fvyshkov/newton/truss/README.md

# Truss-вариант 8" f/5.9 Dobsonian

Альтернатива сонотубу: разборная ферменная конструкция на 4 алюминиевых трубках. Цель — лёгкая транспортировка, простая коллимация, материалы доступные в Израиле без AliExpress.

📘 **Сборка по шагам (без слов, картинками):** [`truss_assembly_comic.pdf`](truss_assembly_comic.pdf)

## Оптика (исходные данные)

| Параметр | Значение |
|---|---|
| Главное зеркало | 203мм (8") |
| Фокусное расстояние | 1200мм (f/5.91) |
| Вторичное зеркало | 50мм малая ось |
| Окуляры | 25мм и 10мм, 1.25" |
| Фокусер | геликоидный (как в основном проекте, можно перепечатать) |

## Архитектура

```
        ┌───────────────────┐    ← UTA (Upper Tube Assembly)
        │   ●─── focuser    │      ID 240мм, h ≈ 130мм
        │  ╱│╲              │      держит вторичку (паук) + фокусер
        │ paук              │
        └─┬─┬─┬─┬───────────┘
          │ │ │ │              ← 4 стойки, L ≈ 900мм
          │ │ │ │                Ø22-28мм (универсальный сокет
          │ │ │ │                с хомутным зажимом)
          │ │ │ │
        ┌─┴─┴─┴─┴───────────┐
        │                   │  ← Mirror box (открытая рамка)
        │   [ оправа ]      │     250×250мм, h ≈ 120мм
        │                   │     держит оправу зеркала + truss
        └───────────────────┘
                │
                ▼
            (rocker box — основание Добсона, отдельно)
```

## Расчёт оптической геометрии

### Расстояние secondary → focal point (D2)

| Элемент | мм |
|---|---|
| Полу-ID UTA (от оси трубы до стенки) | 120 |
| Толщина стенки UTA (печатная) | 10 |
| Седло фокусера (на стенке UTA) | 10 |
| Тело фокусера (внешний корпус) | 60 |
| Inner tube фокусера, среднее положение | 30 |
| От верха inner до полевой диафрагмы окуляра | 10 |
| **D2 итого** | **~240** |

### Расстояние primary → secondary (D1)

```
D1 = f − D2 = 1200 − 240 = 960 мм
```

### Длина truss-трубок

| Элемент | мм |
|---|---|
| От поверхности зеркала до верха mirror box (где сидят трубки) | 80 |
| От низа UTA (где сидят трубки) до центра вторички | 80 |
| Полезный пролёт между сокетами | 800 |
| Захват в сокете (×2 конца, по 50мм) | 100 |
| **Длина трубки** | **900** |

## Список деталей

### Покупное (Израиль, локально)

**Стойки — выбрать одно из:**

| Вариант | Диаметр | Где | Цена за 4шт |
|---|---|---|---|
| Алюм. ручка от швабры (приоритет) | Ø22-24мм | Ace, חזק, супермаркет | ₪40-80 |
| Алюм. карниз для душа (НЕ телескопический) | Ø25мм | Home Center, хозмаг | ₪60-100 |
| Деревянная ручка швабры (бук/берёза) | Ø25-28мм | везде | ₪40-60 |

Длина каждой стойки = 1000мм (с запасом для отпила в размер 900мм).

**Остальное:**

| Деталь | Кол-во | Где взять |
|---|---|---|
| Болты M5×30 (зажим стоек в сокетах) | 4 | хозмаг |
| Барашковые гайки M5 | 4 | хозмаг |
| Фанера 12-15мм для rocker box | 1 лист | Home Center, столярка |
| Войлок/тефлон для подшипников Добсона | — | хозмаг |

### Печать (3D)

| Деталь | Кол-во | Назначение |
|---|---|---|
| `Mirror_box.stl` | 1 | нижняя клетка-короб 290×290мм с 3 отверстиями под вертикальные болты M5 крепления оправы |
| `Truss_socket.stl` | 8 | клипса-зажим под стойку (4 на mirror box + 4 на UTA, деталь одинаковая) |
| `Mirror_cell_back_truss.stl` | 1 | задняя плита оправы заодно с 3 ножками: ставится в коробку, садится углублениями на бобышки дна, притягивается 3 болтами M5 снизу. Заменяет старую `Mirror_cell_back` + отдельные кронштейны. Регулировка — штатным push-pull |
| `UTA_ring.stl` | 1 | верхнее кольцо с сокетами под стойки, посадка фокусера |
| `Spider_4vane.stl` | 1 | 4-лопастной паук под ID 240мм |
| `Secondary_holder.stl` | 1 | держатель вторички с коллимацией |
| **Итого** | **13** | — |

> `Cell_leg_bracket.stl` (отдельный кронштейн ×3) — устарел, объединён в `Mirror_cell_back_truss.stl`.

### Переиспользуется из старого проекта без изменений

| Деталь | Откуда |
|---|---|
| `Mirror_cell_front.stl` | `/Users/mac/newton/stl/mirror_cell/` |
| Фокусер (комплект из 7 деталей) | `/Users/mac/newton/stl/` |
| Push-pull коллимация (M5×20, M5×50, гайки, барашки) | уже куплено |

### Принципы крепления трубок

Каждая трубка вставляется в печатный сокет на ~50мм глубину, фиксируется одним сквозным болтом M5 с барашковой гайкой. Снять/поставить = открутить 8 барашков. Коллимация сохраняется, потому что геометрия задаётся жёсткими углами mirror box и UTA, а не положением трубок.

## Что дальше

1. Сгенерировать чертежи каждой печатной детали (Python → STL)
2. Mirror cell под открытую раму (без трубы) — переделать крепление
3. UTA кольцо — рассчитать положение фокусера на стенке
4. Паук — 4 лопасти вместо 4-в-крест (одна и та же геометрия)
5. Rocker box — фанера, отдельные чертежи под пилу
