fvyshkov/newton/stl/README.md

# Что печатаем

12 деталей, сгруппированы по требованиям к печати.

## 🔬 Группа A — резьба и точные посадки

**Профиль:** 0.4мм сопло · 0.2мм слой (для резьбы можно 0.1мм) · **6-8 периметров** · 25-30% заполнение · ориентация важна

Главное — стенки и качество слоя, чтобы резьба не закусывала. Часть деталей образует резьбовую пару — их **печатать вместе, той же катушкой и теми же параметрами**, иначе посадка может не сойтись из-за разной усадки.

| Файл | Размер (мм) | Кол-во | Время | Заметки |
|---|---|---|---|---|
| `Focuser inner.stl` | 90×71×71 | 1 | ~5 ч | Внутренняя труба с **внешней резьбой**. Ось Z = ось резьбы |
| `Focuser outer top.stl` | 102×90×23 | 1 | ~3 ч | Верхняя половина корпуса с внутренней резьбой |
| `Focuser outer bottom.stl` | 101×90×37 | 1 | ~4 ч | Нижняя половина корпуса |
| `Focuser ring.stl` | 81×81×15 | 1 | ~2 ч | Кольцо резьбового сопряжения |
| `Collet.stl` | 59×59×28 | 1 | ~1.5 ч | Цанга, прорези должны быть чёткими |
| `Collet nut.stl` | 88×88×13 | 1 | ~2 ч | Гайка цанги, внутренняя резьба |
| `1.25 eyepiece adapter.stl` | 55×55×47 | 1 | ~2 ч | Скользящая посадка в цангу |

**Итого группа A:** 7 деталей, ~20 ч.

## 🔧 Группа B — стандартная механика

**Профиль:** 0.4мм сопло · 0.2-0.3мм слой · **4-5 периметров** · 20-25% заполнение · поддержки НЕ нужны

Никакой резьбы, обычные крепёжные/функциональные детали.

| Файл | Размер (мм) | Кол-во | Время | Заметки |
|---|---|---|---|---|
| `Secondary holder.stl` | 57×57×69 | 1 | ~5 ч | Держатель вторички, печатать на боку (большая площадь к столу) |
| `Focuser grub.stl` | 37×20×52 | 1 | ~1 ч | Фиксатор окуляра |
| `Focuser grub screw panel.stl` | 82×9×42 | 1 | ~1 ч | Тонкая, можно увеличить заполнение до 40% |
| `Focuser saddle.stl` | 101×90×11 | 1 | ~2 ч | Седло между фокусёром и трубой (компенсирует кривизну OD 258мм). Печатать **плоской стороной вверх** (вогнутое дно — на стол с поддержками), 4 периметра, 25% заполнение. Сгенерирован `gen_focuser_saddle.py` |

**Итого группа B:** 4 детали, ~9 ч.

## 🕸️ Группа C — крупное, тонкие лопасти

**Профиль:** 0.6мм сопло · 0.2-0.3мм слой · **5-6 периметров** · 20% заполнение · печать плашмя (лопасти параллельно столу)

| Файл | Размер (мм) | Кол-во | Время | Заметки |
|---|---|---|---|---|
| `Spider.stl` | 250×250×25 | 1 | ~8 ч | Лопасти 3мм — стенки критичны, иначе будут вибрировать. **Brim 5мм** для адгезии — деталь длинная, склонна отрываться |

**Итого группа C:** 1 деталь, ~8 ч.

## 🪞 Группа D — оправа главного зеркала (опционально, вместо фанеры)

**Профиль:** 0.4мм сопло · 0.2мм слой · **8+ периметров** · 30-40% gyroid · поддержки НЕ нужны · PETG-HF или ASA (НЕ PLA — ползёт под нагрузкой)

Заменяет фанерные пластины из Фазы 3 (Stellafane). Сгенерированы из `mirror_cell/generate_mirror_cell.py`. Все 6 коллимационных отверстий — клиренс под M5 (Ø6мм), резьбы нет, собирается болтами с гайками как фанерный вариант. Раскладка: 6 болтов равномерно через **60°** по кругу, чередуются push и pull. Push (внутреннее кольцо) r=70мм на углах 0°/120°/240°, pull (внешнее кольцо) r=89мм на углах 60°/180°/300° — радиусы по Stellafane-пропорциям, позиции идентичны на обеих деталях, болты идут насквозь.

| Файл | Размер (мм) | Кол-во | Время | Заметки |
|---|---|---|---|---|
| `mirror_cell/Mirror_cell_front.stl` | 215×215×16 | 1 | ~9 ч | Круглая пластина под зеркало. На верхней стороне 3 встроенных mirror-retention уголка (стеночки 3×20×8мм на радиусе 104.5мм, страховка зеркала от съезжания). Печать плашмя плитой вниз, уголки кверху — поддержек не нужно |
| `mirror_cell/Mirror_cell_back.stl` | 241×241×8 | 1 | ~10 ч | Y-плита, 3 уша до Ø250 = ID трубы. 3 сквозных радиальных Ø5.5мм отверстия в торцах ушей (по центру толщины) — под M5×12 насквозь через стенку трубы. Печать плашмя |

**Итого группа D:** 2 детали, ~20 ч.

---

## Сводка

| Группа | Деталей | Время | Что важно |
|---|---|---|---|
| A (резьба) | 7 | ~20 ч | Точность слоя, стены 6-8, печатать одной катушкой |
| B (механика) | 4 | ~9 ч | Стандартные настройки |
| C (паук) | 1 | ~8 ч | Brim, ориентация плашмя, стены 5-6 |
| D (оправа, опционально) | 2 | ~20 ч | PETG/ASA, стены 8+, gyroid 30-40% |
| **Итого без D** | **12** | **~37 ч** | базовый комплект (с фанерной оправой) |
| **Итого с D** | **14** | **~57 ч** | полностью печатный (без фанеры) |

## Материал

PLA или PETG. PETG прочнее и термостабильнее (внутри трубы летом может быть жарко), но капризнее по адгезии и стрингу. PLA проще и сходится с первого раза — для нашей задачи нормально.

**Цвет:** не важен. Внутренние поверхности (что видят свет) красятся матовой чёрной аэрозолью после печати — это эффективнее, чем чёрный пластик.

## Ручки коллимации

Knob.stl **удалён** — заменён барашковыми гайками M5 (5 шт уже куплены на Galboreg). Барашки удобнее: металл, не ломаются, доступны на ощупь в темноте.

## Паук — кастомный

`Spider.stl` сгенерирован под сонотуб ID 250мм (оригинал Leavitt — 226мм, не дотягивается). Если понадобится другой диаметр — скажи, перегенерирую.
