fvyshkov/newton/NEW_AZIMUTH_BRIEF.md

# Памятка: новая (альтернативная) конструкция азимута

Передать в сессию, открытую в проекте `/Users/mac/newton`. Ниже — всё, что нужно,
чтобы начать с нуля. Задача обсуждалась отдельно; здесь полный контекст.

## Задача

Разработать **другую (альтернативную) конструкцию узла азимута** (поворот по горизонтали, yaw)
для этого же Добсона/телескопа. **Всё делать в НОВОЙ отдельной папке** внутри проекта
(например `truss/azimuth2/` или `azimuth_v2/` — имя согласовать). Существующий азимут не трогать.

Проект — Python-CAD (STL генерируются из `generate_*.py`, venv `/Users/mac/newton/.venv-cad`).
Новую конструкцию делать в **той же идиоме и том же CAD-фреймворке**, что существующий азимут.

## Опорные размеры — взять из уже напечатанного азимута

Диаметр венцов новой конструкции должен быть **примерно как у уже напечатанного** азимута.
**Первым делом прочитать существующий азимут и вытащить точные числа**, файлы:
- `truss/generate_rocker_azdrive.py` — привод/венец азимута (главный источник: диаметр венца, модуль зубьев)
- `truss/generate_rocker_azbench.py`
- `truss/generate_rocker_motor_bracket.py`, STL `Rocker_pinion_16T*`, `Rocker_az_motor_plate` — мотор + шестерёнка (pinion 16T)
- `truss/rocker_plan.md`, `truss/README.md` — план и параметры
- Энкодер: `gen_encoder_holders.py`, `gen_encoder_mounts_pdf.py`, `stl/encoder/magnet_cap_azimuth.stl`, `board_holder.stl` — чип энкодера, размер магнита, зазор
- Верх/седло: `gen_focuser_saddle.py`, `truss/gen_stud_mount_diagram.py`, `truss/stl/Rocker_ring_saddle*`, `Rocker_cradle*`, `Rocker_alt_roller`

Нужно из них извлечь: диаметр венца (внутр/наруж/делительный), высоту/толщину колец, модуль и число
зубьев, тип/модель мотора, передаточное, размер магнита энкодера (обычно ⌀6×2.5 диаметральный) и
зазор до чипа, зазоры/допуски печати, материал.

## Механика новой конструкции (согласованное понимание)

Это **осевой (торцевой) поворотный подшипник типа «ленивая Сюзанна»** — два кольца-венца
**лежат друг на друге** (контакт по плоским торцам), НЕ вложены сбоку.

- **Внешний венец = неподвижная обойма**, прикручен к фанере. (Что считать «внешним/внутренним»
  условно — они одного порядка по диаметру и лежат друг на друге.)
- **Второй венец вращается** и несёт нагрузку.
- **Ограничитель (центрирующий буртик):** у НЕПОДВИЖНОГО кольца буртик на **ВНУТРЕННЕЙ** окружности —
  он центрирует вращающееся кольцо (не даёт уехать в сторону). На **ВНЕШНЕЙ** окружности
  ограничителя быть НЕ должно.
- **Зубья** — на **ВНЕШНЕЙ** окружности, торчат **наружу** (открыты). Их крутит **шестерёнка (pinion)**.
  Открытый наружу венец = шестерёнке легко зайти.
- **Мотор — на фанере (неподвижно).** Шестерёнку можно посадить **не прямо на вал мотора, а через
  штифт/отдельный вал** (на усмотрение — вероятно так лучше: опора шестерёнки жёстче, меньше биения).
- **Скольжение — тефлон.** По всему периметру между торцами колец — **пятачки** (сколько нужно,
  НЕ три, а много, равномерно по кругу) + тефлоновая подложка → гладко, без люфта.
- **Вращающаяся часть — очень лёгкая:** на ней держится только **магнит** энкодера.
  Всё тяжёлое (мотор, плата/микросхемы, энкодер) стоит на фанере, неподвижно.
- **Магнит энкодера — на оси (по центру)** вращающегося кольца; чип энкодера снизу на фанере читает
  абсолютный угол.
- На вращающемся кольце — **гнёзда под стойки-палки (3 или 4)**, уходят вверх, держат **седло**.

Разрез:

```
        седло  ▲ ▲ ▲     ← 3–4 стойки вверх
     ┌──┴─┴─┴──┐
     │ ВРАЩАЕТСЯ │        ← лёгкое, несёт магнит по центру; зубья снаружи ►
  ═══╡  венец    ╞═══◄ шестерёнка (мотор на фанере, через штифт)
  ║  └[тефлон-пятачки по кругу]┘  ║
  ║  НЕПОДВИЖНЫЙ венец, буртик по ВНУТР. окружности, на фанере ║
  ═══════════════════════════════════════
  ── фанера ──   энкодер+магнит(центр)
```

## Верх (как обычно)

Сверху всё стандартно для этого мода: на седле — **колёса/ролики**, на них лежит **телескоп** (труба),
и т.д. Взять интерфейс седла/колёс из существующих `Rocker_ring_saddle*` / `Rocker_alt_roller` /
`Rocker_cradle*`.

## Что уточнить перед моделированием

- Имя новой папки.
- 3 или 4 стойки; диаметр палок и окружность посадки (PCD).
- Модуль зубьев / число зубьев pinion (взять как в существующем, если не менять).
- Мотор: тот же, что в существующем азимуте, или другой.
- Штифт под шестерёнку: диаметр, подшипник/опора.
- Материал печати и допуски (взять проектные).

## Порядок действий для новой сессии

1. Прочитать перечисленные файлы существующего азимута, выписать реальные числа.
2. Показать пользователю извлечённый спец (особенно **диаметр венца**) и уточнить открытые пункты.
3. Создать новую папку, написать генератор в стиле проекта, собрать STL, показать превью.
