fvyshkov/newton/plywood_cuts_a4.pdf

# ВЫПИЛЫ ИЗ ФАНЕРЫ 18 мм

## Ньютон 200/1200 Dobson · Stellafane-стиль · масштаб видов 1:10 · размеры в мм

## 1. ОПРАВА ЗЕРКАЛА (Seronik-style) · 2 детали

## Передняя пластина

### 1 шт

### круг Ø 215 · вент. отв. Ø 60

3 нажимных Ø 6 на R=71 (по ушам Y) 3 прижимных Ø 6 на R=56 (между ними)

## Задняя Y-пластина

### 1 шт

### 3 уха вписаны в Ø 250 (= ID трубы)

6 сквозных Ø 6 (совпадают с передней) 3 отв. Ø 5 в ушах (R=115) под шурупы

## 2. ЛЮЛЬКА (кольца+бруски) + ВЫСОТНЫЕ ПОДШИПНИКИ · 3 детали

## Кольцо люльки

### 2 шт (одинаковые)

### OD 320 · ID 262 (= труба + 4мм)

4 отв. Ø 4 на R=146 (под брус 30×30)

### 2 кольца соединить брусками 30×30×400мм

## Диск подшипников

### 1 диск → 2 полукруга

### круг Ø 440 (= 1.7×OD трубы)

распилить пополам → 2 полукруглых подшипника 3 отв. Ø 4 в каждой половине к боку люльки обклеить торец PTFE-полосой 25 мм

## 3. РОКЕР-БОКС · 4 детали

## Боковая стенка

### 2 шт

310 × 600
вырез R=222, глубина ≈ 63мм 2 PTFE через 80° на дуге

## Передняя стенка

### 1 шт

350 × 500
саморезы в торец боковин (4×60)

## Дно рокера (круг)

### 1 шт

### круг Ø 470

центр Ø 10 под M10
сверлить вместе с ground board

## 4. GROUND BOARD (опорная плита) · 1 деталь

## Ground board · 1 шт

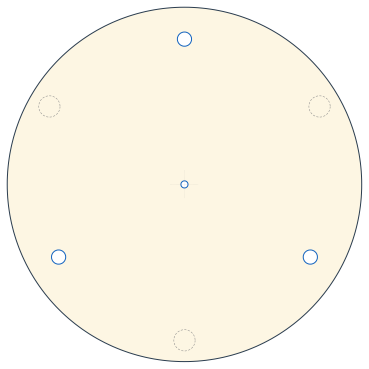
[picture p1: figure]

### круг Ø 500

центр Ø 10 под ось M10
3 PTFE на R=205 через 120° пунктир — 3 рез. ножки на R=220

## РАЗМЕРЫ ПО STELLAFANE (полные, без компромиссов):

- Подшипники: 1 диск Ø 440 (= 1.7×OD трубы)
распилить пополам → 2 полукруглых
- Рокер высокий 600мм (балансная точка + 70мм)
- Передняя стенка 350×500
- Дно рокера круг Ø 470
- Ground board круг Ø 500
Сумма площади всех деталей ≈ 1.5 м². Помещается на одном листе 1500×1500 или 1220×2440 (стандартный 4'×8').

Формулы: stellafane.org/tm/dob/mount/cut.html
Цели: mirror 8" / труба ID250 OD258 / 18мм ply

Замечания:
- Дно рокера и ground board сверлить Ø10 совместно (=одной операцией) — иначе ось не сойдётся.
- Кромки P120 → P400. На торец подшипников и рокер-выреза наклеить PTFE (или Ebony Star) — это азимут. подшипник.
