fvyshkov/newton/truss/tubes_spec.md

# Спецификация стоек (4 шт)

Что искать в хозяйственном — критерии и проверки прямо в магазине.

## Обязательные параметры

| Параметр | Значение | Почему |
|---|---|---|
| **Количество** | 4 (плюс 1 запасная, если ценник позволяет) | по углам mirror box и UTA |
| **Длина каждой** | **≥1000мм** (отпилим до 900мм) | расчётная длина 900мм + запас |
| **Диаметр** | **Ø22-28мм** (любой в этом диапазоне) | сокеты сделаю универсальными с зажимом |
| **Все 4 — одинаковые** | один диаметр ±0.5мм, один материал | иначе UTA перекосит, фокусер съедет |
| **Прямые** | без кривизны на просвет | искажение оптической оси |
| **Цельные** | НЕ телескопические, НЕ составные | стык = слабое место и люфт |

## Приоритеты материалов

### 1. Алюминиевая ручка от швабры (приоритет)

- Тип: `מקל אלומיניום למגב` (mahkel aluminum lemagav)
- Обычно Ø22-24мм, длина 1.2-1.5м, цельная труба
- Стенка 1-1.5мм, лёгкая, ровная
- Где: **Ace, חזק, חצרון, супермаркет (хозотдел)**
- Цена: ₪10-20 за штуку
- ✅ Лёгкая (~150г/стойка), ✅ не ведёт от влаги, ✅ ровный диаметр

### 2. Алюминиевый карниз для душевой шторы (нераздвижной)

- Тип: `מוט וילון אמבטיה` (mot vilon ambatia) — **не** `מוט נמתח` (выдвижной)
- Обычно Ø22-25мм, длина 1.5-2м
- Стенка может быть тонкая (0.5-0.8мм) — проверить, мнётся ли пальцами
- Где: **Home Center, Ace, хозмаг**
- Цена: ₪15-25 за штуку
- ⚠️ Часто хромированный — придётся пилить (но это разово)
- ⚠️ Длинный — лишнее надо отпилить

### 3. Деревянная ручка от швабры

- Тип: `מקל עץ למגב` (mahkel etz lemagav)
- **Брать бук/берёзу/дуб**, НЕ сосну (на ярлыке должно быть `אשור`/`ליבנה`/`אלון`; если просто `עץ` — скорее всего сосна)
- Ø25-28мм, длина 1.2-1.5м
- Где: **везде** — Ace, супермаркет, хозмаг
- Цена: ₪10-15 за штуку
- ⚠️ От влажности может слегка вести → покрасить лаком/маслом
- ⚠️ Диаметр гуляет ±0.5мм между палками

## Проверка в магазине

Перед оплатой:

1. **Прямизна**: положить на пол, посмотреть вдоль — не должно быть видимой дуги. Покатить — катится ровно.
2. **Диаметр**: штангенциркулем (если нет — приложить две одну к другой, не должны "качаться"). Все 4 — ±0.5мм одной толщины.
3. **Стенка (для алюминия)**: сжать пальцами в середине — не должна сминаться. Тонкостенная сомнётся в зажиме хомута.
4. **Длина**: одинаковая у всех 4 (продавцу: "כולן באותו אורך").
5. **Целостность**: без вмятин, царапин, ржавчины в стыках.

## Если в магазине нашёл нестандартный диаметр

Сокеты делаю универсальные на Ø22-28мм. Если найдёшь Ø20мм или Ø30мм — пришли фото/спецификацию, я переделаю сокеты под этот размер. Лучше один раз перегенерить детали, чем покупать неподходящие палки.

## Чего НЕ брать

- ❌ ПВХ трубы — мягкие, играют, ведут
- ❌ Стальные трубы — тяжёлые (вся конструкция должна быть лёгкой)
- ❌ Телескопические штанги (любого типа) — стыки люфтят
- ❌ Карнизы с резьбовым/конусным наконечником, который не отвинчивается — мешает зажиму
- ❌ Бамбук — гуляет диаметр, ведёт от влаги сильнее дерева
