fvyshkov/newton/truss/tube_cut_list.md

# Карта распила труб — Ø22 алюминий (штанги-«швабры»), топология v3

Рама v3: углы = 2 хорды (60°), центр → середины хорд. Хорды режутся пополам
(полухорды), к серединам идут радиали от центра. Все узлы — разрезной хомут
с ушками, болт затяжки у входного торца трубы.

## Вращающаяся рама + башни

| ID | откуда → куда | рез, мм  | кол-во |
| --- | --- | --- | --- |
| полухорда | угол → середина хорды | **182** | 6 |
| радиаль | центр → середина хорды | **105** | 3 |
| нога башни передняя | 30→апексR, 150→апексL | **467** | 2 |
| нога башни задняя | 270→апексR, 270→апексL | **529** | 2 |
| поперечина | апекс ↔ апекс | **340** | 1 |

## Неподвижная земля (звезда)

| ID | откуда → куда | рез, мм  | кол-во |
| --- | --- | --- | --- |
| луч земли | ступица → нога | **250** | 3 |

**Итого: 17 отрезков Ø22, ≈4.49 м.**

## Сколько штанг покупать

Раскладка на палки 1000 мм (самый длинный отрезок 529 мм влезает):

- 529 + 467 = 996
- 529 + 467 = 996
- 340 + 250 + 250 + 105 = 945
- 250 + 182 + 182 + 182 + 105 = 901
- 182 + 182 + 182 + 105 = 651

**5 палок × 1000 мм**; купить 6 (на пропилы и ошибки).

## Проверка перед распилом

Труба должна свободно, но без болтанки входить в напечатанный узел (гнездо
Ø22.4). Сначала напечатать один узел, примерить реальную трубу, затянуть винт —
и только потом пилить всю партию. Заход трубы в каждый хомут ~40 мм.
