fvyshkov/newton/images/goto_drive_examples/1_almuz_alt_remen_az_friktsion.jpg

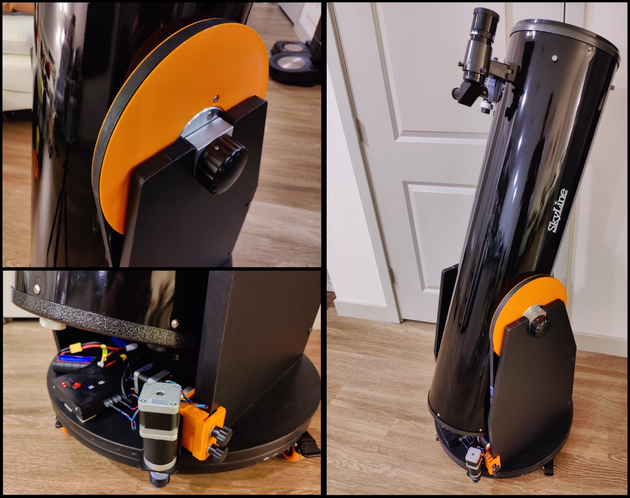
images/goto_drive_examples/1_almuz_alt_remen_az_friktsion.jpg
