fvyshkov/newton/images/goto_drive_examples/2_obe_osi_shesterni_malyi_dob.jpg

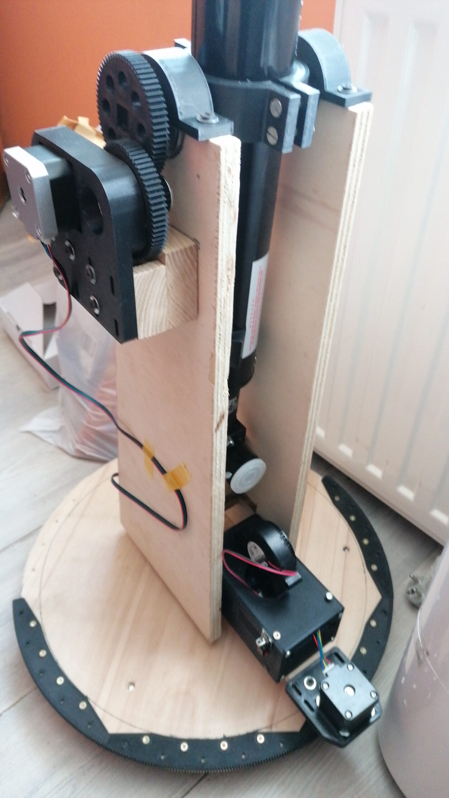
images/goto_drive_examples/2_obe_osi_shesterni_malyi_dob.jpg
