fvyshkov/newton/images/goto_drive_examples/4_motor_remen_kronshtein_sboku.jpg

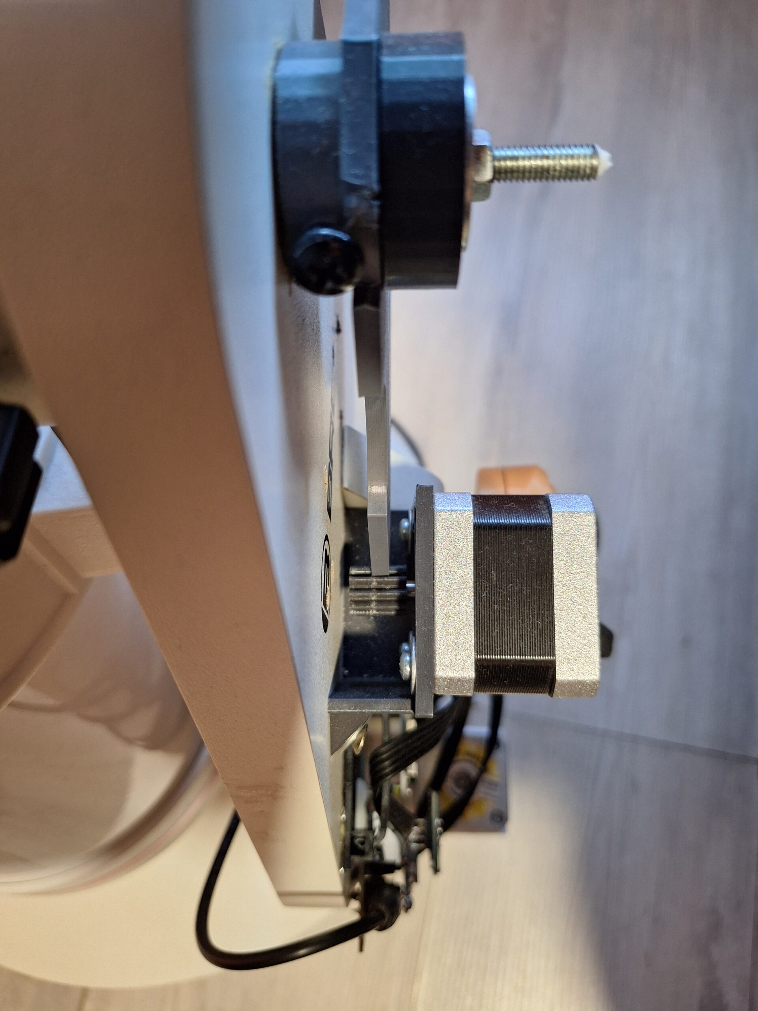
images/goto_drive_examples/4_motor_remen_kronshtein_sboku.jpg
