fvyshkov/newton/images/goto_drive_examples/5_az_venets_po_krugu_osnovaniya.jpg

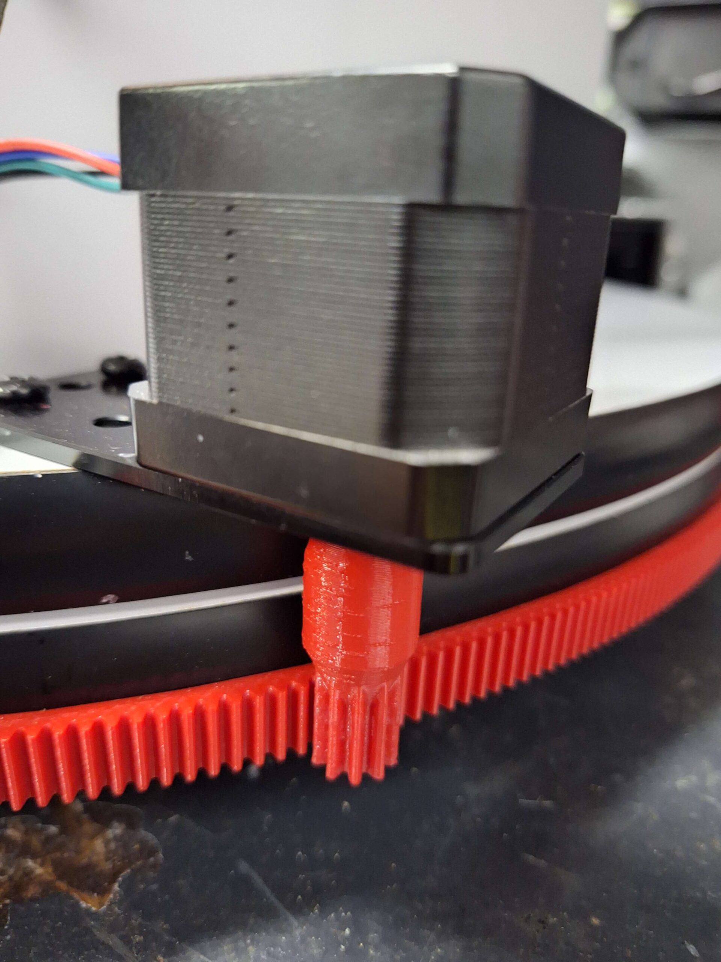
images/goto_drive_examples/5_az_venets_po_krugu_osnovaniya.jpg
