fvyshkov/newton/images/goto_drive_examples/6_az_remen_vnutri_korobki.jpg

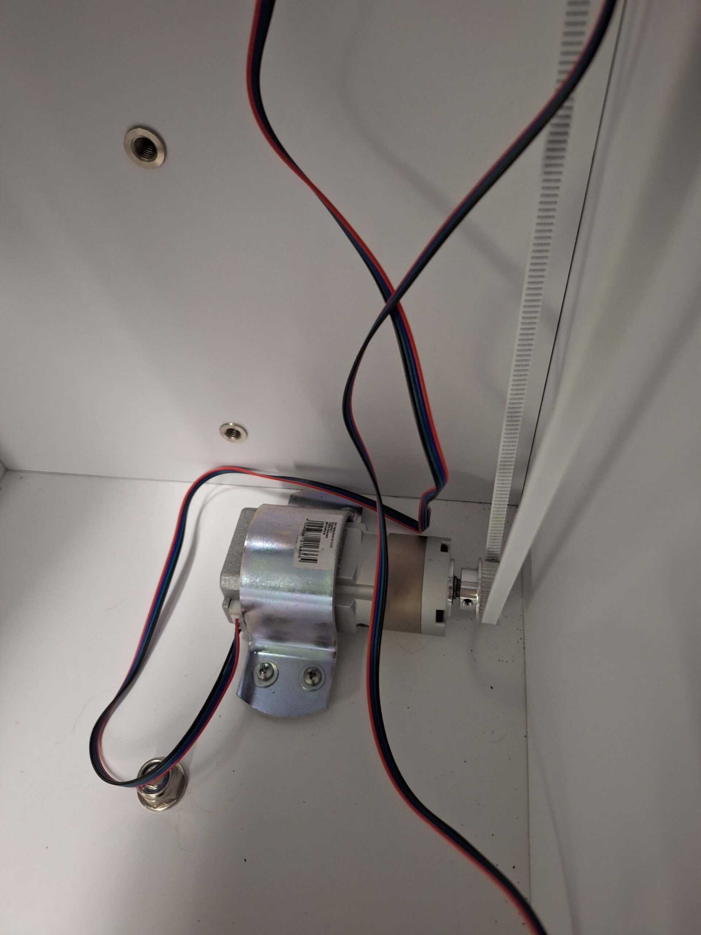
images/goto_drive_examples/6_az_remen_vnutri_korobki.jpg
