fvyshkov/newton/images/goto_drive_examples/7_jessebear_alt_duga_remen.jpg

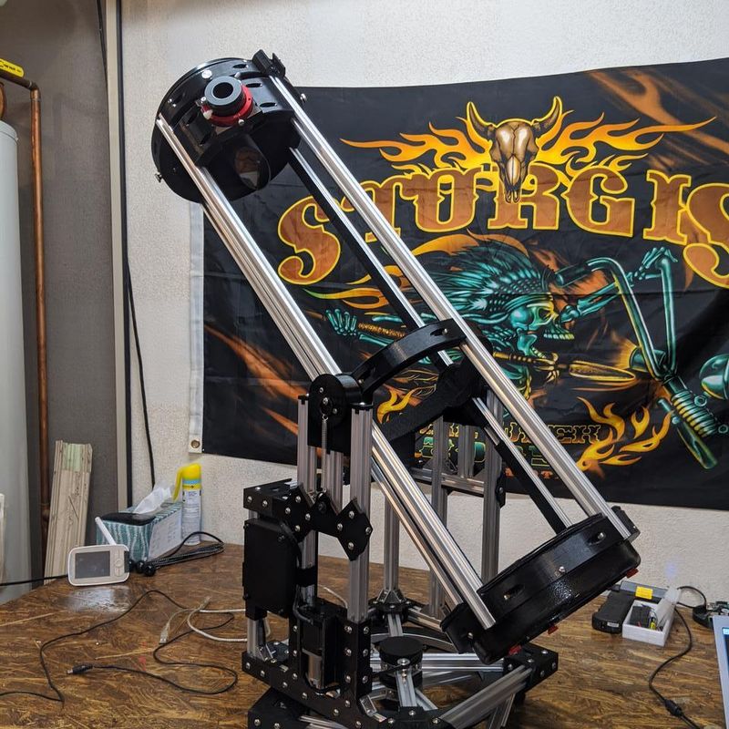
images/goto_drive_examples/7_jessebear_alt_duga_remen.jpg
