fvyshkov/newton/images/minprint_examples/cosmopilot_alt.jpg

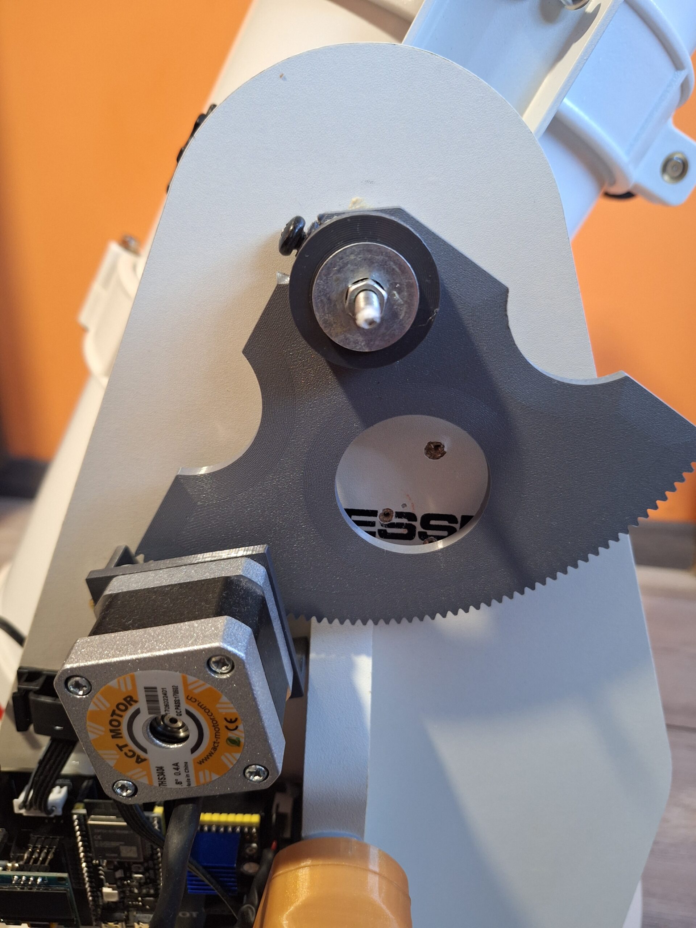
images/minprint_examples/cosmopilot_alt.jpg
