fvyshkov/newton/images/minprint_examples/cosmopilot_skywatcher.png

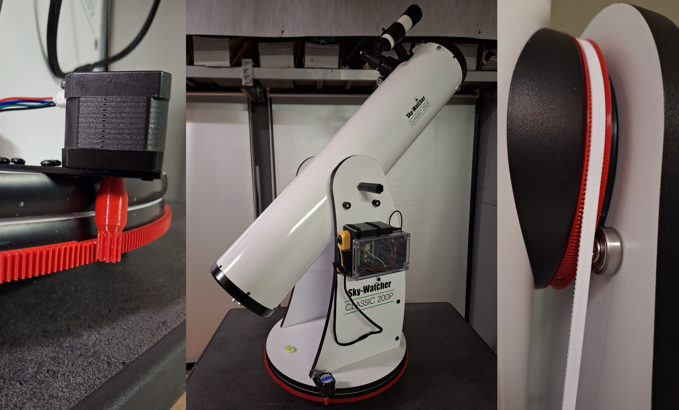
images/minprint_examples/cosmopilot_skywatcher.png
