fvyshkov/newton/images/mirror_cell_back_render_iso.png

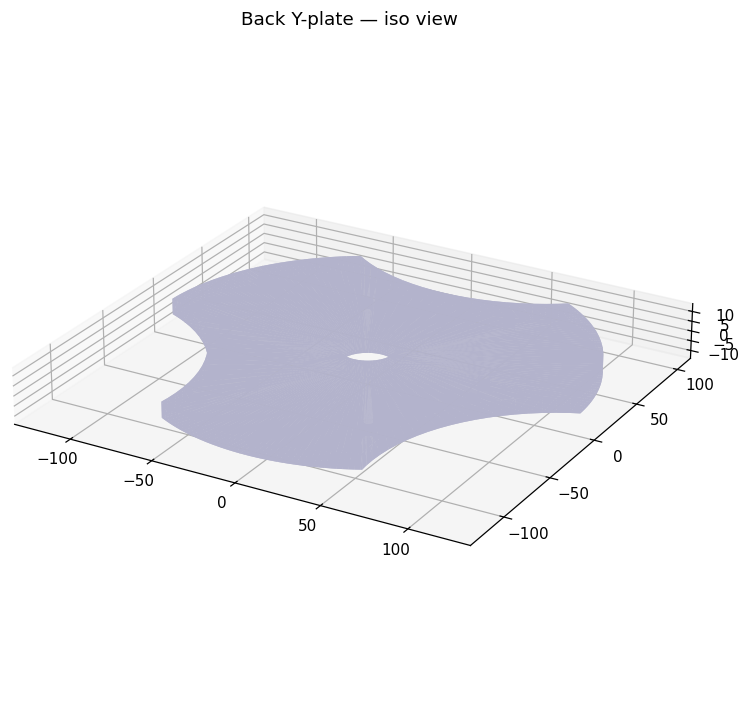
images/mirror_cell_back_render_iso.png
