fvyshkov/newton/images/mirror_cell_back_render_top.png

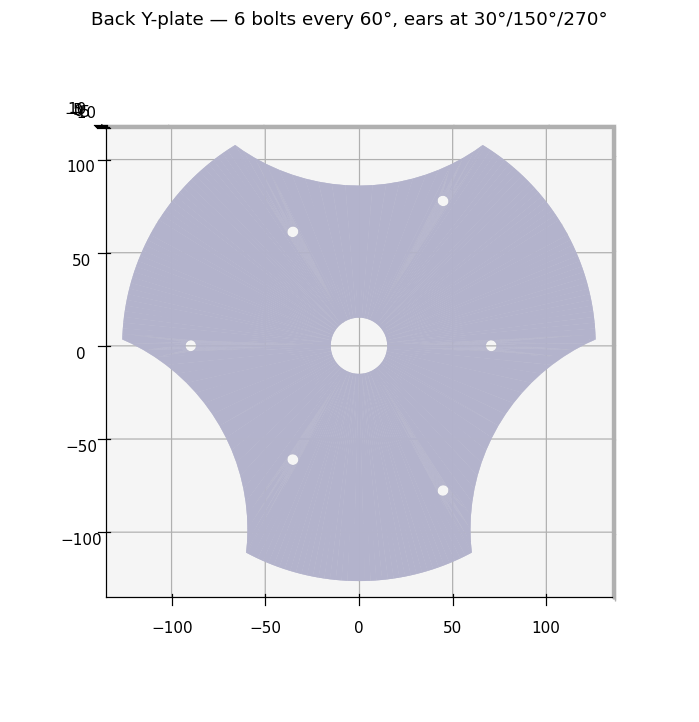
images/mirror_cell_back_render_top.png
