fvyshkov/newton/images/mirror_cell_front_render.png

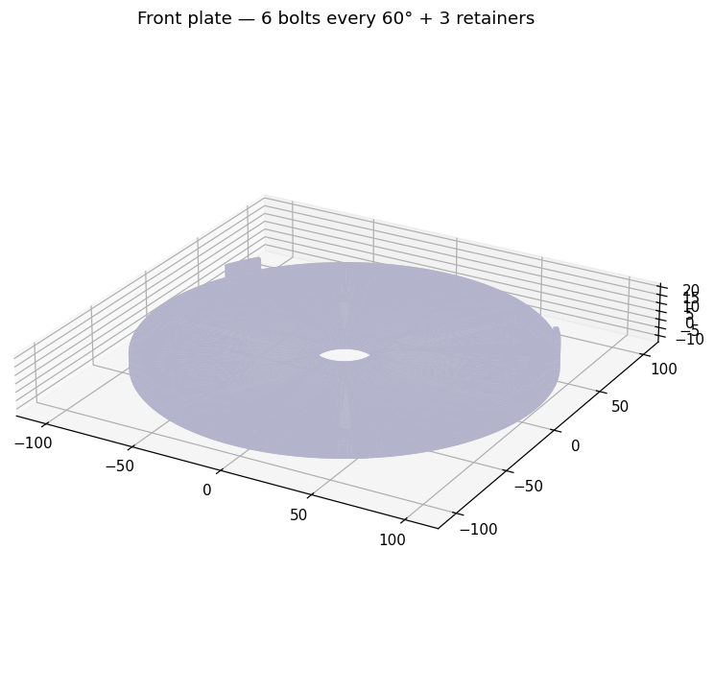
images/mirror_cell_front_render.png
