fvyshkov/newton/images/rocker_examples/dbd_full_dob.jpg

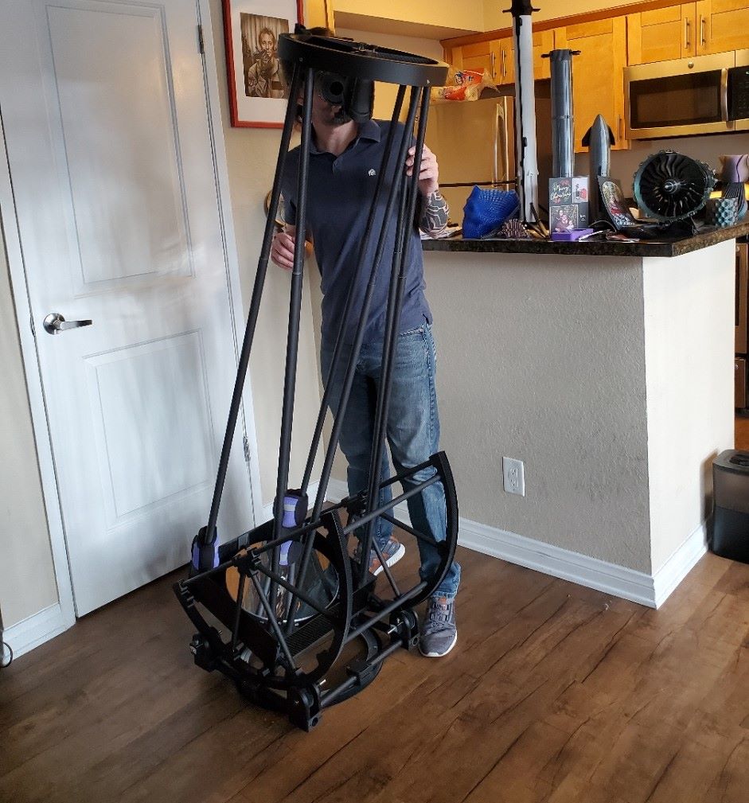
images/rocker_examples/dbd_full_dob.jpg
