fvyshkov/newton/images/rocker_examples/dbd_motor_gear.jpg

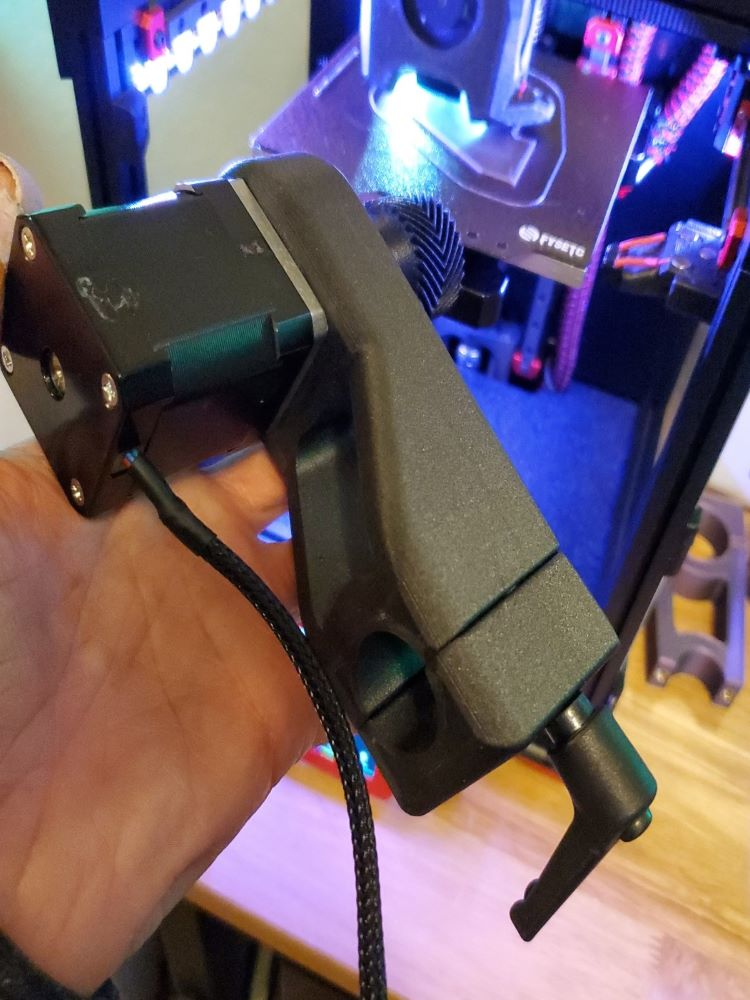
images/rocker_examples/dbd_motor_gear.jpg
