fvyshkov/newton/images/rocker_examples/dbd_spoke_wheel.jpg

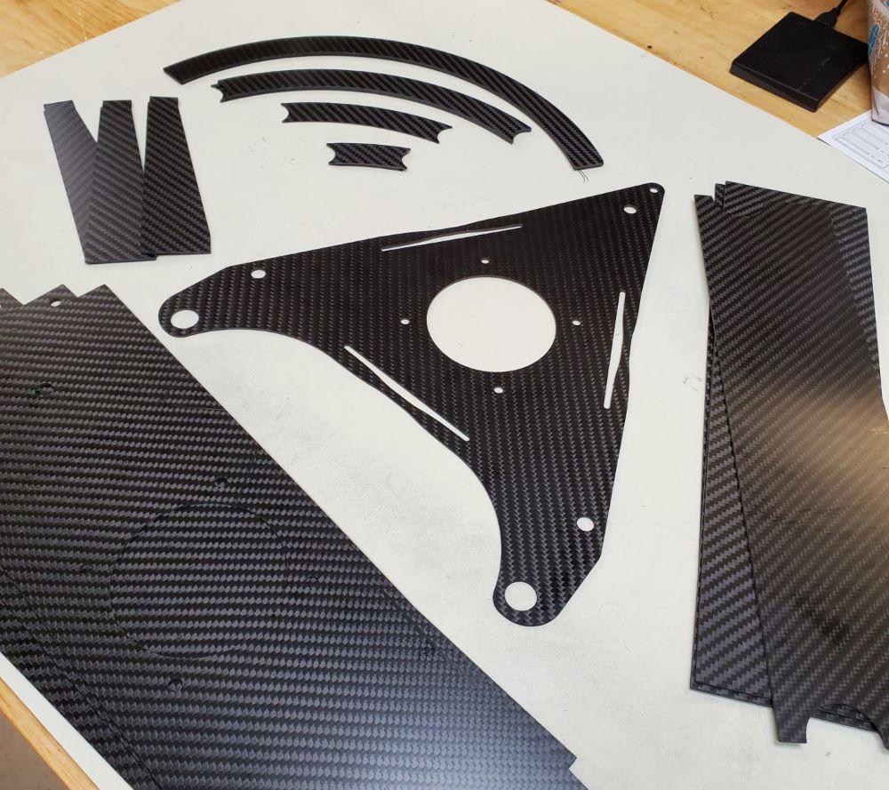
images/rocker_examples/dbd_spoke_wheel.jpg
