fvyshkov/newton/images/rocker_examples/hadley_motorized_base.jpg

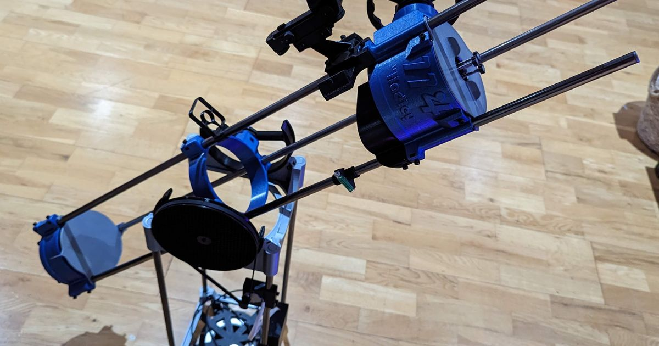
images/rocker_examples/hadley_motorized_base.jpg
