fvyshkov/newton/images/rocker_examples/r2d2_ring_gear_450mm.jpg

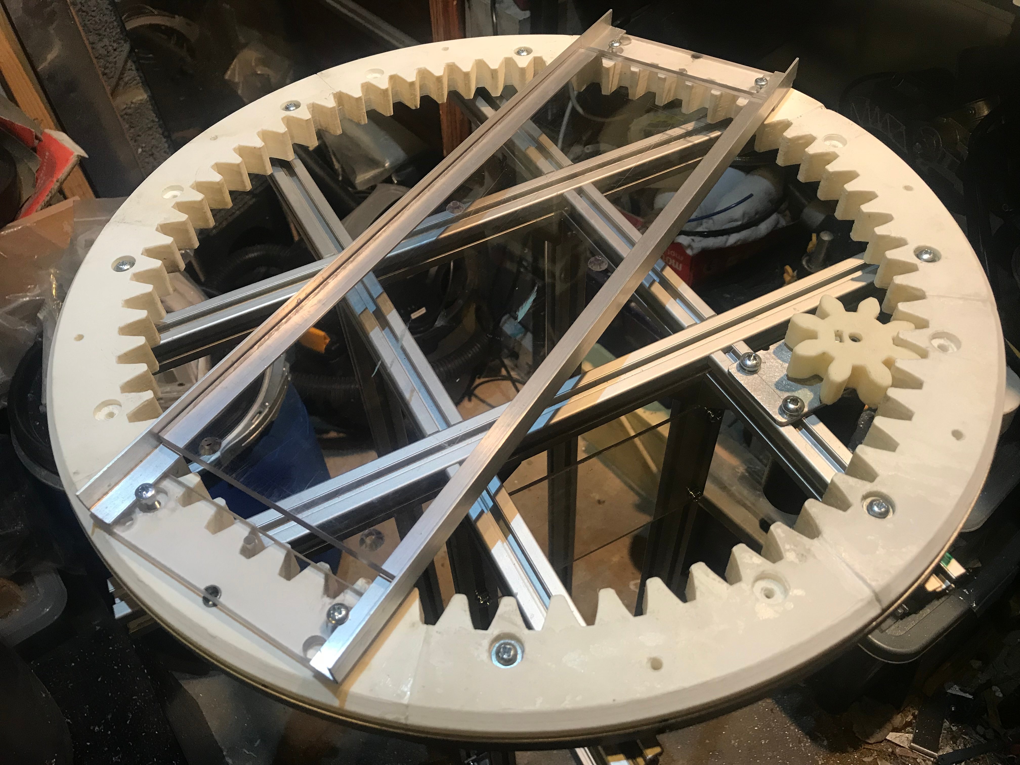
images/rocker_examples/r2d2_ring_gear_450mm.jpg
