fvyshkov/newton/images/seronik_cell_complete.jpg

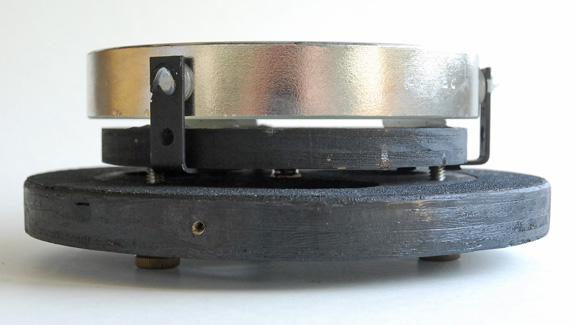
images/seronik_cell_complete.jpg
