fvyshkov/newton/images/seronik_cell_ventilation.jpg

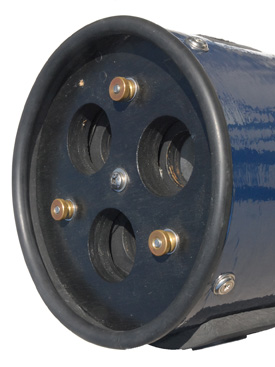
images/seronik_cell_ventilation.jpg
