fvyshkov/newton/images/stellafane_commercial_cells.jpg

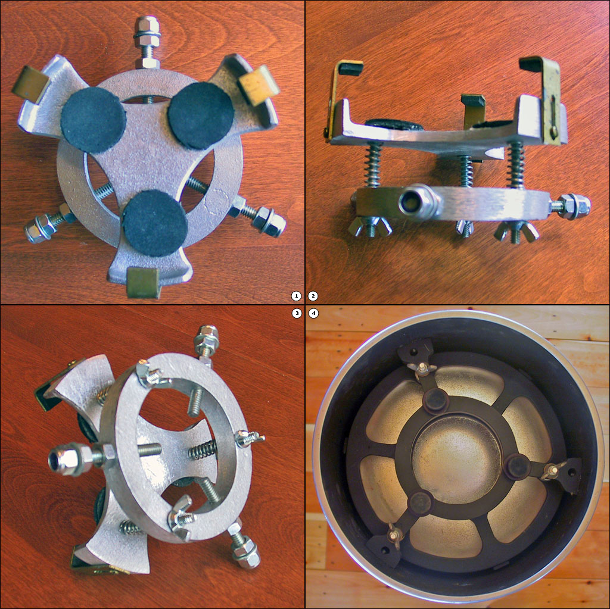
images/stellafane_commercial_cells.jpg
