fvyshkov/newton/images/stellafane_spider_3vane.jpg

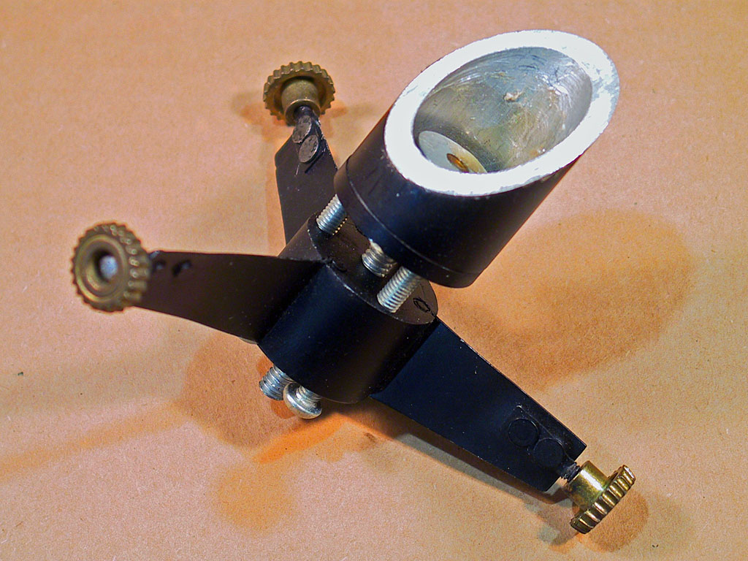
images/stellafane_spider_3vane.jpg
