fvyshkov/newton/truss/_SCHEME_v3.png

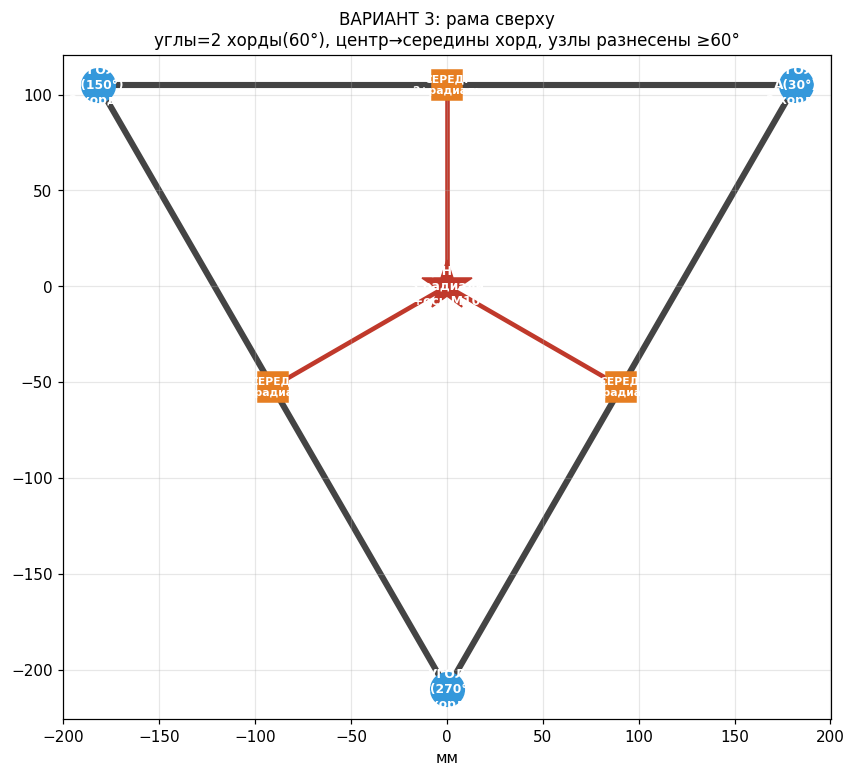
truss/_SCHEME_v3.png
