fvyshkov/newton/truss/alt_encoder_check.png

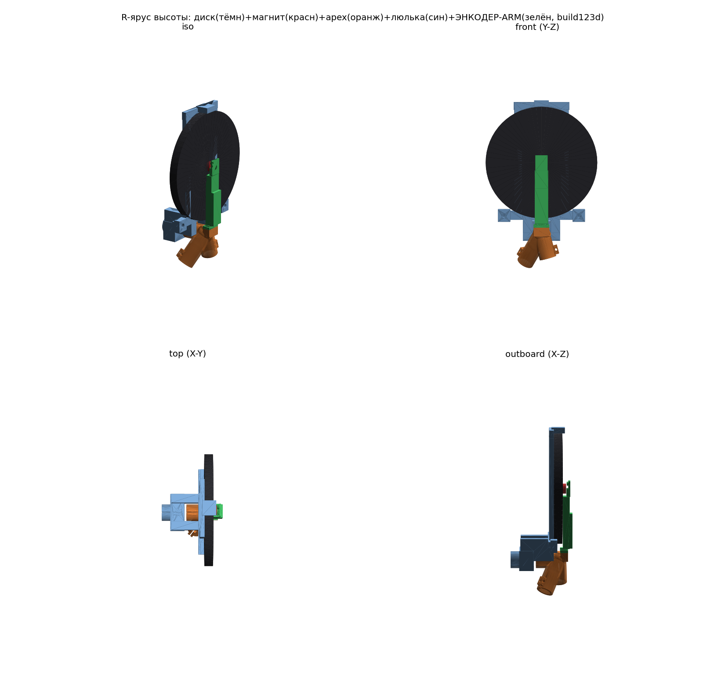
truss/alt_encoder_check.png
