fvyshkov/newton/truss/azimuth2/az2_howworks.png

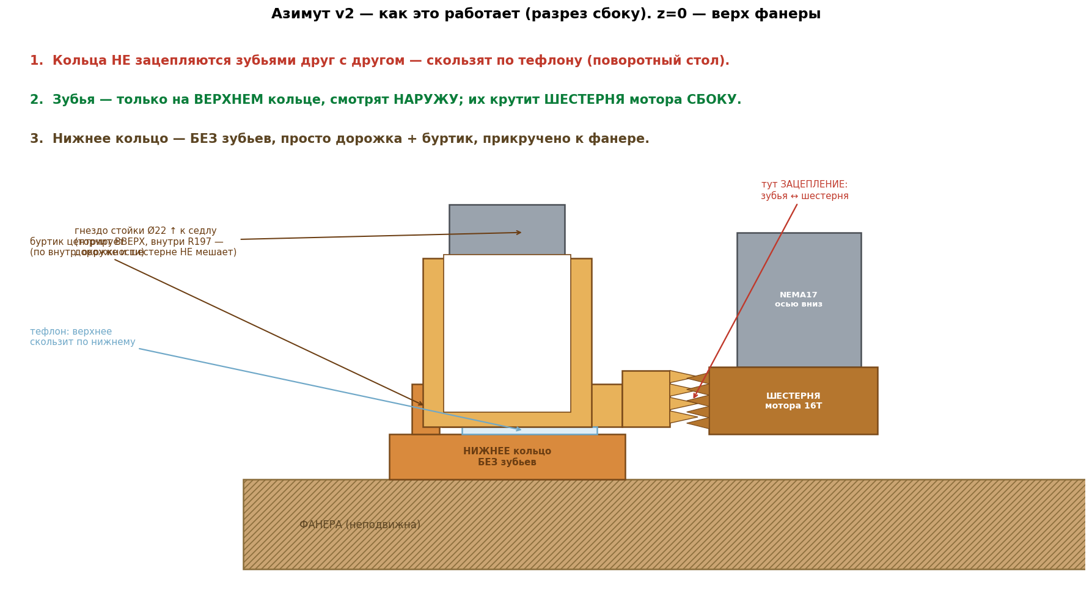
truss/azimuth2/az2_howworks.png
