fvyshkov/newton/truss/azimuth2/az2_legs.png

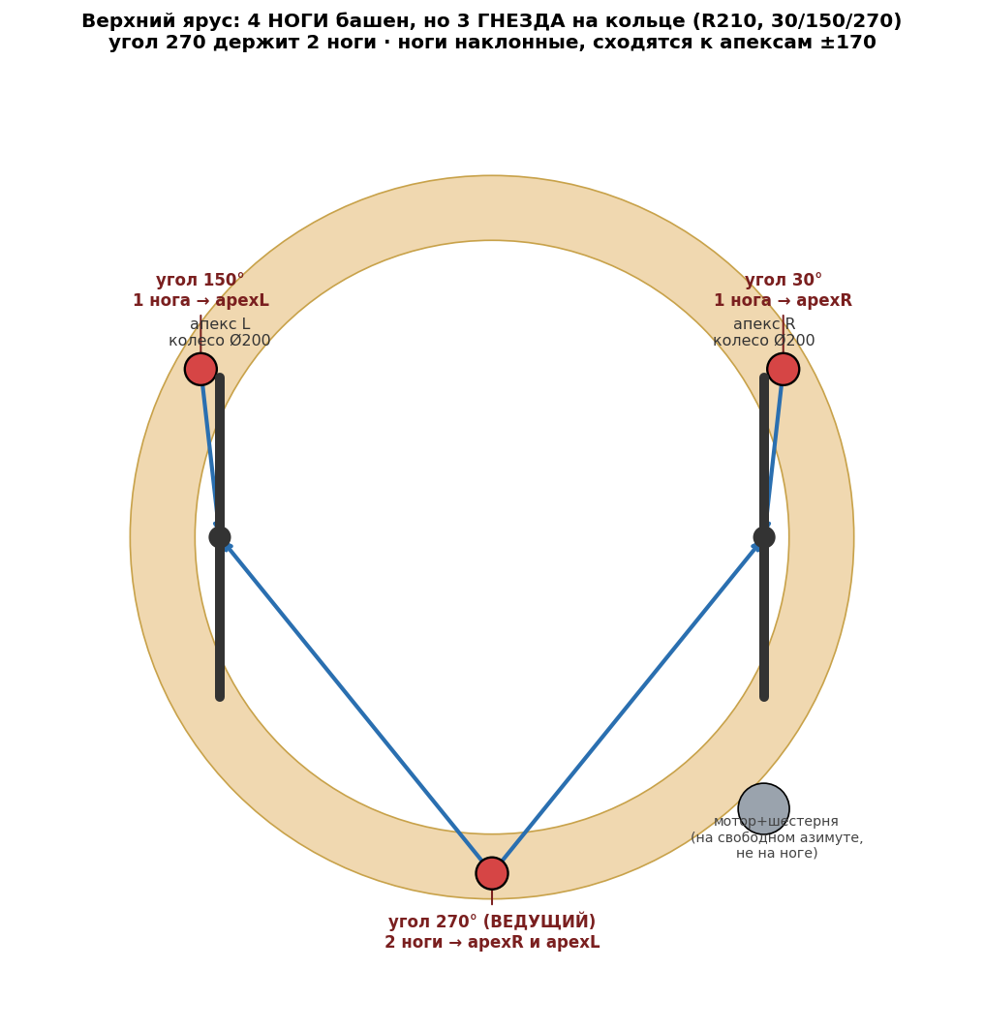
truss/azimuth2/az2_legs.png
