fvyshkov/newton/truss/azimuth2/az2_seg_top.png

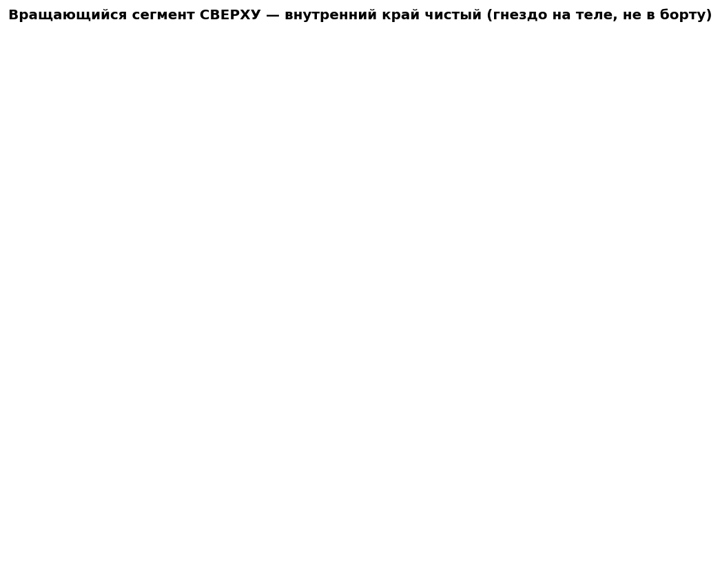
truss/azimuth2/az2_seg_top.png
