fvyshkov/newton/truss/azimuth2/az2_venec_legs_3d.png

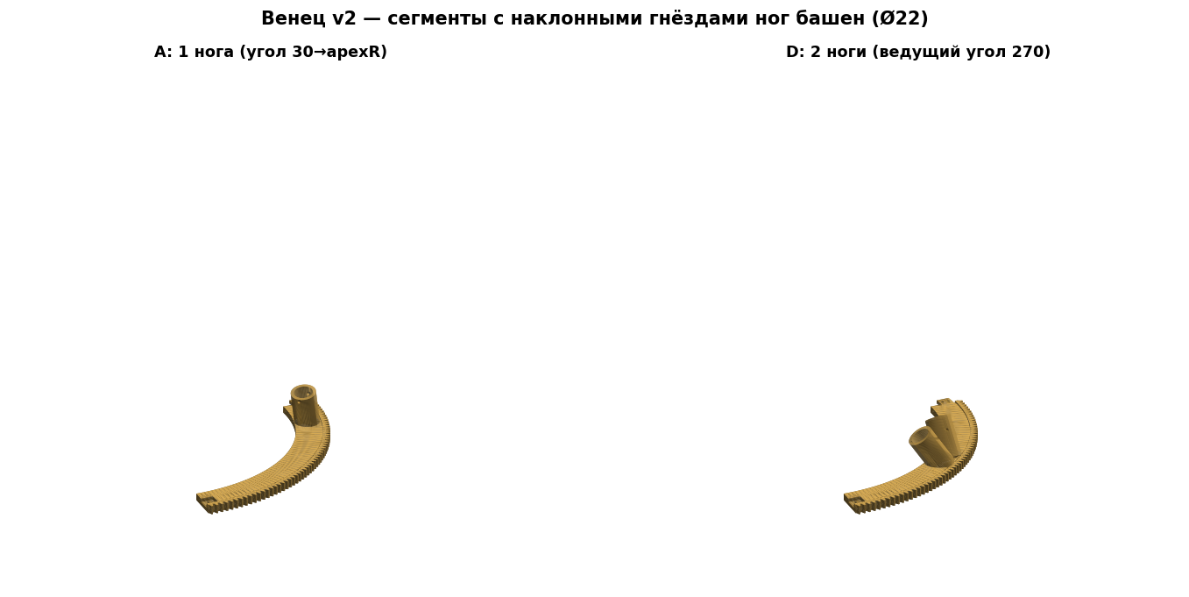
truss/azimuth2/az2_venec_legs_3d.png
