fvyshkov/newton/truss/azimuth_explain.png

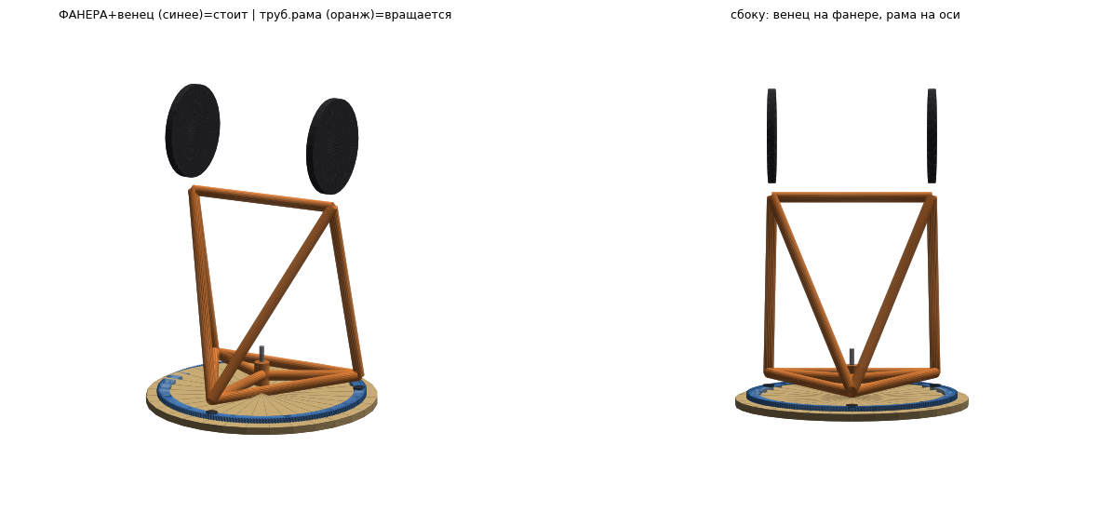
truss/azimuth_explain.png
