fvyshkov/newton/truss/bench_vs_combat.png

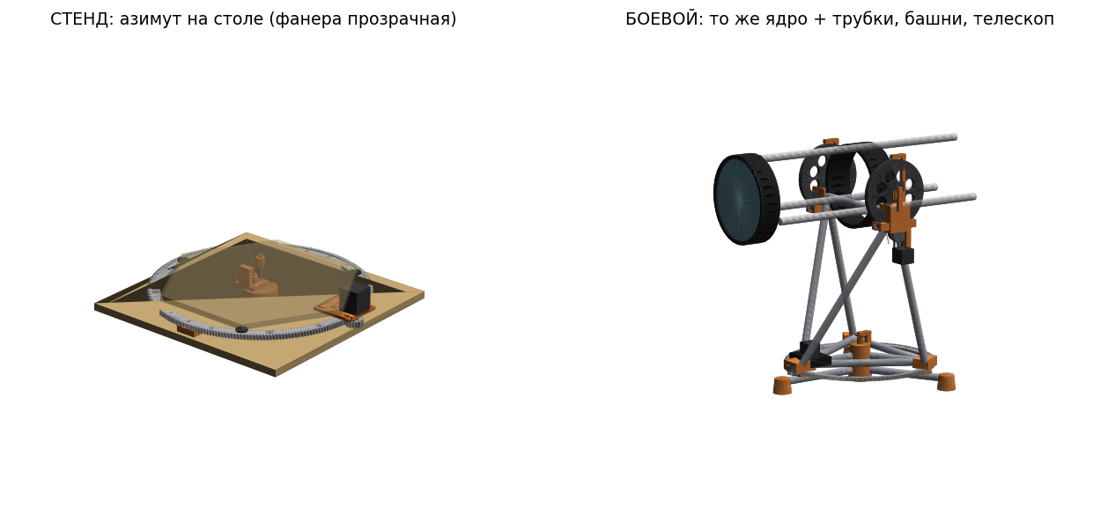
truss/bench_vs_combat.png
