fvyshkov/newton/truss/central_hub_3d.png

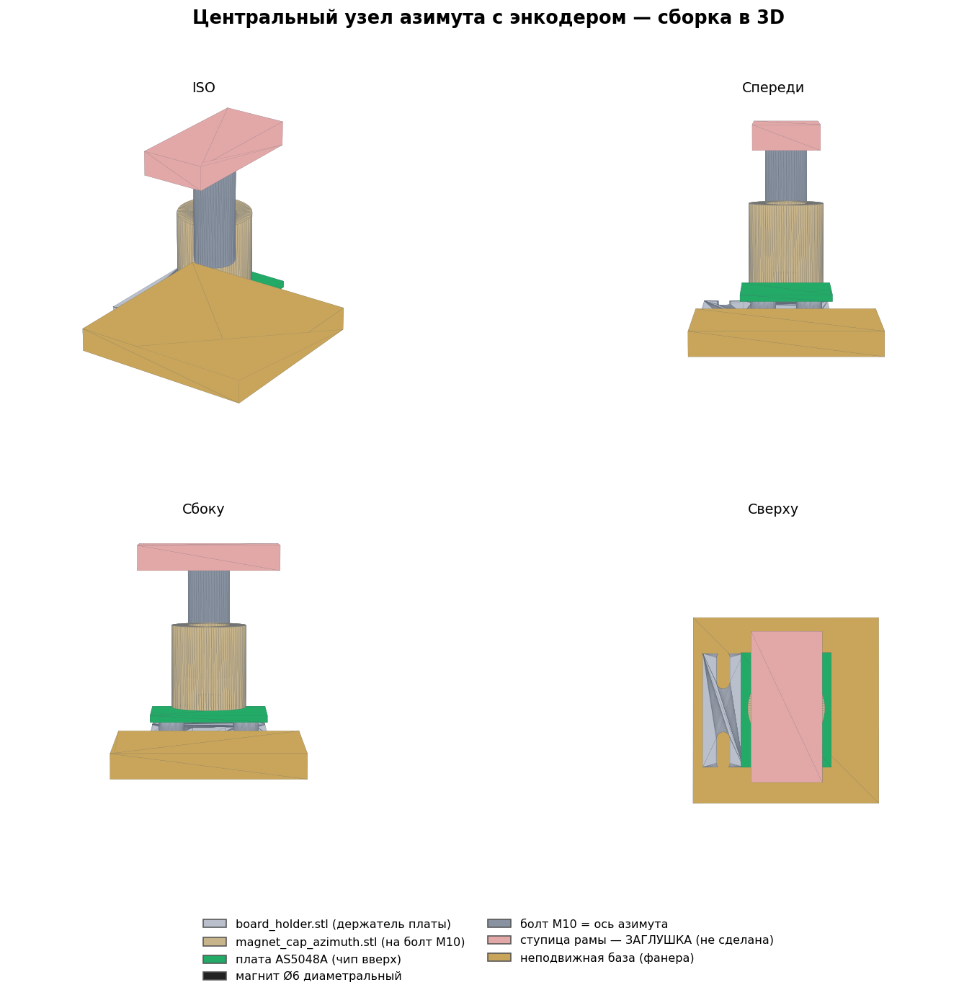
truss/central_hub_3d.png
