fvyshkov/newton/truss/central_hub_encoder.png

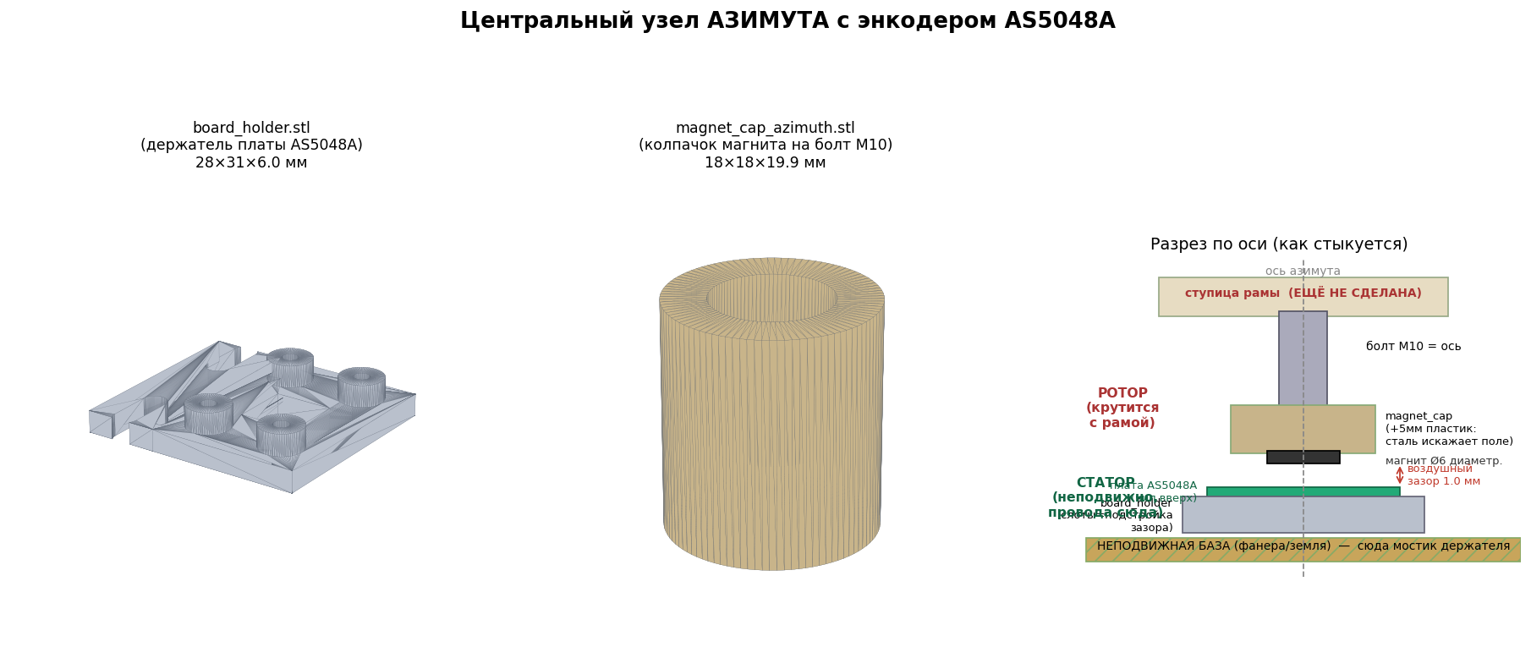
truss/central_hub_encoder.png
