fvyshkov/newton/truss/collar_headrecess_preview.png

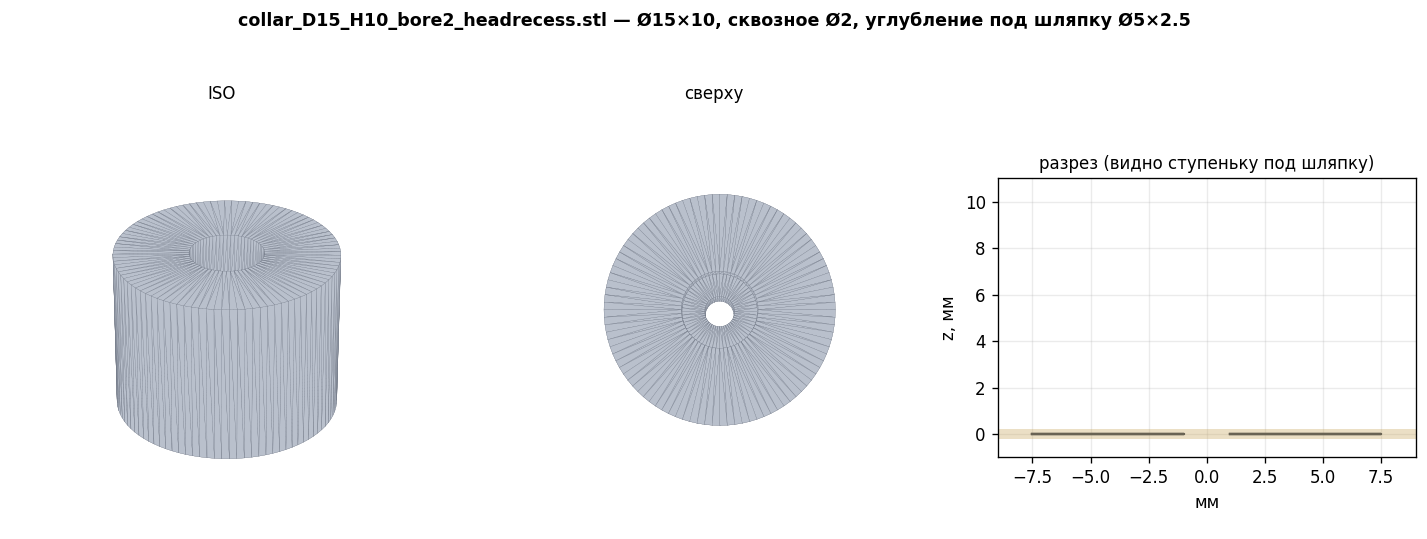
truss/collar_headrecess_preview.png
