fvyshkov/newton/truss/collar_preview.png

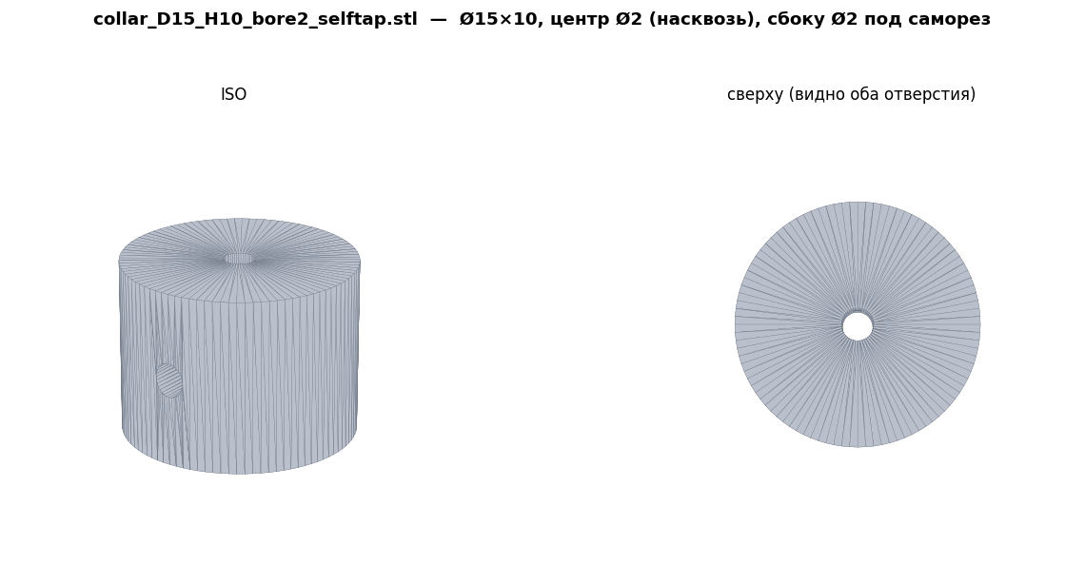
truss/collar_preview.png
