fvyshkov/newton/truss/cradle_closeup.png

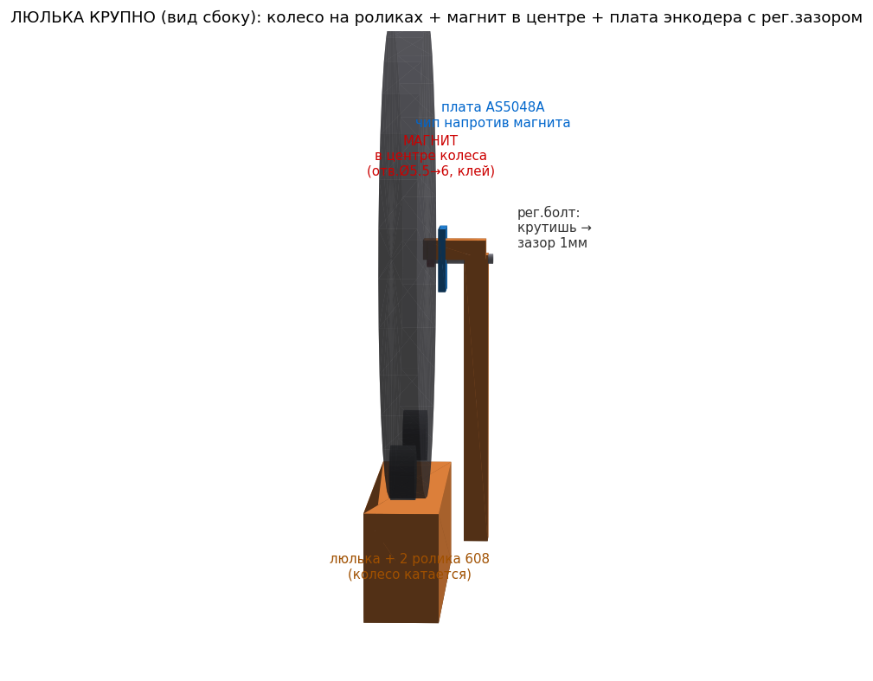
truss/cradle_closeup.png
