fvyshkov/newton/truss/ground_truss_min.png

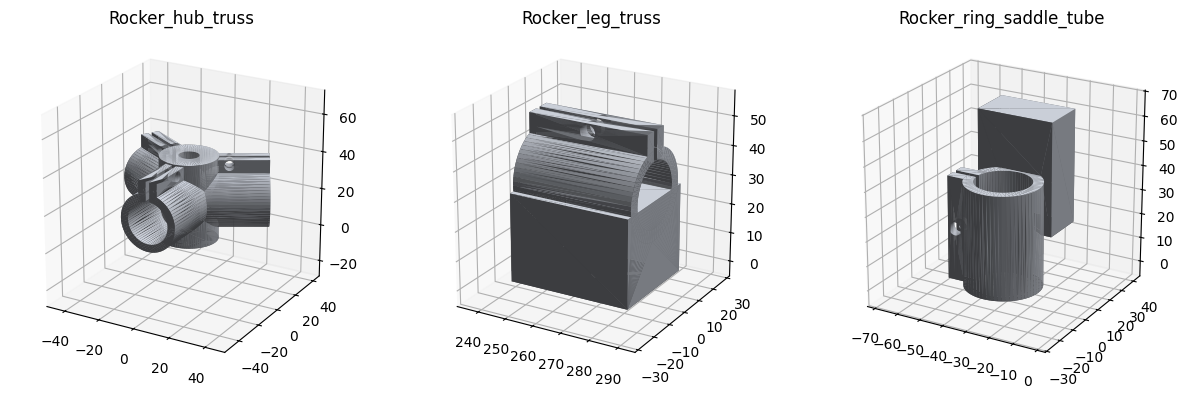
truss/ground_truss_min.png
