fvyshkov/newton/truss/images/back_truss_view.png

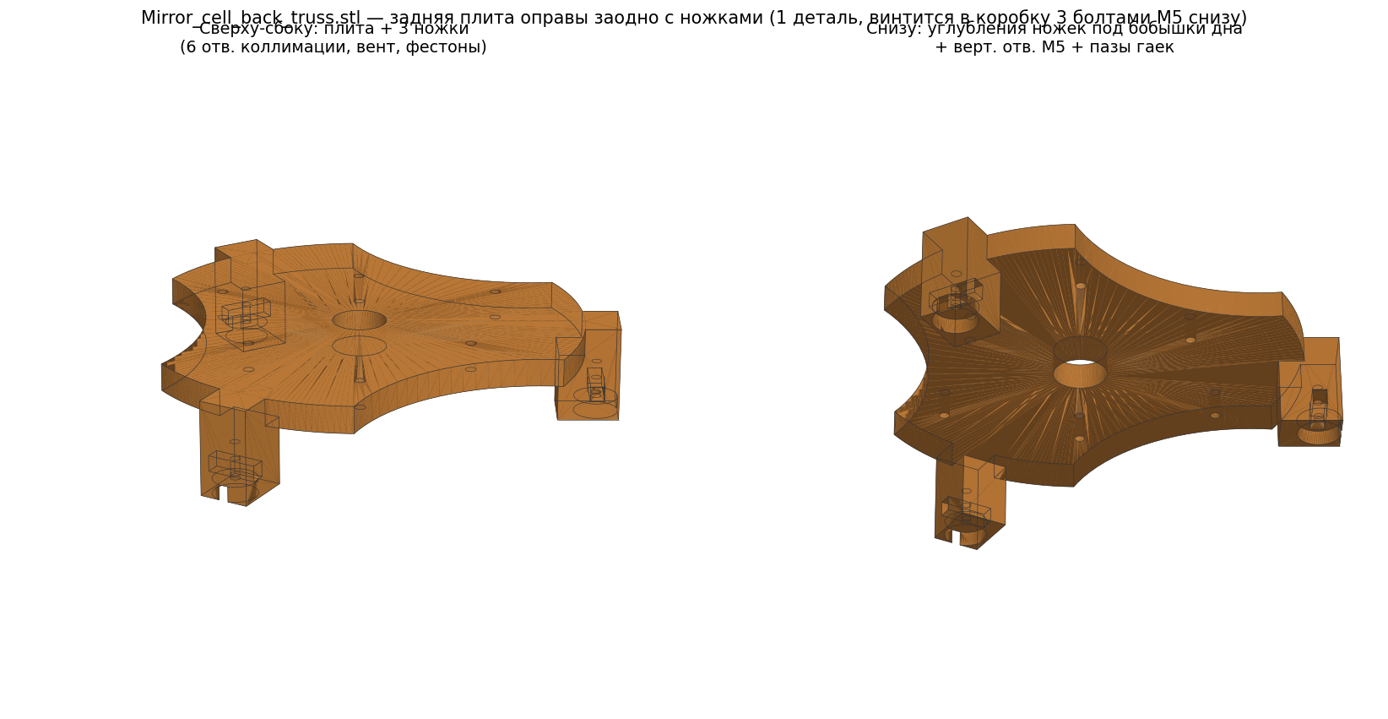
truss/images/back_truss_view.png
