fvyshkov/newton/truss/images/bracket_annotated.png

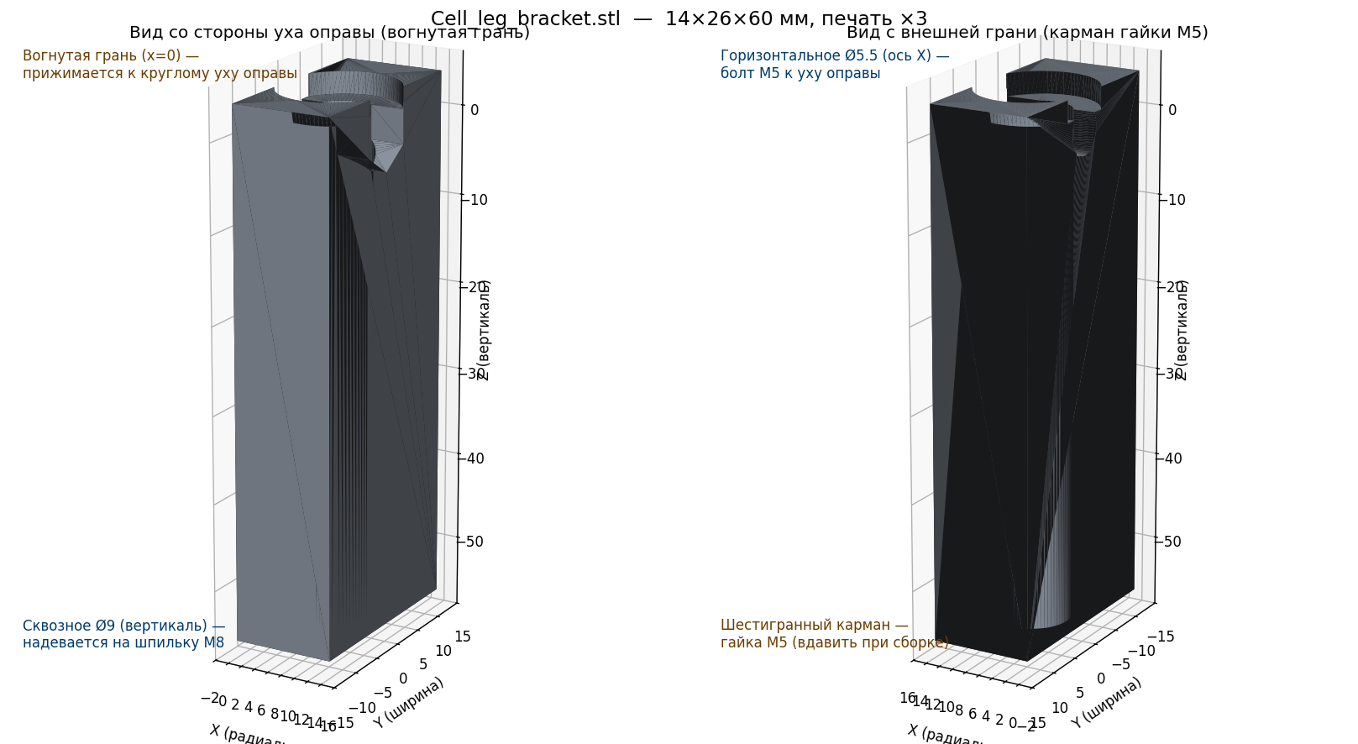
truss/images/bracket_annotated.png
