fvyshkov/newton/truss/images/bracket_exploded.png

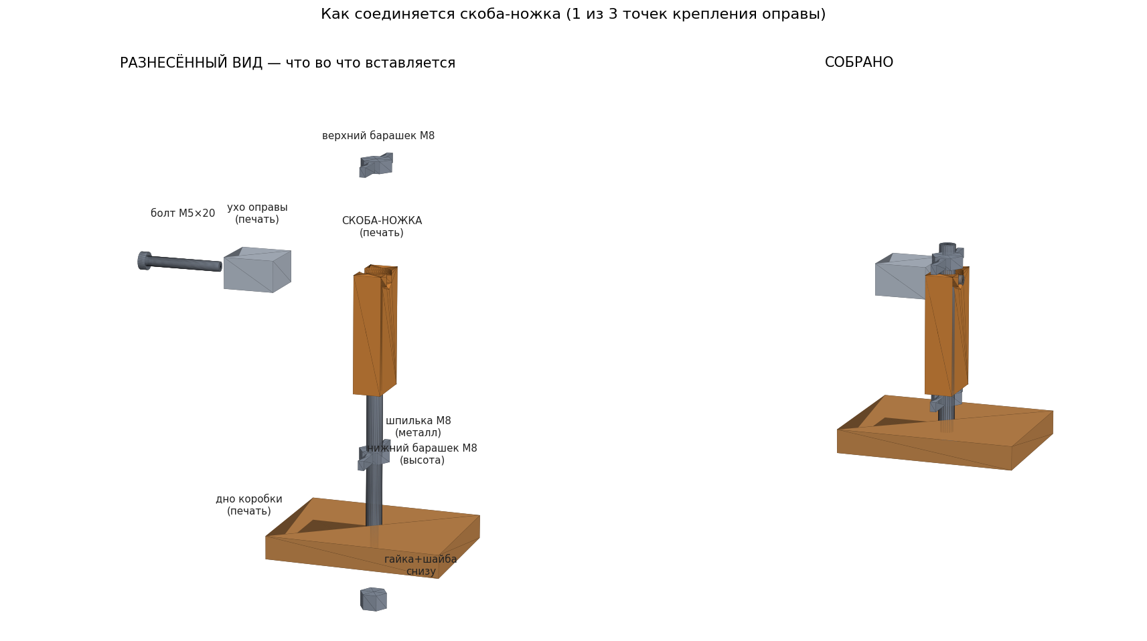
truss/images/bracket_exploded.png
