fvyshkov/newton/truss/images/bracket_nutpocket.png

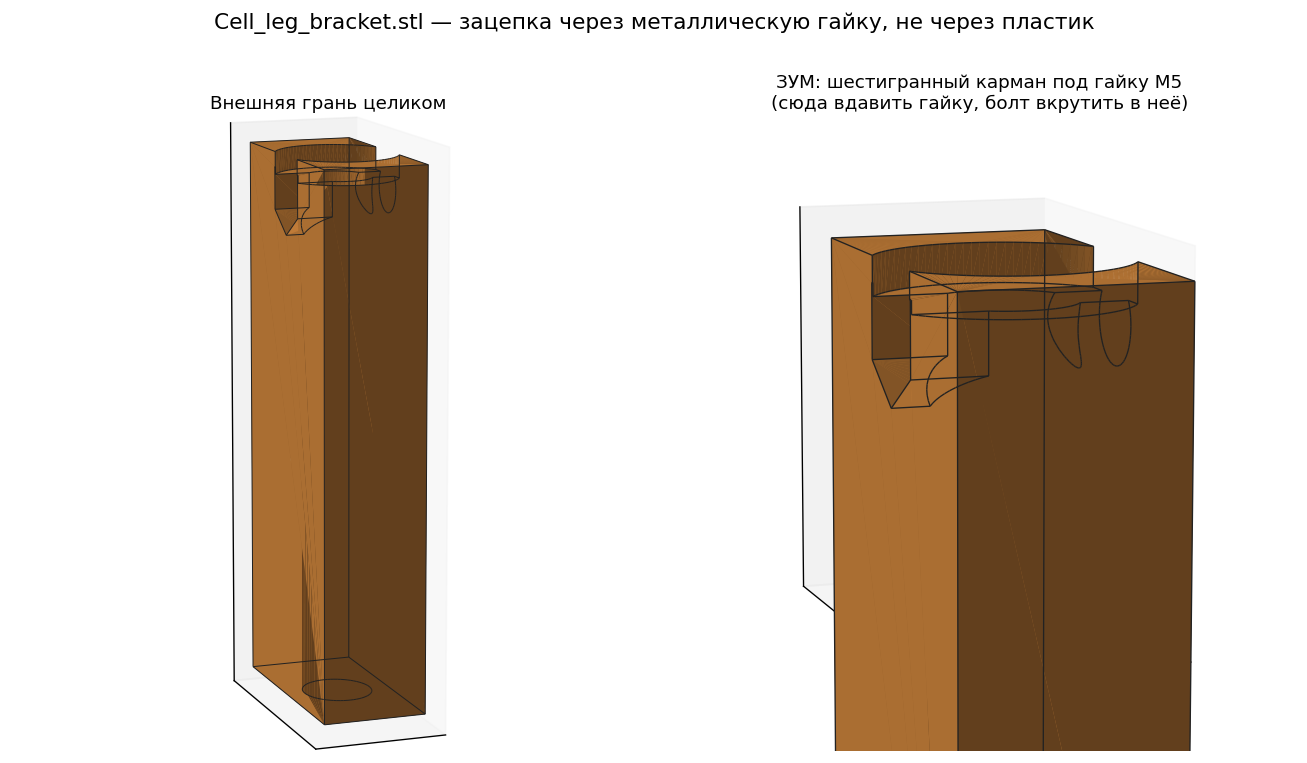
truss/images/bracket_nutpocket.png
