fvyshkov/newton/truss/images/bracket_placement.png

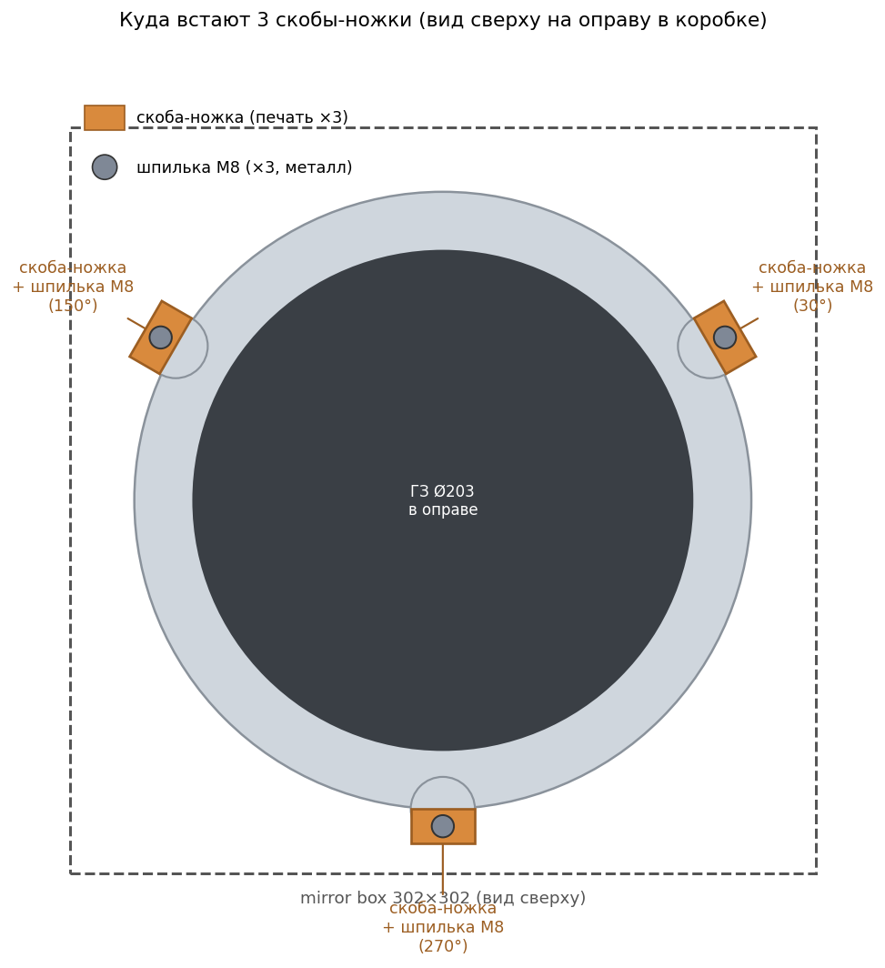
truss/images/bracket_placement.png
