fvyshkov/newton/truss/images/bracket_rigid_view.png

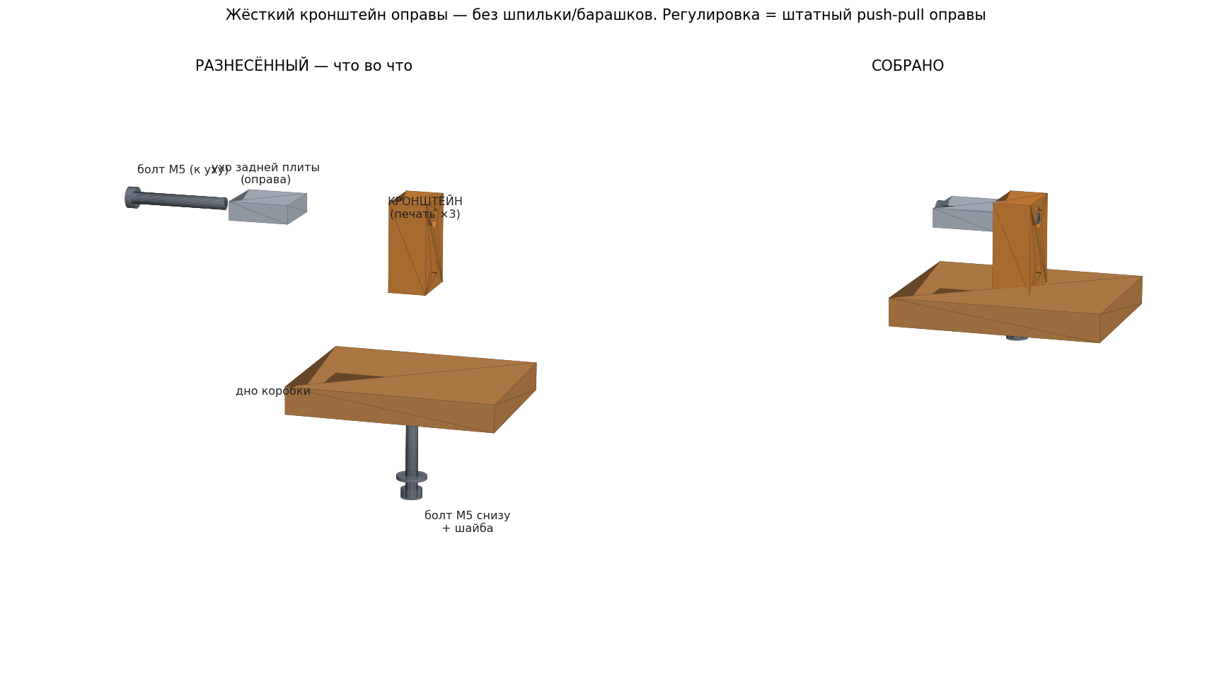
truss/images/bracket_rigid_view.png
