fvyshkov/newton/truss/images/stud_mount_diagram.png

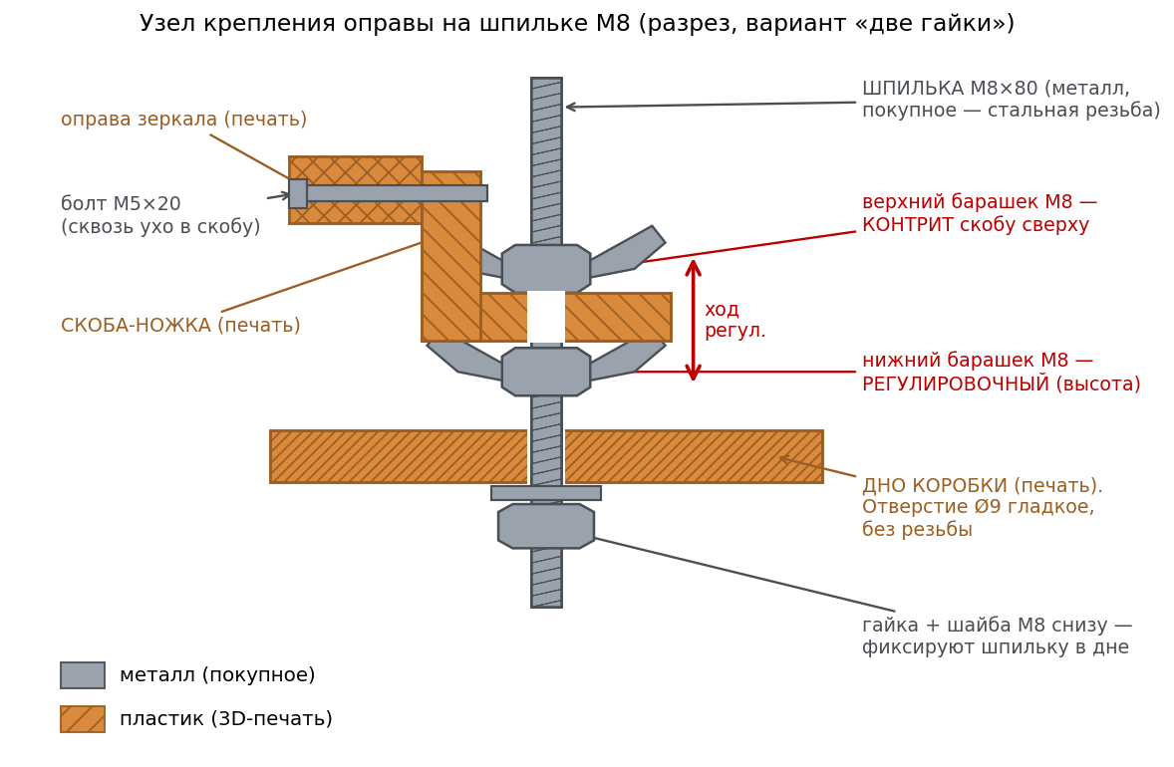
truss/images/stud_mount_diagram.png
