fvyshkov/newton/truss/incoming/son_tube_clamp.png

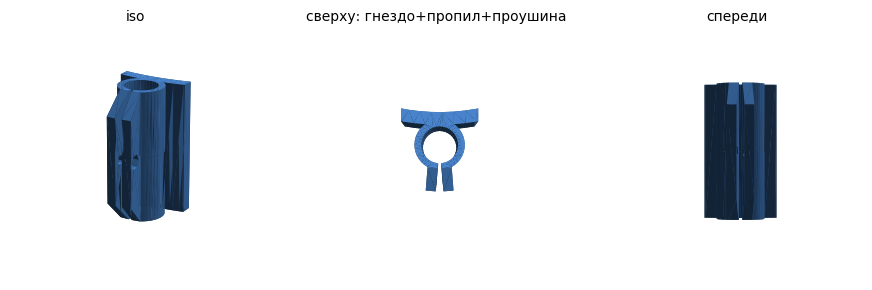
truss/incoming/son_tube_clamp.png
