fvyshkov/newton/truss/pinion_setscrew_explain.png

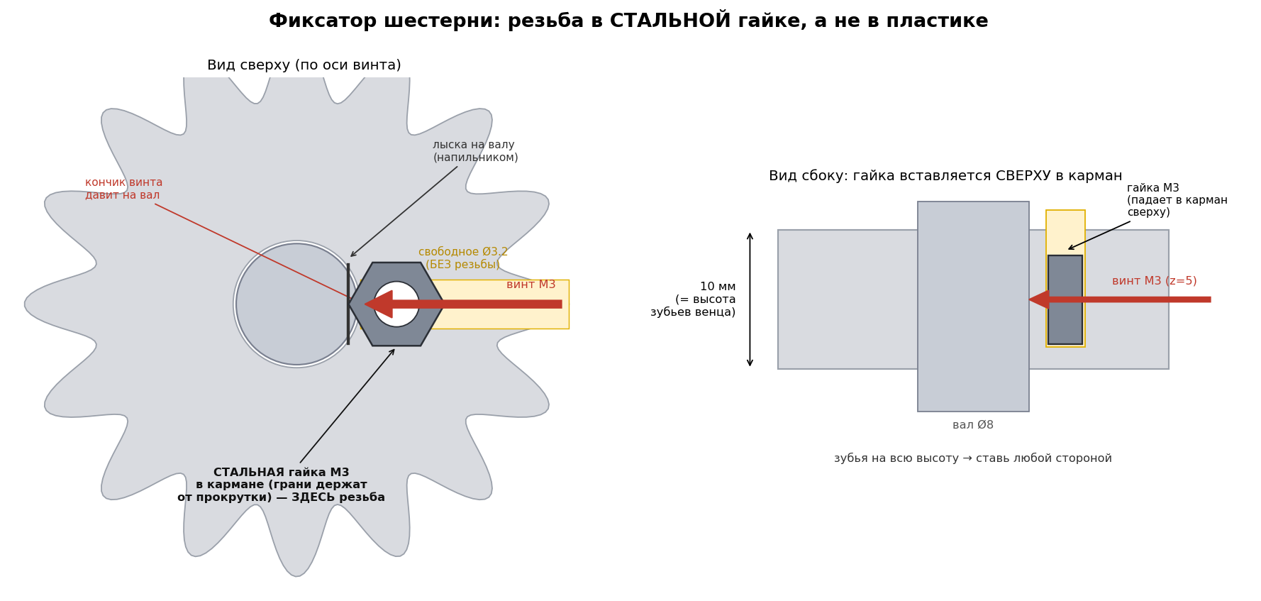
truss/pinion_setscrew_explain.png
