fvyshkov/newton/truss/rocker_drive_3d.png

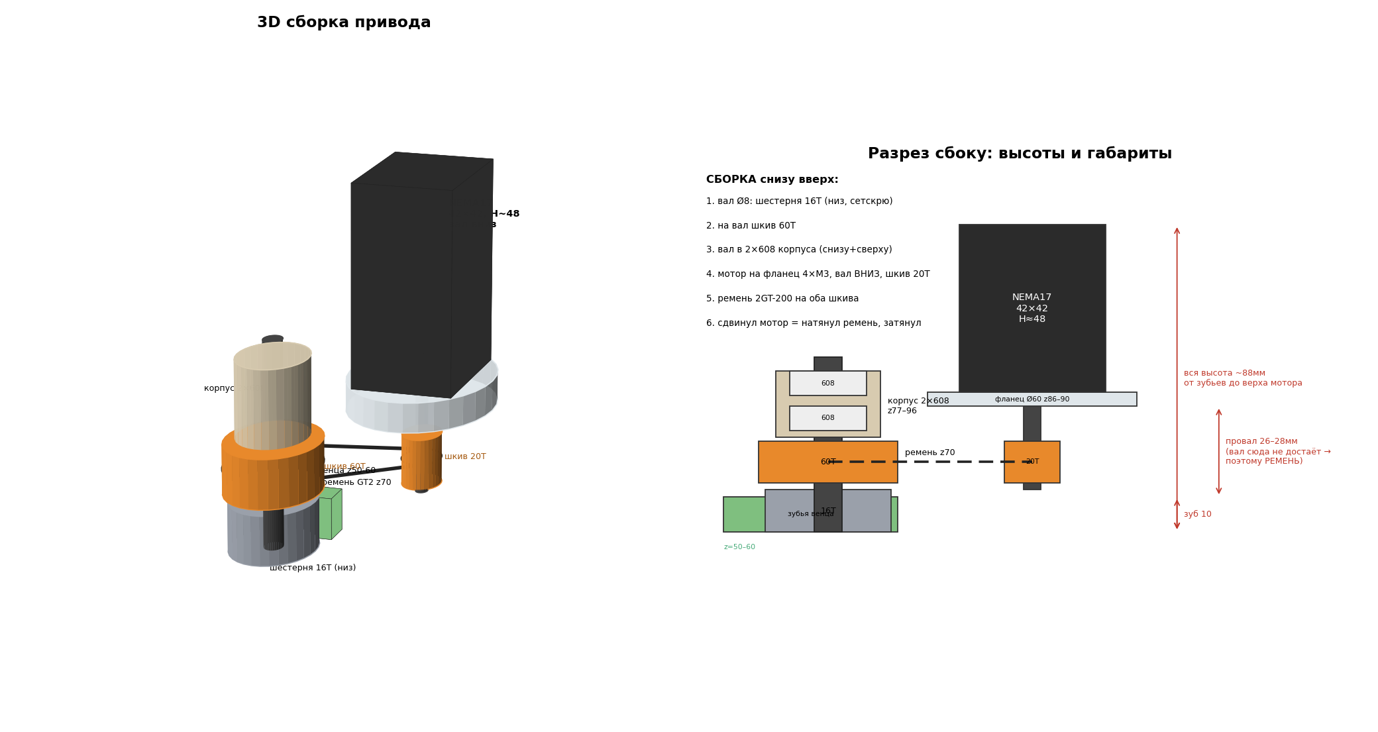
truss/rocker_drive_3d.png
