fvyshkov/newton/truss/rocker_drive_caddy.png

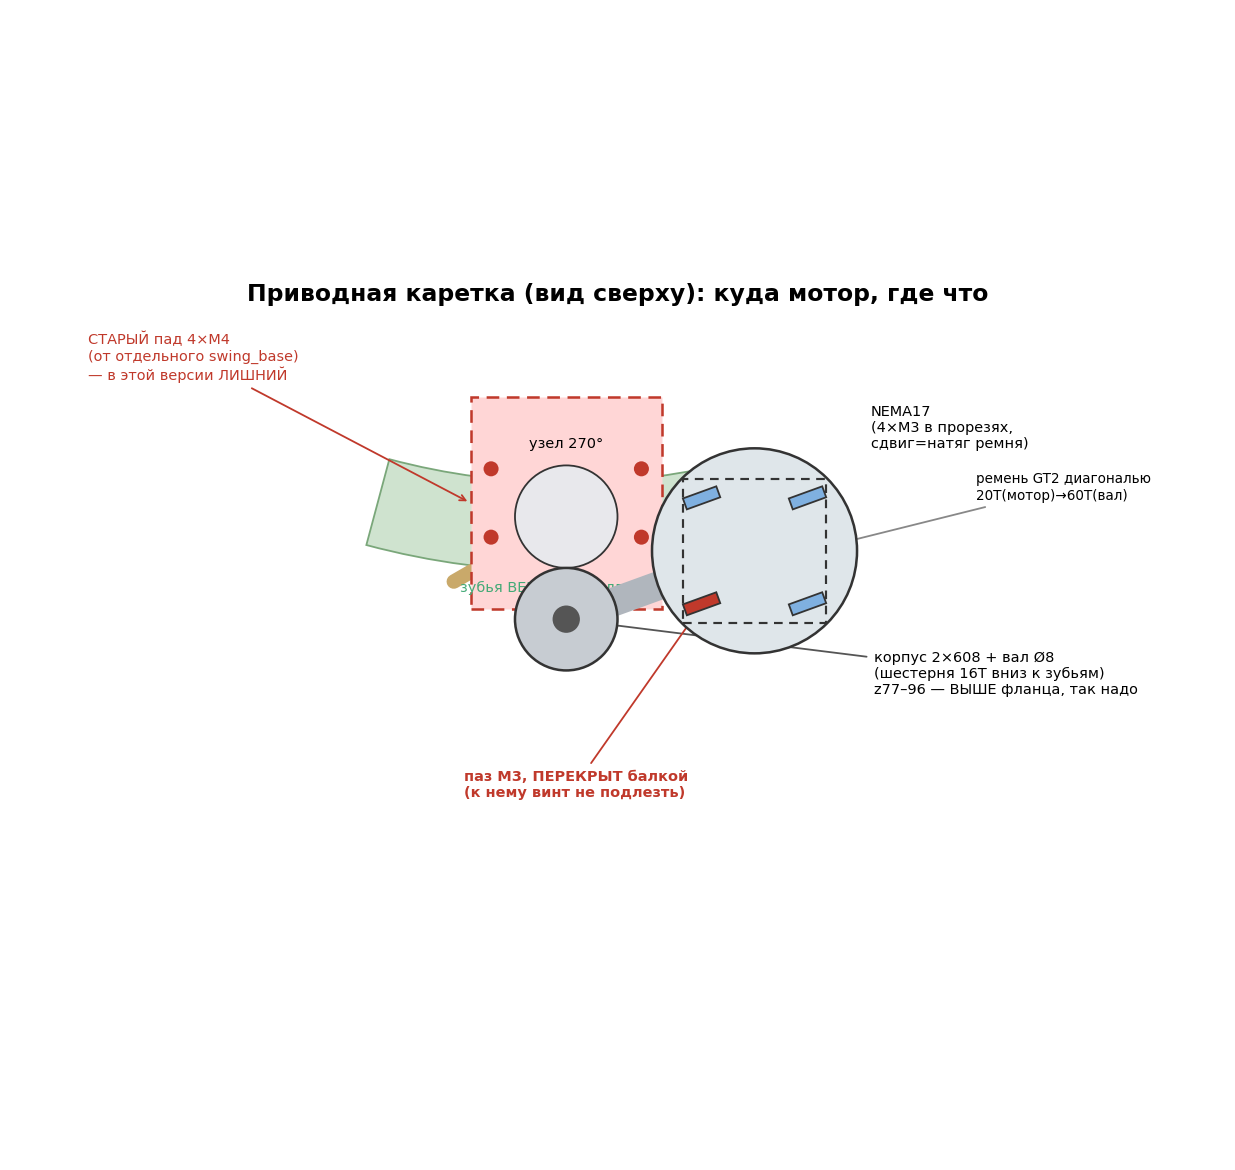
truss/rocker_drive_caddy.png
