fvyshkov/newton/truss/rocker_height_section.png

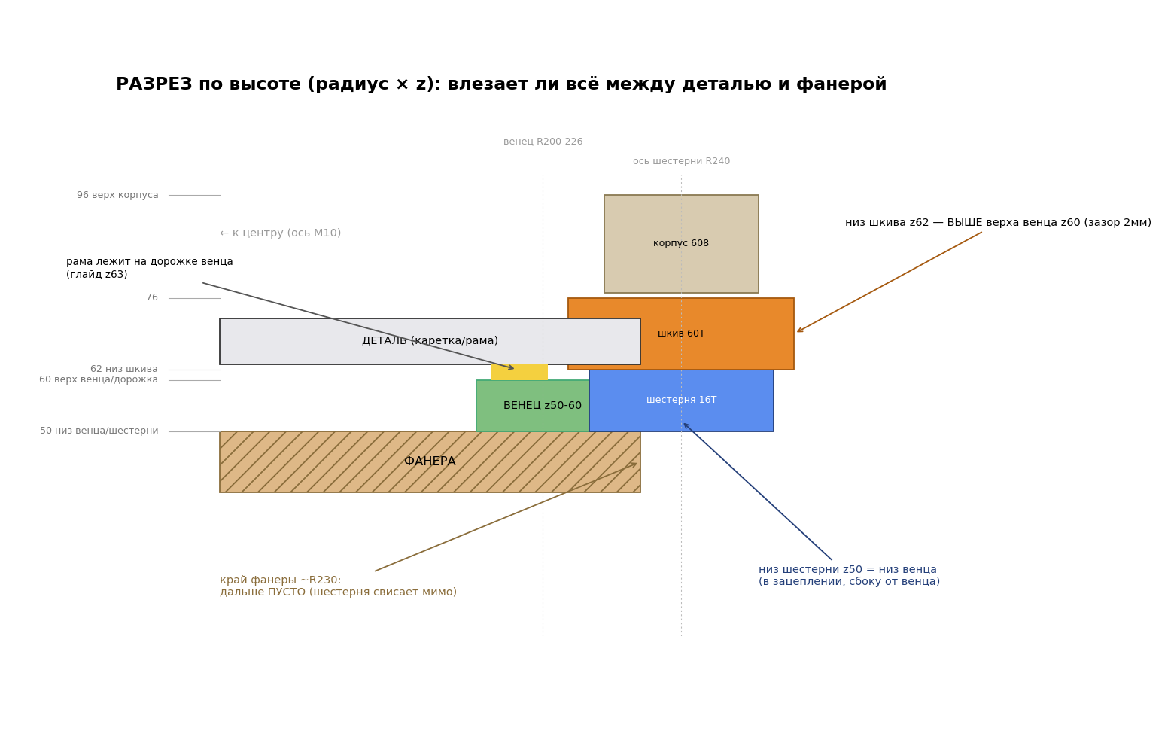
truss/rocker_height_section.png
