fvyshkov/newton/truss/rocker_motor_side.png

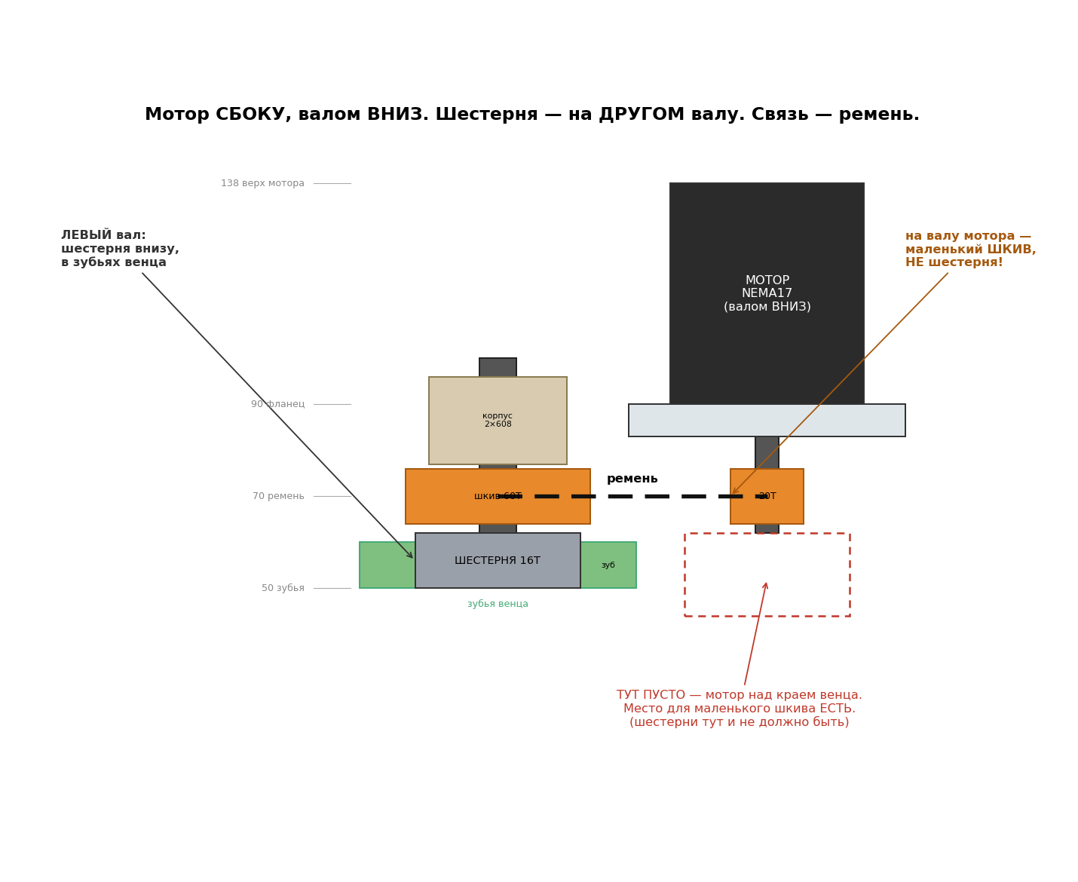
truss/rocker_motor_side.png
