fvyshkov/newton/truss/rocker_shaft_section.png

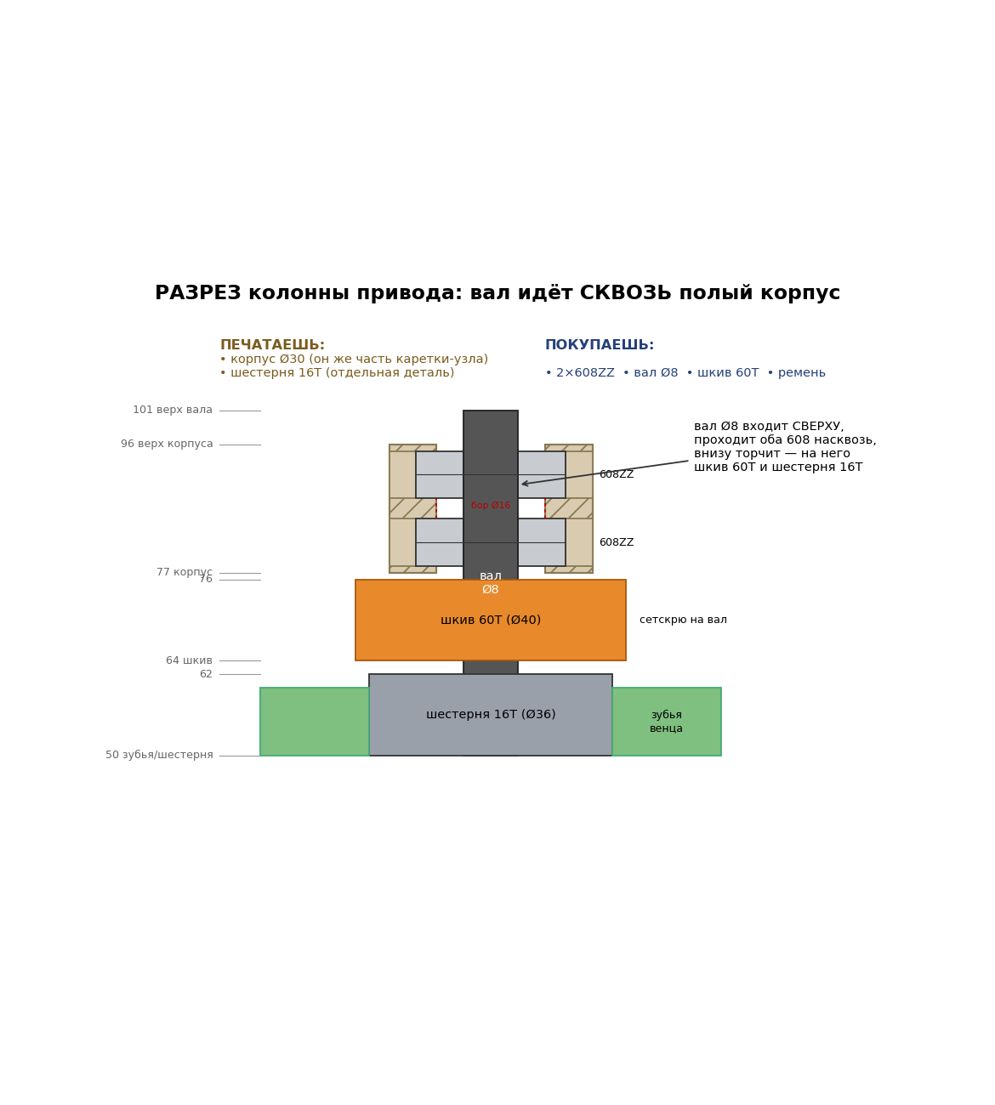
truss/rocker_shaft_section.png
