fvyshkov/newton/truss/rocker_towers_diagram.png

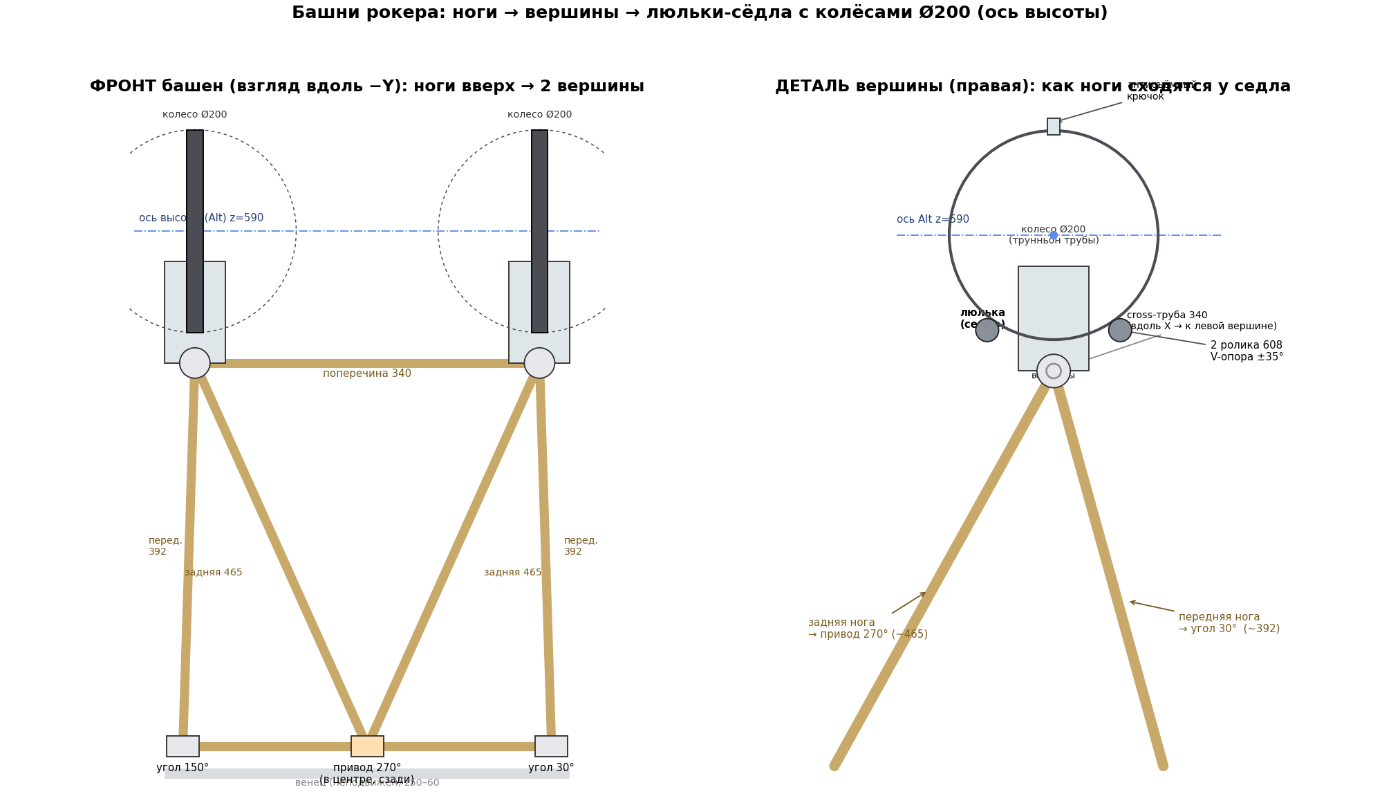
truss/rocker_towers_diagram.png
