fvyshkov/newton/truss/solution_overview.png

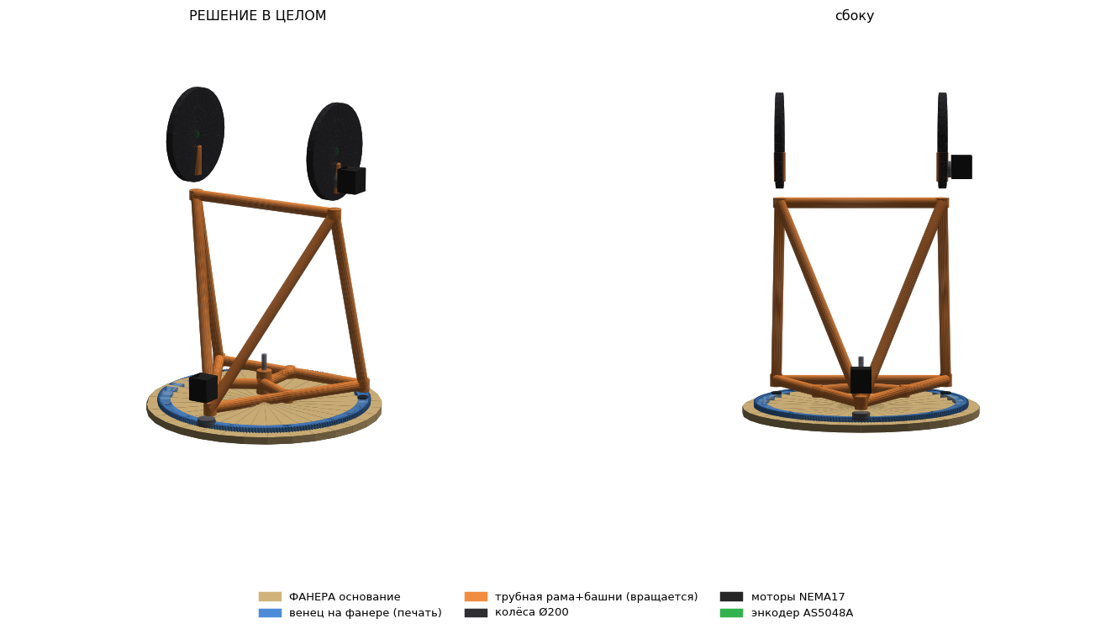
truss/solution_overview.png
