fvyshkov/newton/goto_pushto_order.md

# Апгрейд телескопа: Push-To + моторный GoTo (гибрид)

Цель: на наш 8" f/5.9 truss-Добсон добавить **автонаведение на объекты**, при этом
сохранить возможность **двигать трубу рукой** — система по энкодерам всё равно знает,
куда смотрит.

Реализуем в **два этапа**, железо берём одним заказом (AliExpress, доставка в Израиль).

---

## Этап 1 — Push-To (без моторов)

Энкодеры на осях → ESP32 читает углы → по WiFi отдаёт в **SkySafari** на телефоне.
2-звёздная привязка, дальше живой прицел на карте; трубу всегда толкаешь рукой.
Прошивка: **grtyvr/DSS_32** (читает 2× AS5048A по SPI, протокол Basic Encoder / BBox).

## Этап 2 — Моторный GoTo (OnStep), гибрид

**FYSETC E4** (ESP32 + 4× TMC2209) гоняет 2× NEMA17 через печатный фрикционный
привод (ремень 3:1 + фрикционное колесо на подшипнике Добсона).
Прошивка: **OnStepX** (pinmap `Pins.FYSETC_E4.h` уже в репо OnStepX).
Для «двигать рукой + не терять привязку» OnStep читает энкодеры на осях.

> ⚠️ **Важный софт-нюанс:** OnStepX/EncoderBridge **из коробки НЕ поддерживает AS5048A**
> (только BiSS-C абсолютные и инкрементальные AB). Чтобы те же AS5048A работали в этапе 2,
> на переиспользуемый ESP32 нужно дописать маленький скетч: читать AS5048A по SPI и отдавать
> в OnStepX по протоколу `SERIAL_BRIDGE` (протокол тривиальный). Либо позже поставить
> OnStep-родные энкодеры. На железо в заказе это не влияет.

**Переиспользование:** 1× ESP32 и 2× AS5048A покупаются один раз — в этапе 1 ESP32 это
мозг push-to, в этапе 2 он же становится EncoderBridge для тех же энкодеров.

---

## Заказ (AliExpress) — позиции и ссылки

Цены ориентировочные (₪, лето 2026). Ссылки: `aliexpress.com/item/<ID>.html`.

### Этап 1 — push-to (~₪120)
| Позиция | ID | Цена | Кол | Примечание |
|---|---|---|---|---|
| ESP32-32D/U DevKitC + плата расширения, USB-C | 1005007820190456 | ₪57.88 | 1 | вариант **«32x Type-C KIT»** (плата + расширение), НЕ «Only IPEX Antenna». Пачка 2шт |
| AS5048A магнитный энкодер, набор (SPI 14-bit, с магнитом) | 1005012204858944 | ₪19.06 | **2** | по одному на ось |
| Магниты радиальные (диаметральные) 10шт | 1005009055885002 | ₪23.86 | 1 | страховка к энкодерам |
| SkySafari 8 **Plus** | — | ~₪55 | 1 | App Store / Google Play, **не AliExpress** |

### Этап 2 — моторный GoTo (~₪450)
| Позиция | ID | Цена | Кол | Примечание |
|---|---|---|---|---|
| FYSETC E4 (ESP32 + 4× TMC2209, 12–24V) | 1005007171394322 | ₪85–93 | 1 | мозг OnStep |
| NEMA17 17HS19-2004S1 (59Ncm, 2A, 4 пров., вал 5мм) | 1005009385641951 | ₪71.24 | **2** | **простой**, не редукторный |
| Блок питания 12V **5A** (5.5×2.1, **EU plug**) | 1005010441923707 | ₪35.53 | 1 | выбрать 5A + EU! |
| GT2 шкивы 20T(5мм)+60T(8мм) + ремень 200мм | 1005005952396653 | ₪19.09 | **2** | редукция 3:1, на ось |
| Вал стальной 8мм, хром-каленый (100–150мм) | 32879622260 | ₪8.3 | **2** | под 60T+колесо+608 |
| Подшипники 608ZZ (8×22×7) 10шт | 1005006995243152 | ₪8–11 | 1 | валы привода |
| Муфта гибкая 5→8мм | 1005012046287163 | ₪33.21 | 1 | опционально (при ремне можно без) |
| O-кольца NBR, набор | 1005007297451303 | ₪14.11 | 1 | антипроскальзывание колеса |

### Расходка / крепёж (общая)
| Позиция | ID | Цена | Кол |
|---|---|---|---|
| Heat-set вставки M3 (латунь, набор) | 1005006472962973 | ₪17–43 | 1 |
| Болты/гайки/шайбы M3 (набор) | 1005010217733688 | ₪30.93 | 1 |
| Термоусадка (набор 2:1) | 1005011850078749 | ₪15–54 | 1 |

**Итого железо ≈ ₪590 (~$160)** на оба этапа + SkySafari ₪55.

---

## Критичные моменты при заказе
- **ESP32** — вариант с платой (`32x Type-C KIT`), USB-**C** + CH340/CP2102. НЕ «Only IPEX Antenna».
- **AS5048A магнит** — строго **диаметральный** (поперёк), не осевой. «Set»-версия идёт с магнитом.
- **NEMA17** — простой, чтобы проворачивался рукой (редукторный клинит, даёт люфт).
- **Блок питания** — обязательно **5A** (1A не потянет 2 мотора) и **EU plug**.
- Питание E4: PSU-бочонок 5.5×2.1 — воткнуть напрямую или в клеммник (XT60 не нужен).

## Печатные детали (TODO, моделируем под наш корпус)
- Кронштейн NEMA17 со слотом натяжения ремня.
- Фрикционное колесо на 8мм вал (обод под O-кольцо), прижим к подшипнику Добсона.
- Держатели энкодеров: магнит на ось (азимут = центр.болт, высота = цапфа), датчик на фикс.кронштейне, зазор ~1мм.

## Точность (ожидания)
Push-to на хорошо собранном Добсоне наводит на ~0.2–0.5° — объект попадает в поле
слабого окуляра, дальше доводишь рукой. 2-звёздная привязка вычитает нелинейность.
Брать **14-bit** энкодеры (AS5048A), 12-bit (AS5600) — впритык.

## Ссылки на проекты
- DSS_32 (push-to): https://github.com/grtyvr/DSS_32
- OnStepX (GoTo): https://github.com/hjd1964/OnStepX
- EncoderBridge: https://github.com/hjd1964/EncoderBridge
- FYSETC E4: https://github.com/FYSETC/FYSETC-E4
