fvyshkov/newton/order_draft_supplies.md

# Заказ Newton — расходники, труба, прокладка кофеварки

**Дата**: 2026-05-07
**Обновлено**: 2026-05-07

| # | Что | Где | Статус | Сумма |
|---|---|---|---|---:|
| 1 | Болты/гайки/шайбы (см. order_draft.md) | **Galboreg онлайн** | ✅ **ОПЛАЧЕНО** | ₪202.00 |
| 2 | Краска матовая + силикон + войлок | **Home Center онлайн** | ✅ **ОПЛАЧЕНО** | ₪90.80 |
| 3 | Прокладка Lelit Cafelat E61 8.5mm ×2 | **Sterns онлайн** | ✅ **ОПЛАЧЕНО** | ₪89.00 |
| 4 | Сонотуб Ø250×3000мм (отрежем дома до 1300) | **Asbit онлайн** | 🔵 чекаут готов, ждёт карту | ₪180.00 |
| 5 | Пружина сжатия ~20мм, OD 7-8mm ×3-6 | **ищу IL онлайн** (НЕ AliExpress) | ⏳ ищу | ~₪10-30 |

---

## ✅ 1. Galboreg — ОПЛАЧЕНО

10 позиций, ₪202 включая доставку. Подробности → `order_draft.md`.

## ✅ 2. Home Center — ОПЛАЧЕНО

3 SKU, ₪90.80 включая доставку:
- Спрей матовая чёрная Maxol 400 мл — ₪11
- Super 7 нейтральный силикон 290 мл (прозрачный) — ₪29.90
- Войлочные прокладки 26 мм чёрные ×12 — ₪10
- Доставка ₪39.90

## ✅ 3. Sterns — ОПЛАЧЕНО (бонус: прокладки кофеварки)

2× Cafelat E61 group gasket 8.5mm = ₪60 + ₪29 доставка = ₪89.

## 🔵 4. Сонотуб — Asbit, чекаут готов к оплате

**[Asbit Online](https://www.asbit.co.il)** — нашёлся (ранее думали что только звонком в Plastiner).

| Позиция | Hebrew | Параметры | Цена |
|---|---|---|---:|
| Сонотуб картонный для опалубки | צינור קרטון עגול ליציקה | Ø25 см × 3 м | ₪152.54 + НДС |

- Ø250 мм точно подходит. Длина 3 м — отрежем дома до 1.3 м.
- **Доставка**: «הובלה ישירה מהיצרן» (прямо от производителя Golmat) — **бесплатно**. Через Israel Post — ₪65.25 (но 3 м не влезет).
- Срок: 5-10 раб. дней (по заказу, не складское).
- **Итого: ₪180.00**

Чекаут готов на https://www.asbit.co.il/checkout — адрес/email/телефон/ת"ז заполнены, прямая доставка выбрана, terms ✓. Осталось:
1. Кликнуть «המשך לתשלום»
2. Ввести карту

Скриншот: `/Users/mac/med/scripts/_browser_kit/sites/_dumps/asbit/checkout_ready.png`

## ⏳ 5. Пружины — ищу IL онлайн

AliExpress отвергнут пользователем. Ищу израильские онлайн-магазины с компрессионными пружинами:
- OD 7-8 мм
- Wire 0.8-1.0 мм
- Length ~20 мм
- Spring steel
- 3-6 шт

Кандидаты: spring.co.il, hamerkaz.co.il, ksp.co.il, KSP, Bug, профильные мастерские. Параллельный агент ищет.

---

## Итог

| Площадка | Сумма | Статус |
|---|---:|---|
| Galboreg | ₪202.00 | ✅ оплачено |
| Home Center | ₪90.80 | ✅ оплачено |
| Sterns | ₪89.00 | ✅ оплачено |
| **Asbit (сонотуб)** | **₪180.00** | 🔵 ждёт клик «המשך לתשלום» + карта |
| Пружины | ~₪10-30 | ⏳ ищем IL-магазин |

**Уже потрачено: ₪381.80**
**В очереди на оплату: ₪180 (сонотуб) + ~₪10-30 (пружины)**
**Прогноз итого: ~₪570-590**
