fvyshkov/newton/shopping_list.md

# Что осталось купить

Один поход в ACE / Home Center, ~₪25-40.

| Позиция | Кол-во | Hebrew |
|---|---:|---|
| Уголок металлический 30×30мм с отверстиями Ø5 (опционально, для усиления крепления Y-плиты к трубе) | 0-3 | זווית מתכת 30×30 |
| Шайба плоская M5 | 12 | דיסקית שטוחה M5 |
| Ножка резиновая Ø30-40мм самоклеящаяся | 3 | רגליות גומי דביקות |

---

## Уже куплено

См. `order_draft.md` и `order_draft_supplies.md`:

- ✅ Сонотуб Golmat ST410250 (Asbit)
- ✅ Болты M5/M10, гайки, барашки, шурупы 4×40 (Galboreg)
- ✅ Краска матовая чёрная, силикон Super 7, войлок (Home Center)
- ✅ PTFE прокладки
- ✅ Оптика: главное 203мм f/1200, вторичное 50мм, окуляры 25/10мм, лазерный коллиматор, cheshire, искатель SVBONY

## Решено брать своё / уже есть

- Фанера 18мм и брусок 30×30 — пользователь добывает сам
- Клей по дереву — НЕ нужен, конструкция на шурупах (4×40 уже куплены)
- Изопропил для протирки зеркал — добывается сам
- Пружины M5 — не критичны, push-pull можно собрать без них (затягивая барашки)
