fvyshkov/newton/truss/shopping_list_delta.md

# Truss-вариант — что докупить (дельта от трубного варианта)

Учтено что уже куплено (см. `/Users/mac/newton/order_draft.md` и `order_draft_supplies.md`).

## Не пригодится из купленного (если окончательно отказываешься от сонотуба)

- 🔴 **Сонотуб Golmat Ø250×3000мм** (₪180) — не нужен в truss. Если ещё не доставлен, можно попробовать отменить заказ в Asbit. Если уже дома — можно отрезать кусок ~150мм и использовать как **бленду** на UTA (защита от боковой засветки).
- 🟡 **M10×60 болты + M10 fender шайбы** (5+5) — для altitude (боковые цапфы Добсона) использовать можно, но крепление цапф в truss-варианте чуть другое. Скорее всего пригодятся.

## Уже куплено — пригодится в truss как есть

| Позиция | Кол-во | Где используется |
|---|---:|---|
| ✅ Оптика (зеркала, окуляры, коллиматор, искатель) | — | без изменений |
| ✅ M5×12 болт hex | 20 | крепёж углов mirror box, фокусер, мелочи |
| ✅ M5×20 pull-болт | 5 | push-pull коллимация (как сейчас) |
| ✅ M5×50 push-болт | 5 | push-pull коллимация (как сейчас) |
| ✅ M5 hex гайка | 20 | везде |
| ✅ M5 барашковая гайка | 5 | коллимация |
| ✅ M5 nylock | 5 | где нужна вибростойкость |
| ✅ Шурупы 4×40 | 30 | mirror box если делать фанерным |
| ✅ Краска матовая чёрная | — | внутренности UTA, mirror box |
| ✅ Силикон | — | посадка зеркала на оправу |
| ✅ Войлок 26мм ×12 | — | подшипники Добсона |
| ✅ PTFE прокладки | — | подшипники Добсона |

## ➕ Докупить для truss

### Главное — стойки (4 шт, одинаковые)

См. отдельный документ `tubes_spec.md` — что искать в магазине.

**Цена: ₪40-100 за комплект из 4 шт.**

### Зажим стоек в сокетах

Каждый из 8 сокетов стягивается одним болтом через проушины хомута. Болт M5×12 (есть в наличии) слишком короткий — не прошивает Ø34 хомут. Нужен M5×30.

| Позиция | Hebrew | Кол-во | Где |
|---|---|---:|---|
| M5×30 болт | בורג M5 30mm | 8 | Galboreg / ACE |
| M5 барашковая гайка | אום כנף M5 | 8 (есть 5, +3) | Galboreg / ACE |

**Цена: ~₪15-25.**

### Крепление оправы к коробке (жёсткое)

Оправа крепится к дну коробки 3 жёсткими кронштейнами (`Cell_leg_bracket.stl`), без регулировки высоты. Вся настройка (наклон + осевой сдвиг) — штатными push-pull барашками самой оправы; точный фокус — фокусёром. Шпильки M8 НЕ нужны (раньше дублировали push-pull).

Каждый кронштейн: 1 горизонтальный болт M5×20 к уху (есть в наличии) + 1 вертикальный болт M5×20 снизу к дну.

| Позиция | Hebrew | Кол-во | Где |
|---|---|---:|---|
| M5×20 болт (вертикальный, к дну) | בורג M5 20mm | 3 | Galboreg / ACE |
| M5 hex гайка (в карман кронштейна) | אום M5 | 6 | Galboreg / ACE |
| M5 плоская шайба (под дном) | דיסקית שטוחה M5 | 3 | Galboreg / ACE |

**Цена: ~₪10-15.** (Горизонтальные болты M5×20 ×3 — берём из имеющихся.)

### Дельта общая

| Что | Где | Цена |
|---|---|---:|
| 4 стойки Ø22-28мм | хозмаг / Ace | ₪40-100 |
| Зажим стоек (M5×30 ×8, барашки M5 +3) | Galboreg / ACE | ₪15-25 |
| Крепление оправы (M5×20 ×3, гайки M5 ×6, шайбы M5 ×3) | Galboreg / ACE | ₪10-15 |
| Резиновые ножки Ø30-40мм самоклейка ×3 (была в старом списке) | ACE | ₪10-15 |
| **Итого** | | **~₪75-155** |

## Чем не пользуемся

- ~~Шпильки M8 + барашки M8~~ — отказались: жёсткое крепление оправы, регулировка через штатный push-pull. Экономия ₪25-40.
- Шурупы 4×40 — нужны только если mirror box фанерный. Если печатаем целиком — лежат в запас.
- Болты M5×50 push — штатная коллимация оправы, как в трубном варианте.
