fvyshkov/newton/stl/Focuser saddle.stl

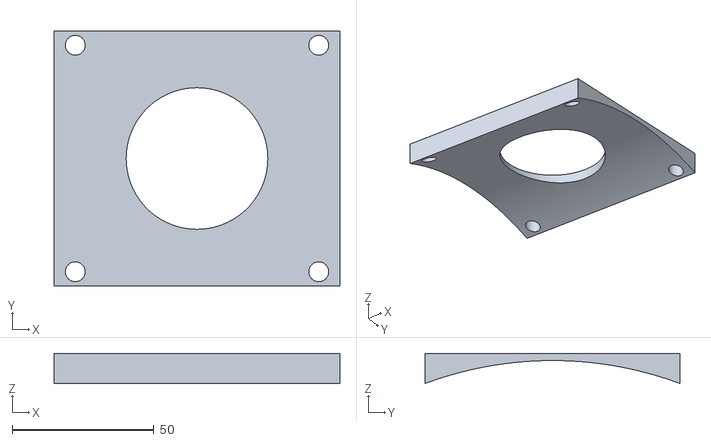
[picture p54: CAD file, 2026-05-15]
stl/Focuser saddle.stl
101.0 x 90.0 x 10.6
