fvyshkov/newton/stl/mirror_cell/Mirror_cell_front.stl

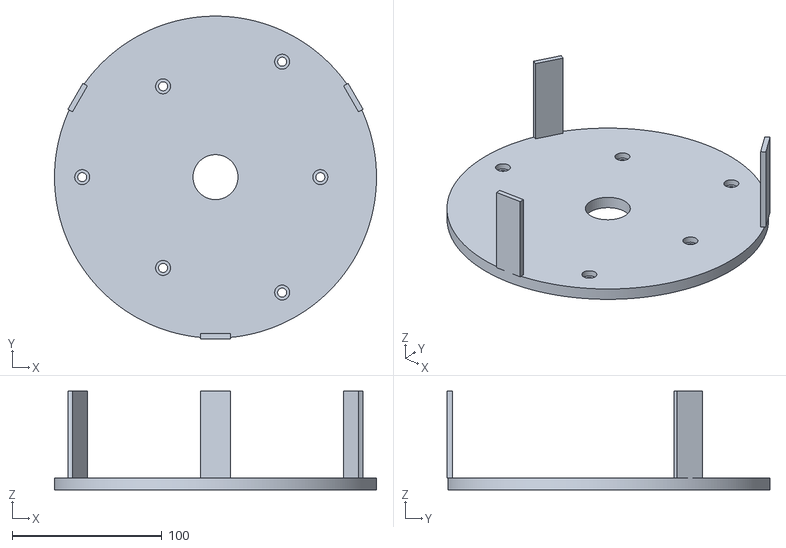
[picture p55: CAD file, 2026-05-17]
stl/mirror_cell/Mirror_cell_front.stl
215.0 x 215.5 x 66.0
