fvyshkov/newton/truss/azimuth2/stl/az2_magnet_spider3.stl

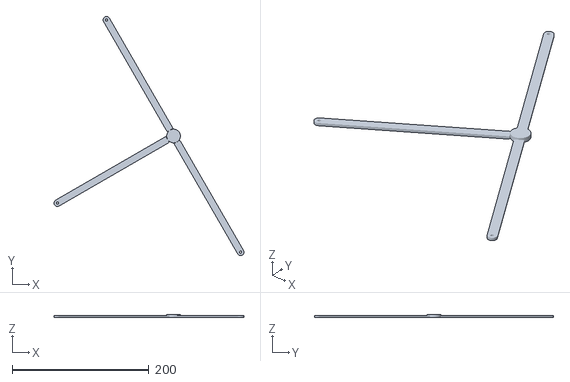
[picture p56: CAD file, 2026-07-13]
truss/azimuth2/stl/az2_magnet_spider3.stl
277.7 x 349.5 x 5.00
