fvyshkov/newton/truss/incoming/son_tube_clamp.stl

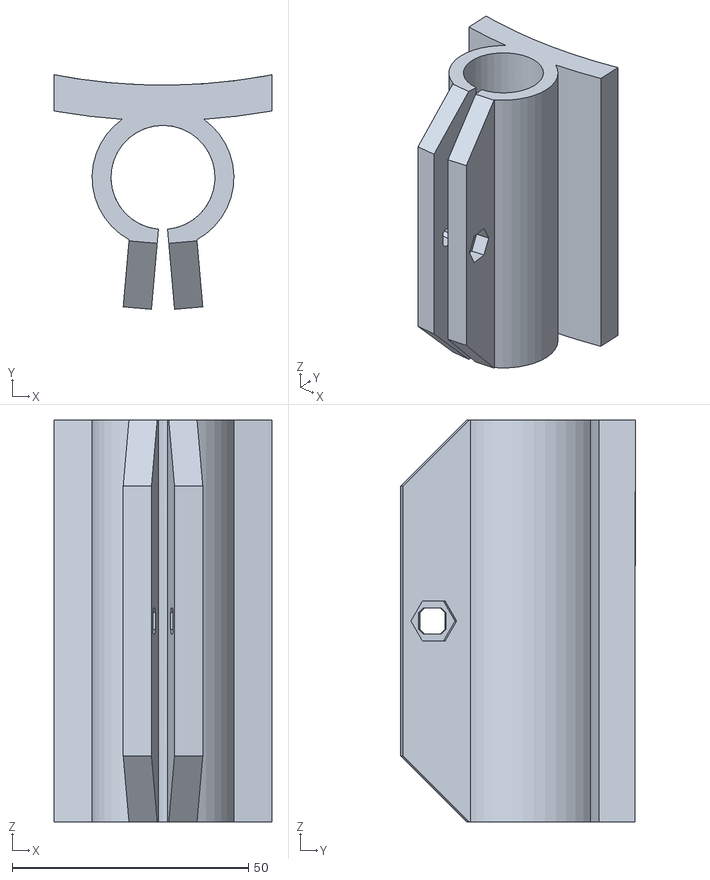
[picture p57: CAD file, 2026-07-04]
truss/incoming/son_tube_clamp.stl
46.0 x 49.6 x 85.0
