fvyshkov/newton/truss/print_queue/08_Rocker_ring_saddle_x3.3mf

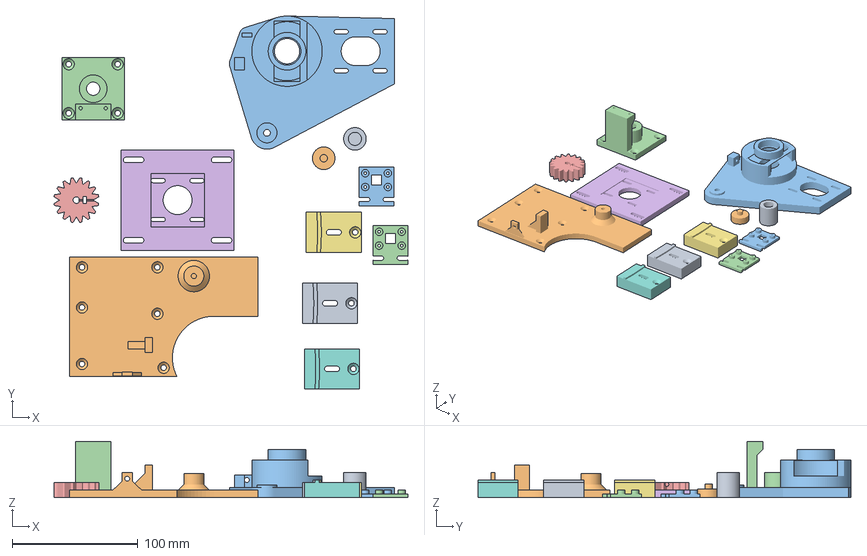
[picture p58: CAD file, 2026-07-05]
truss/print_queue/08_Rocker_ring_saddle_x3.3mf
281.8 x 296.9 x 44.7 mm
08_Rocker_ring_saddle_x3.stl x 3
13_Rocker_swing_base_x1.stl
12_Rocker_swing_arm_x1.stl
11_Rocker_pivot_flange_x1.stl
10_Rocker_pinion_16T_direct_x1.stl
09_Rocker_az_motor_plate_x1.stl
04_magnet_cap_azimuth_x1.stl
05_magnet_cap_altitude_x1.stl
06_board_holder_x2.stl x 2
