fvyshkov/newton/truss/print_queue/azimuth2/stl_отдельно/az2_shoe_A30.stl

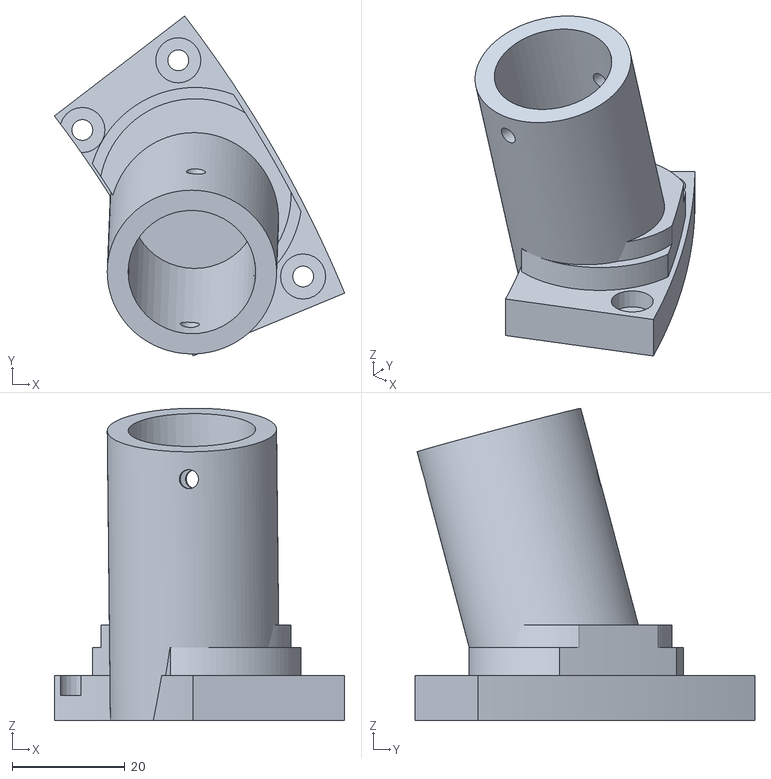
[picture p60: CAD file, 2026-07-13]
truss/print_queue/azimuth2/stl_отдельно/az2_shoe_A30.stl
51.4 x 60.2 x 55.3
