fvyshkov/newton/truss/print_queue/azimuth2/venec_4seg/az2_ring_rot_B_plain.stl

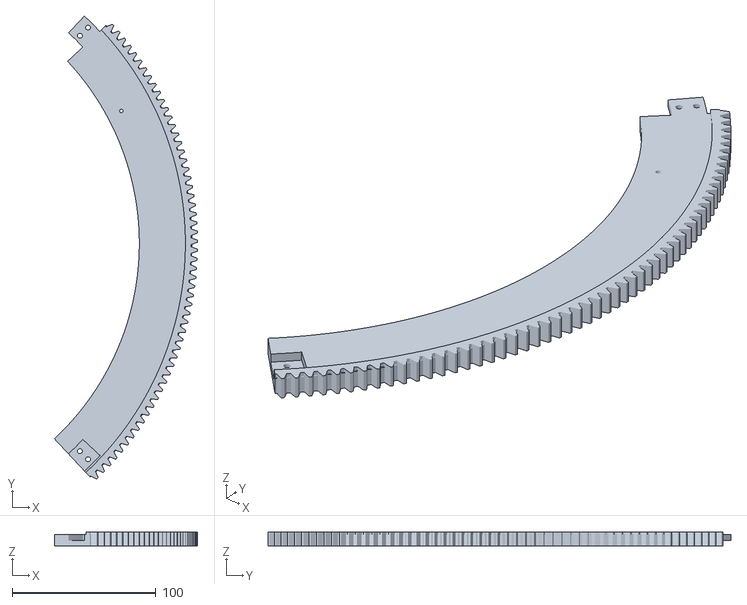
[picture p61: CAD file, 2026-07-13]
truss/print_queue/azimuth2/venec_4seg/az2_ring_rot_B_plain.stl
99.5 x 321.6 x 10.0
