fvyshkov/newton/truss/print_queue/motor_kron/Rocker_pinion_16T.stl

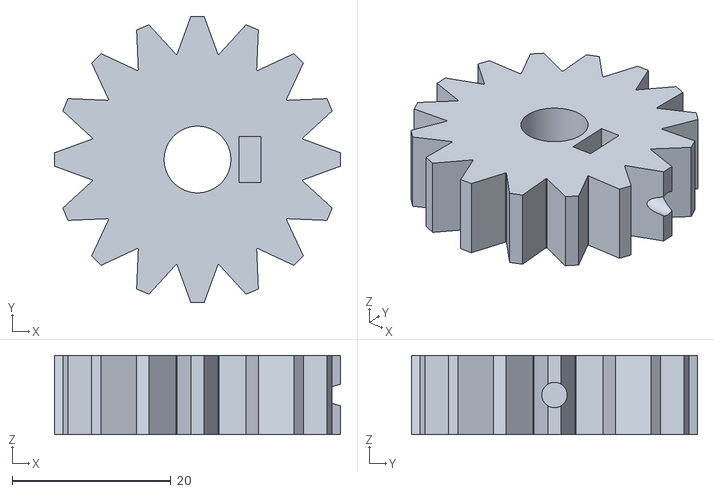
[picture p62: CAD file, 2026-07-12]
truss/print_queue/motor_kron/Rocker_pinion_16T.stl
36.0 x 36.0 x 10.0
