fvyshkov/newton/truss/print_queue/nizhnyaya_rama/20_Rocker_midchord_node_x3.3mf

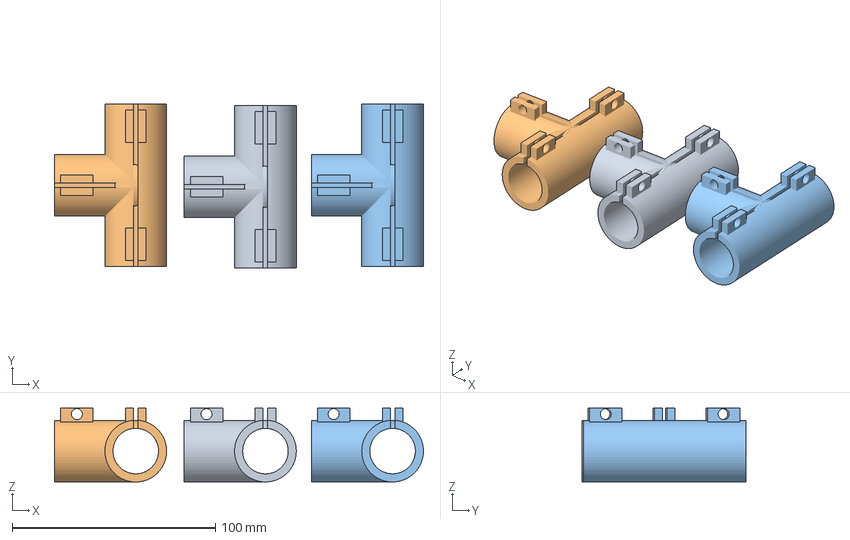
[picture p63: CAD file, 2026-07-08]
truss/print_queue/nizhnyaya_rama/20_Rocker_midchord_node_x3.3mf
181.6 x 80.7 x 36.4 mm
20_Rocker_midchord_node_x3.stl x 3
