fvyshkov/newton/truss/print_queue/sliced/rama_A.gcode.3mf

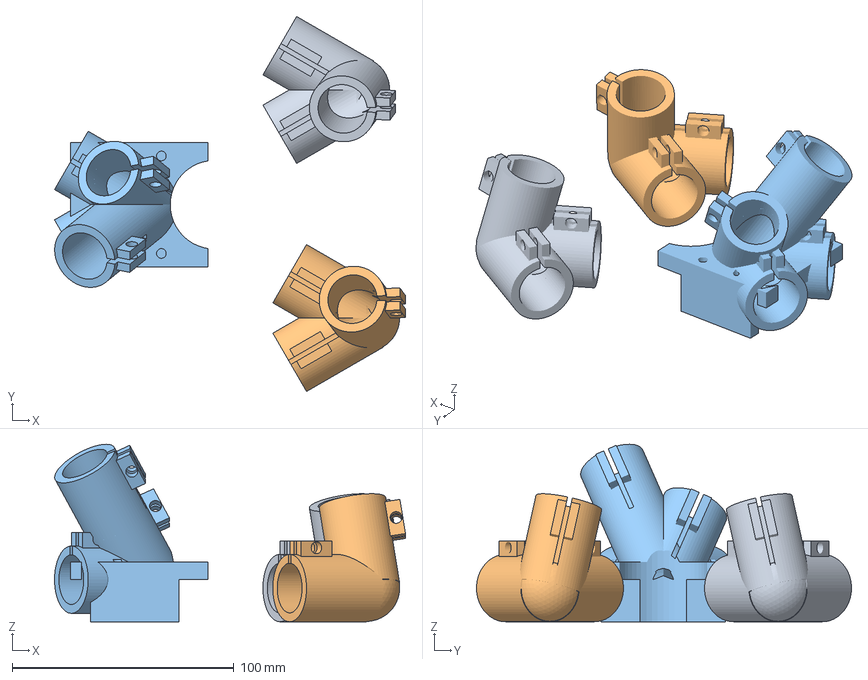
[picture p64: CAD file, 2026-07-05]
truss/print_queue/sliced/rama_A.gcode.3mf
158.4 x 169.3 x 80.1 mm
17_Rocker_corner_node_30_x1.stl
18_Rocker_corner_node_150_x1.stl
19_Rocker_corner_drive_x1.stl
