fvyshkov/newton/truss/print_queue/tube_frame/17_Rocker_corner_node_30_x1.stl

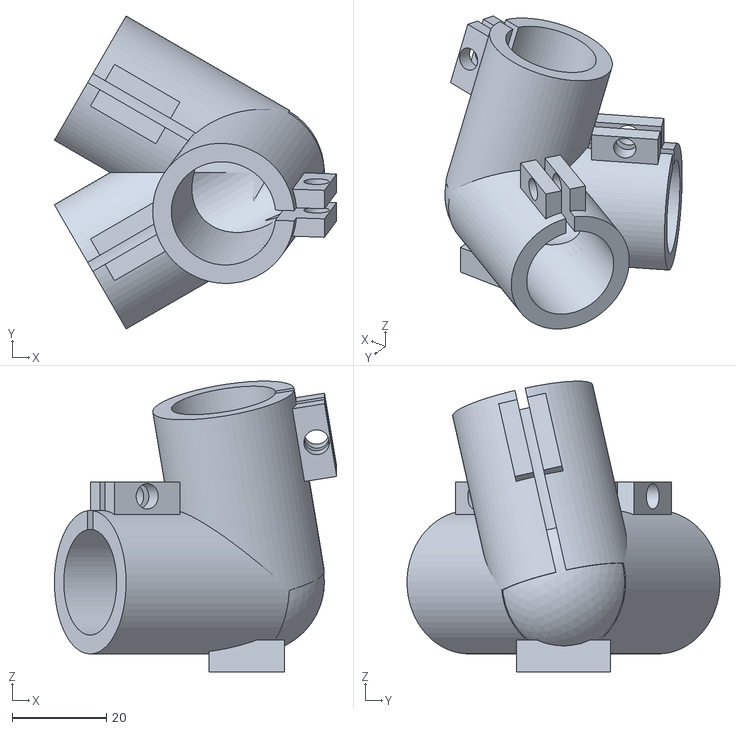
[picture p65: CAD file, 2026-07-05]
truss/print_queue/tube_frame/17_Rocker_corner_node_30_x1.stl
59.8 x 66.3 x 61.6
