fvyshkov/newton/truss/print_queue/verkhniy_yarus/STOL_ALL.3mf

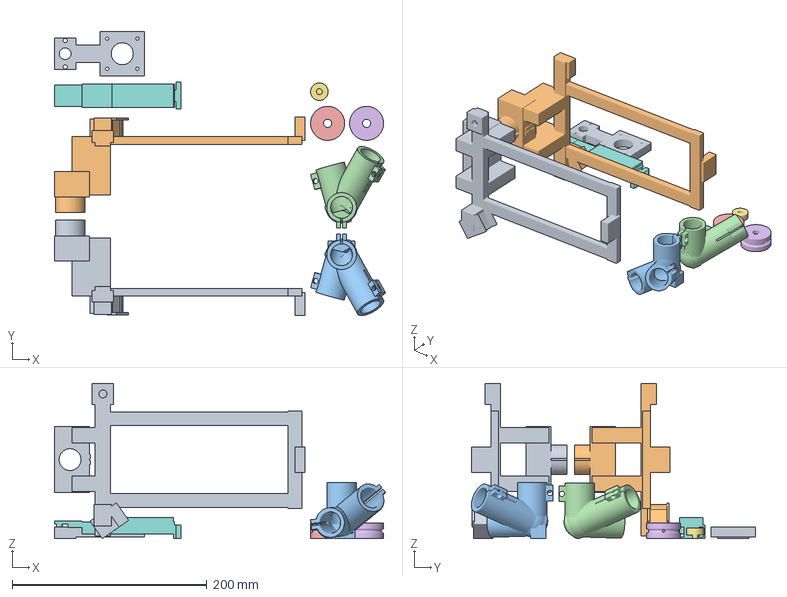
[picture p66: CAD file, 2026-07-12]
truss/print_queue/verkhniy_yarus/STOL_ALL.3mf
339.9 x 292.0 x 159.7 mm
cradle_R
cradle_L
apex_R
apex_L
roller_1
roller_2
magnet_cap
encoder_arm
alt_drive
