fvyshkov/newton/truss/stl/Rocker_alt_encoder_arm.step

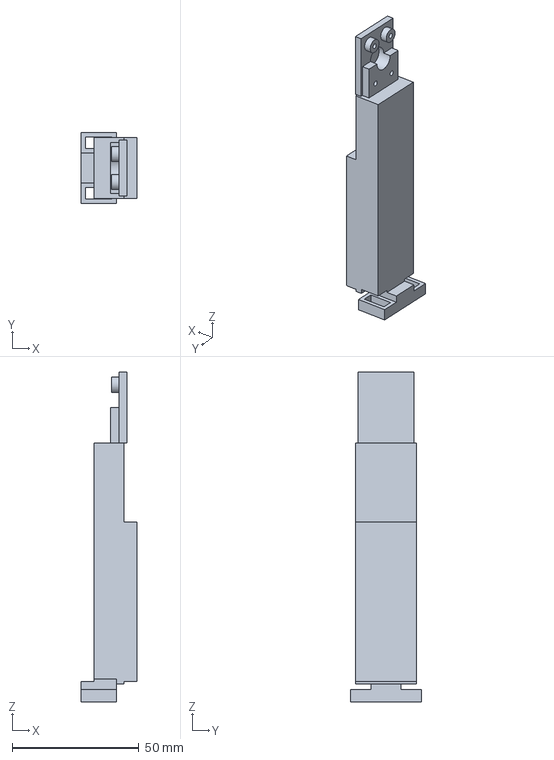
[picture p67: CAD file, 2026-07-12]
truss/stl/Rocker_alt_encoder_arm.step
22.0 x 28.0 x 130.0 mm
