fvyshkov/newton/stl/Focuser grub.stl

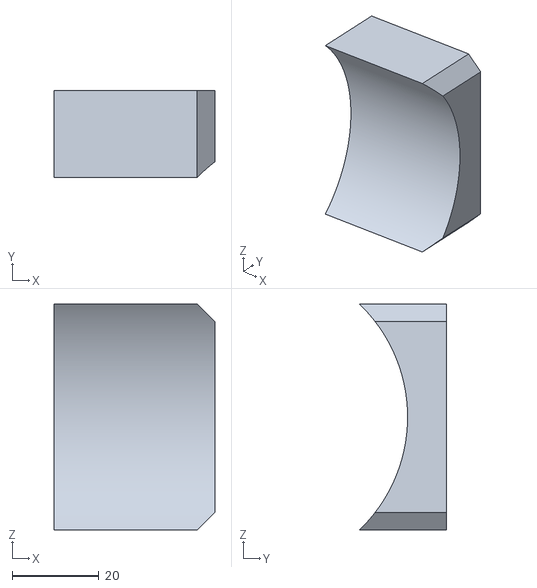
[picture p68: CAD file, 2026-05-13]
stl/Focuser grub.stl
37.0 x 20.1 x 52.0
