fvyshkov/newton/stl/mirror_cell/Mirror_cell_back.stl

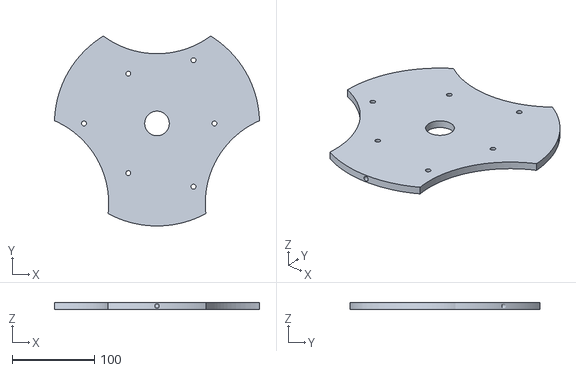
[picture p69: CAD file, 2026-05-16]
stl/mirror_cell/Mirror_cell_back.stl
249.9 x 231.6 x 8.00
