fvyshkov/newton/truss/incoming/son_Primary_Base.stl

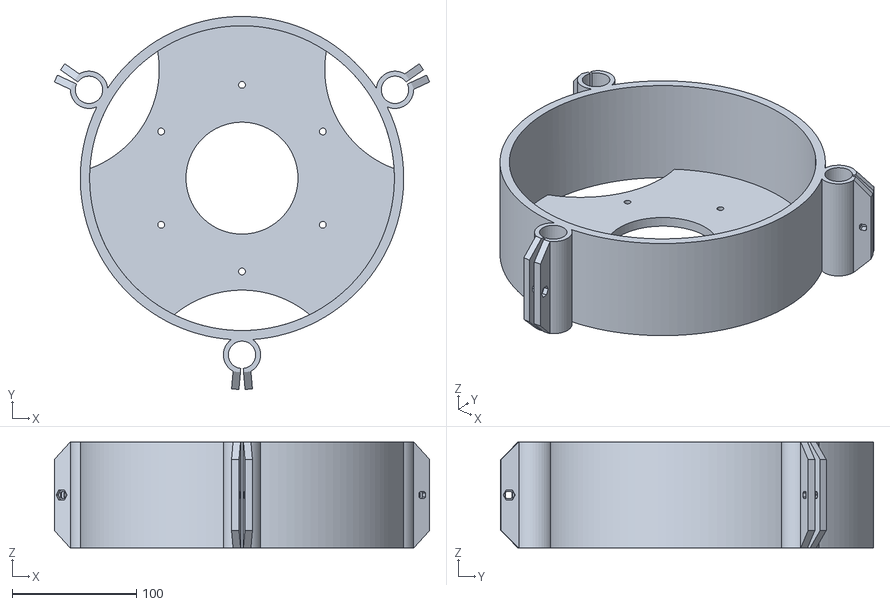
[picture p70: CAD file, 2026-07-04]
truss/incoming/son_Primary_Base.stl
301.8 x 299.8 x 85.0
