fvyshkov/newton/truss/print_queue/03_Rocker_ring_segment_x4.3mf

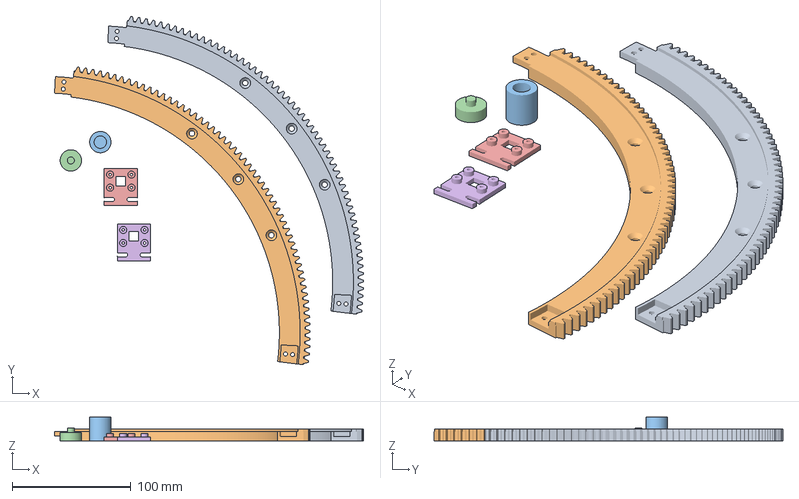
[picture p71: CAD file, 2026-07-04]
truss/print_queue/03_Rocker_ring_segment_x4.3mf
260.3 x 293.6 x 19.9 mm
03_Rocker_ring_segment_x4.stl x 2
04_magnet_cap_azimuth_x1.stl
05_magnet_cap_altitude_x1.stl
06_board_holder_x2.stl x 2
