fvyshkov/newton/truss/print_queue/azimuth2/plate3_center_4parts.3mf

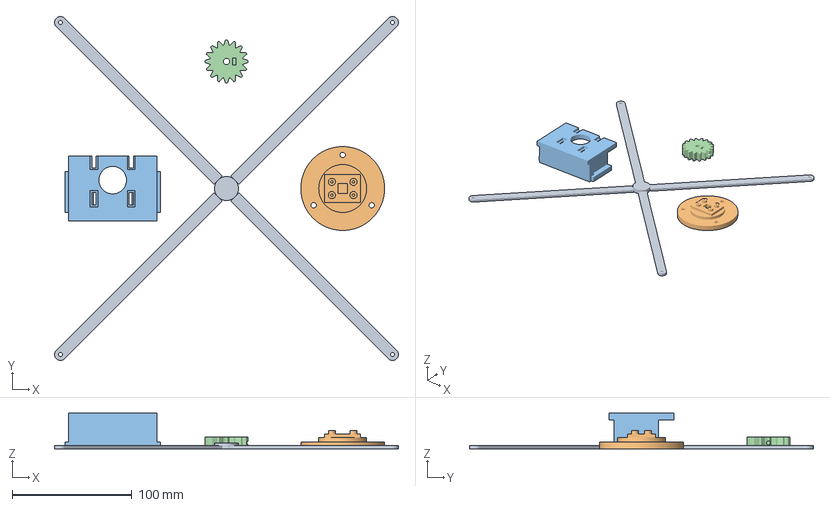
[picture p72: CAD file, 2026-07-13]
truss/print_queue/azimuth2/plate3_center_4parts.3mf
287.2 x 287.2 x 30.0 mm
geometry_0
geometry_1
geometry_2
geometry_3
