fvyshkov/newton/truss/print_queue/azimuth2/stl_отдельно/az2_ring_rot_A_leg30.stl

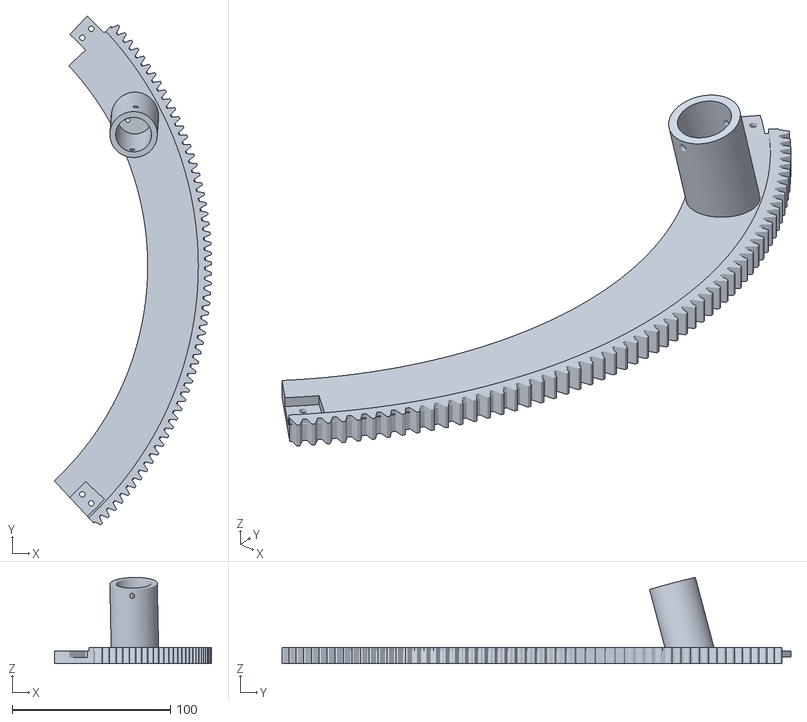
[picture p73: CAD file, 2026-07-13]
truss/print_queue/azimuth2/stl_отдельно/az2_ring_rot_A_leg30.stl
99.5 x 321.6 x 54.4
