fvyshkov/newton/truss/print_queue/motor_kron/Rocker_corner_drive_motor.3mf

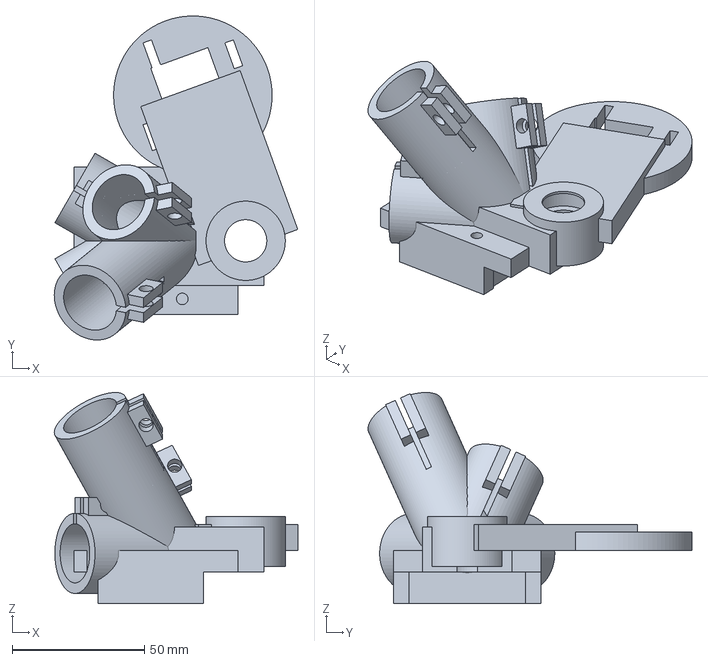
[picture p74: CAD file, 2026-07-08]
truss/print_queue/motor_kron/Rocker_corner_drive_motor.3mf
92.2 x 122.7 x 79.9 mm
