fvyshkov/newton/truss/print_queue/nizhnyaya_rama/17_Rocker_corner_node_30_x1.3mf

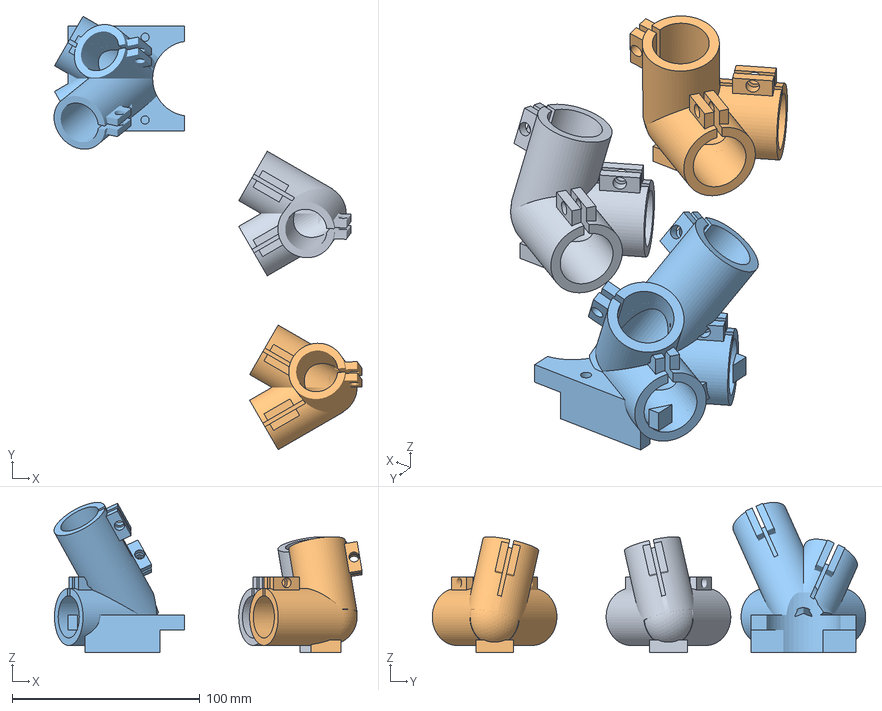
[picture p75: CAD file, 2026-07-08]
truss/print_queue/nizhnyaya_rama/17_Rocker_corner_node_30_x1.3mf
163.9 x 230.6 x 79.9 mm
17_Rocker_corner_node_30_x1.stl
18_Rocker_corner_node_150_x1.stl
19_Rocker_corner_drive_x1.stl
