fvyshkov/newton/truss/print_queue/sliced/rama_B.gcode.3mf

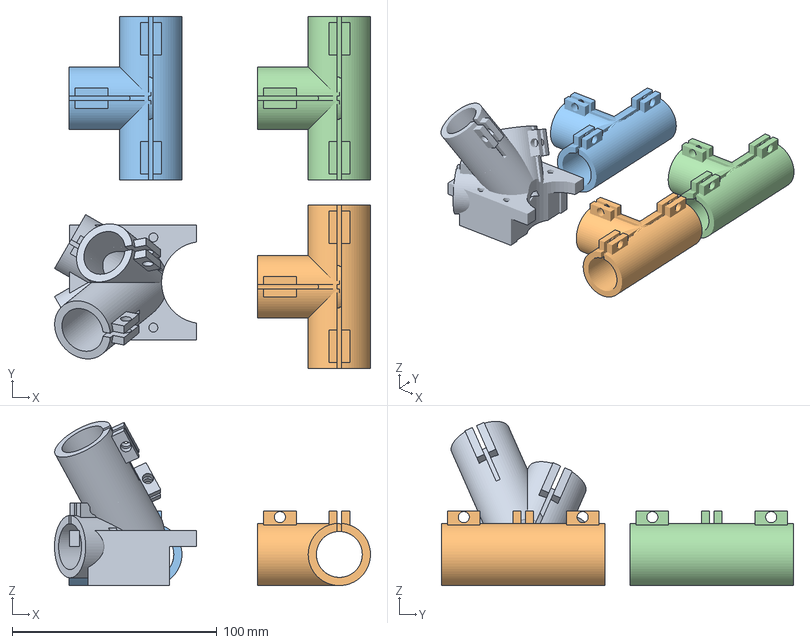
[picture p76: CAD file, 2026-07-05]
truss/print_queue/sliced/rama_B.gcode.3mf
154.2 x 172.0 x 80.1 mm
grid_00_19_Rocker_corner_drive_x1.stl
grid_01_20_Rocker_midchord_node_x3.stl
grid_02_20_Rocker_midchord_node_x3.stl
grid_03_20_Rocker_midchord_node_x3.stl
