fvyshkov/newton/truss/print_queue/tube_frame/19_Rocker_corner_drive_x1.stl

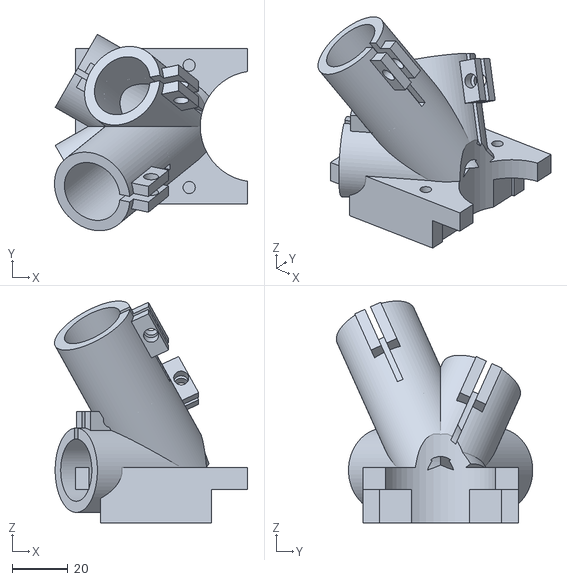
[picture p77: CAD file, 2026-07-05]
truss/print_queue/tube_frame/19_Rocker_corner_drive_x1.stl
69.5 x 70.7 x 79.9
