fvyshkov/newton/truss/print_queue/verkhniy_yarus/04_Rocker_cradle_L_x1.stl

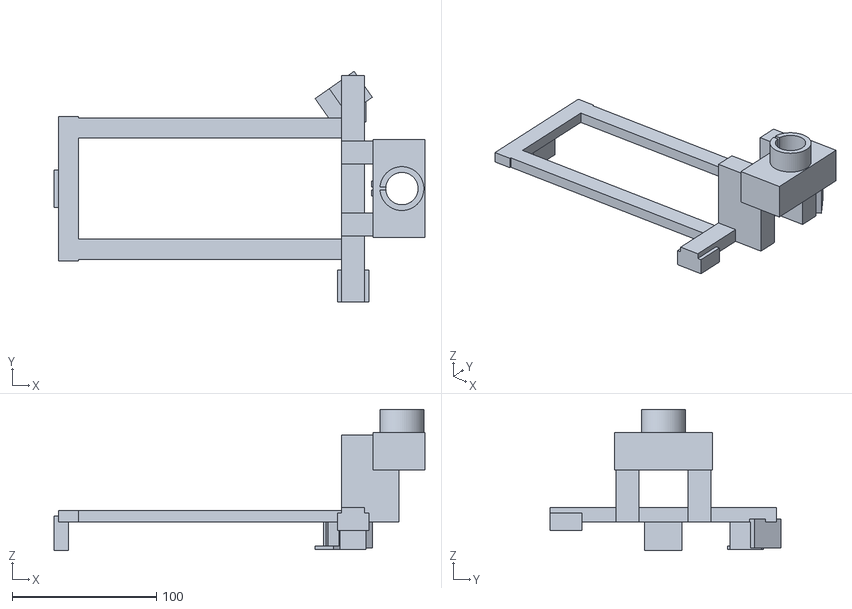
[picture p78: CAD file, 2026-07-12]
truss/print_queue/verkhniy_yarus/04_Rocker_cradle_L_x1.stl
257.0 x 159.7 x 98.0
