fvyshkov/newton/stl/Focuser outer top.stl

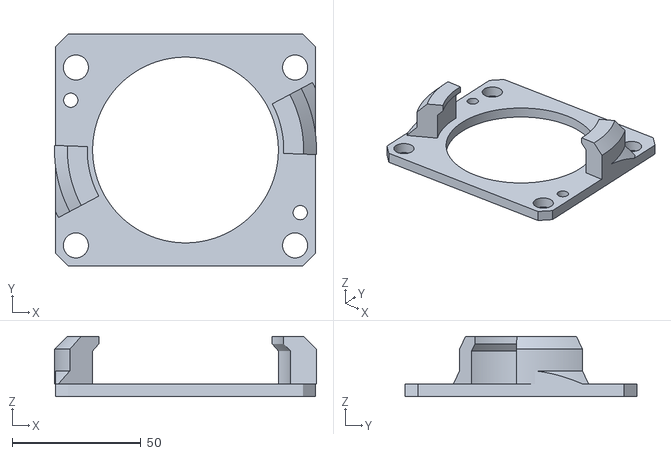
[picture p80: CAD file, 2026-05-13]
stl/Focuser outer top.stl
101.6 x 90.0 x 23.4
