fvyshkov/newton/truss/print_queue/07_Rocker_hub_ground_x1.stl

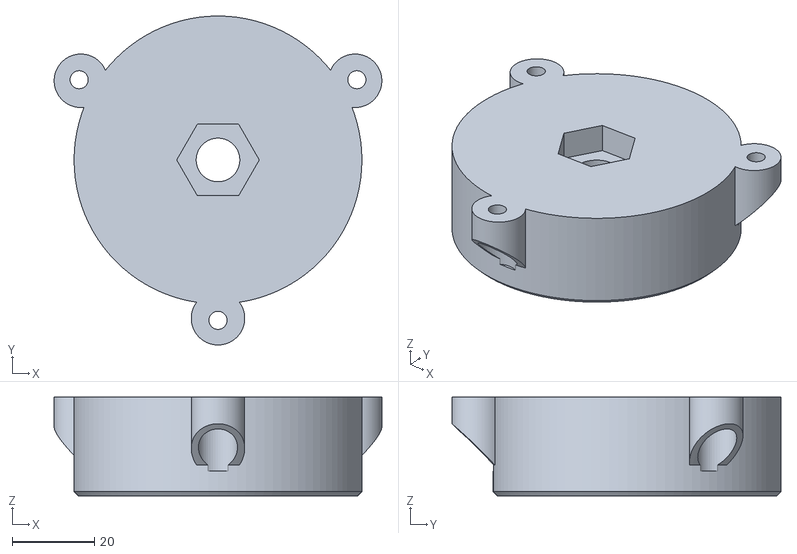
[picture p81: CAD file, 2026-07-03]
truss/print_queue/07_Rocker_hub_ground_x1.stl
79.7 x 80.0 x 24.0
