fvyshkov/newton/truss/print_queue/azimuth2/plate1_ring_fixed_x4.3mf

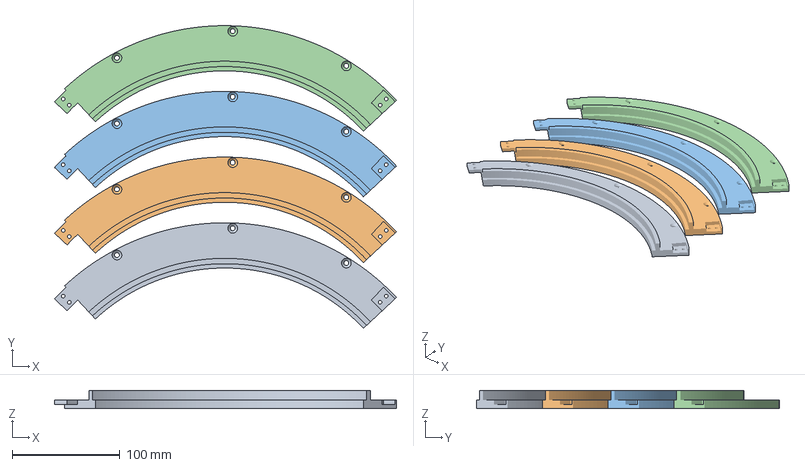
[picture p82: CAD file, 2026-07-13]
truss/print_queue/azimuth2/plate1_ring_fixed_x4.3mf
317.4 x 281.0 x 17.0 mm
geometry_0
geometry_1
geometry_2
geometry_3
