fvyshkov/newton/truss/print_queue/sliced/frame_A.gcode.3mf

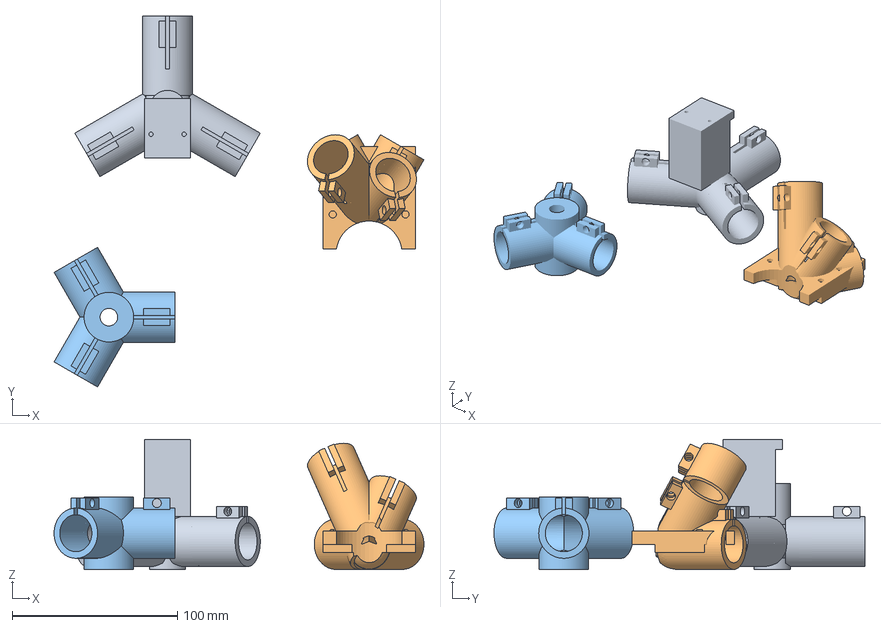
[picture p83: CAD file, 2026-07-05]
truss/print_queue/sliced/frame_A.gcode.3mf
223.7 x 224.4 x 78.7 mm
grounded_01_21_Rocker_center_node_x1.stl
grounded_02_19_Rocker_corner_drive_x1.stl
grounded_00_14_Rocker_hub_truss_x1.stl
