fvyshkov/newton/truss/stl/Rocker_corner_drive_motor.3mf

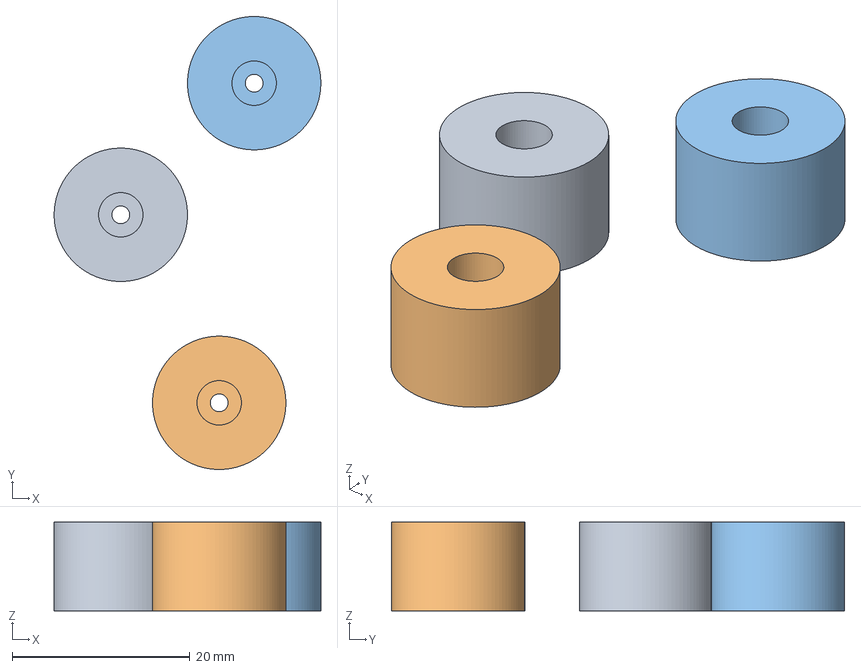
[picture p84: CAD file, 2026-07-12]
truss/stl/Rocker_corner_drive_motor.3mf
30.0 x 51.0 x 10.0 mm
collar_D15_H10_bore2_headrecess.stl x 3
