fvyshkov/newton/stl/1.25 eyepiece adapter.stl

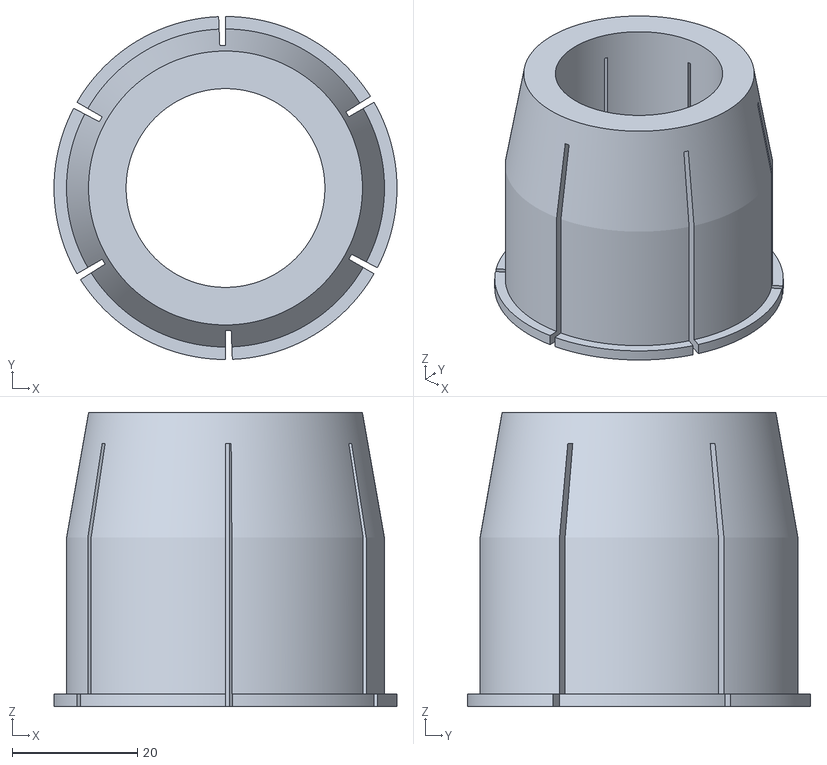
[picture p85: CAD file, 2026-05-13]
stl/1.25 eyepiece adapter.stl
54.8 x 54.8 x 47.0
