fvyshkov/newton/truss/azimuth2/stl/az2_shoe_D270.stl

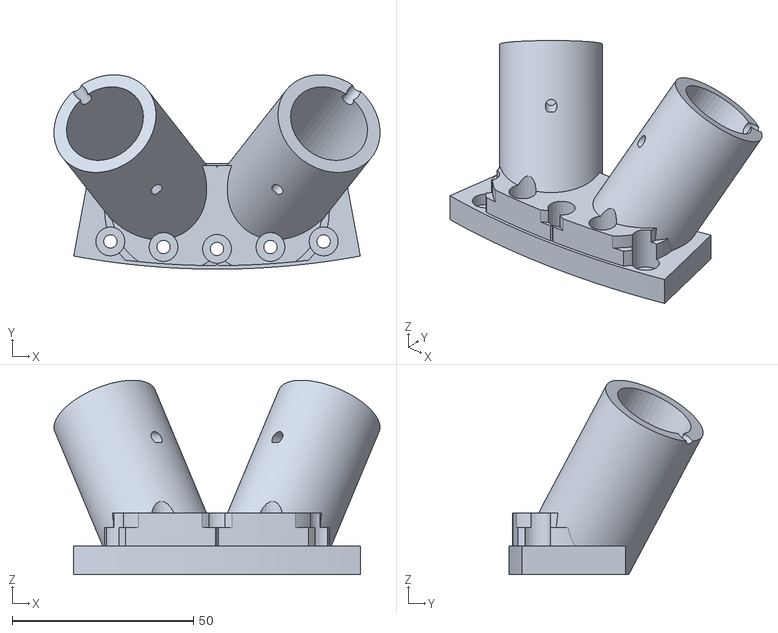
[picture p86: CAD file, 2026-07-13]
truss/azimuth2/stl/az2_shoe_D270.stl
90.0 x 53.6 x 53.7
