fvyshkov/newton/truss/print_queue/09_Rocker_az_motor_plate_x1.stl

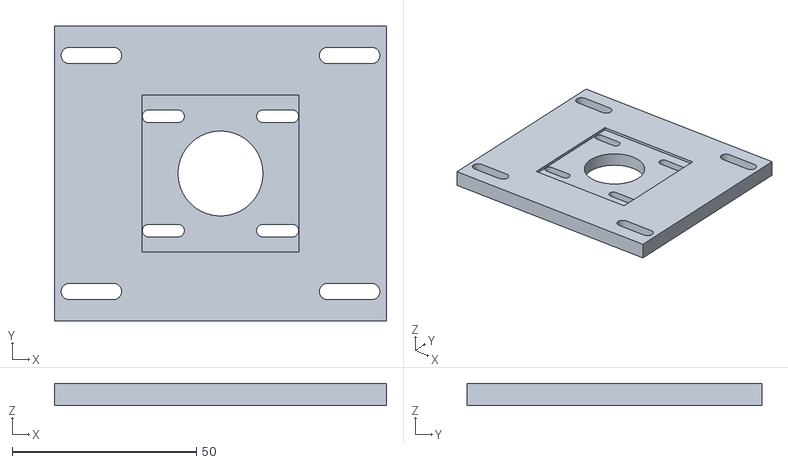
[picture p87: CAD file, 2026-07-03]
truss/print_queue/09_Rocker_az_motor_plate_x1.stl
90.0 x 80.0 x 6.00
