fvyshkov/newton/truss/print_queue/azimuth2/plate2_venec_rot_x4.3mf

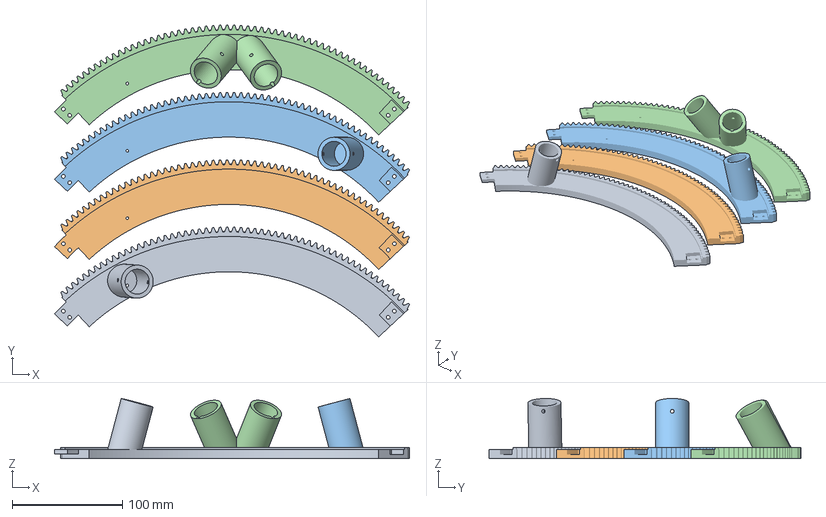
[picture p88: CAD file, 2026-07-13]
truss/print_queue/azimuth2/plate2_venec_rot_x4.3mf
321.6 x 282.5 x 54.4 mm
geometry_0
geometry_1
geometry_2
geometry_3
