fvyshkov/newton/truss/print_queue/sliced/pinion02_auto.gcode.3mf

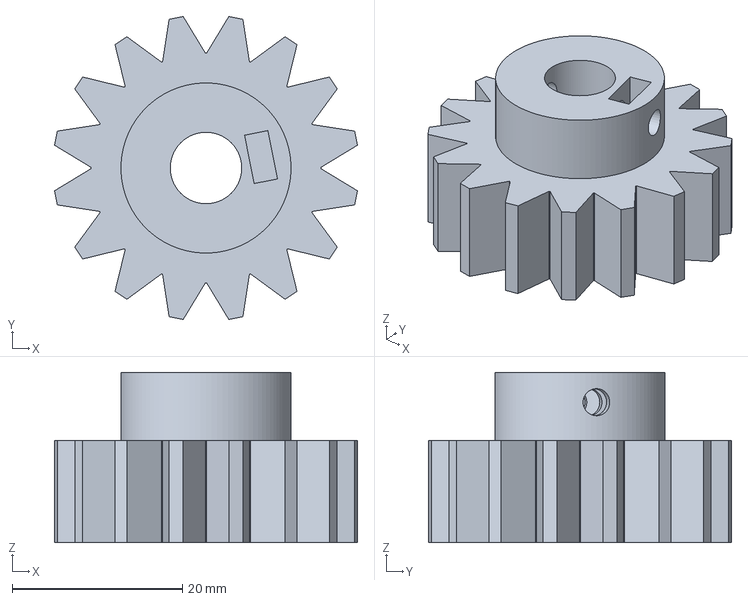
[picture p90: CAD file, 2026-07-04]
truss/print_queue/sliced/pinion02_auto.gcode.3mf
35.6 x 35.6 x 20.0 mm
