fvyshkov/newton/truss/print_queue/tube_frame/22_Rocker_tower_apex_R_x1.stl

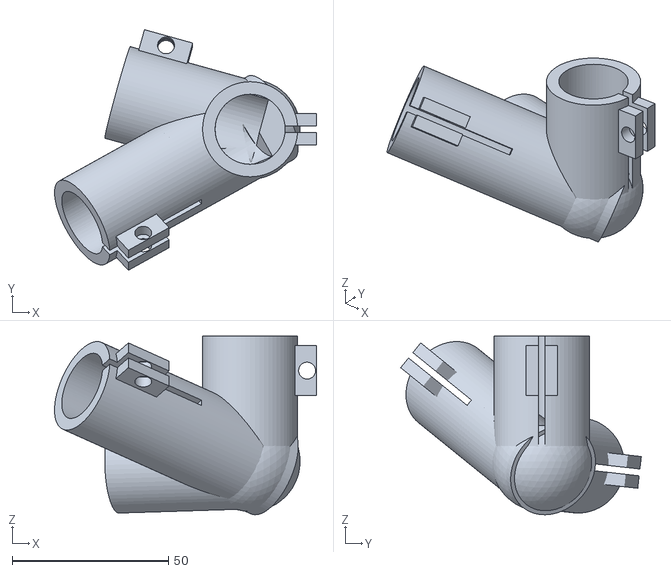
[picture p91: CAD file, 2026-07-05]
truss/print_queue/tube_frame/22_Rocker_tower_apex_R_x1.stl
83.7 x 76.9 x 57.1
