fvyshkov/newton/truss/print_queue/verkhniy_yarus/01_Rocker_tower_apex_R_x1.stl

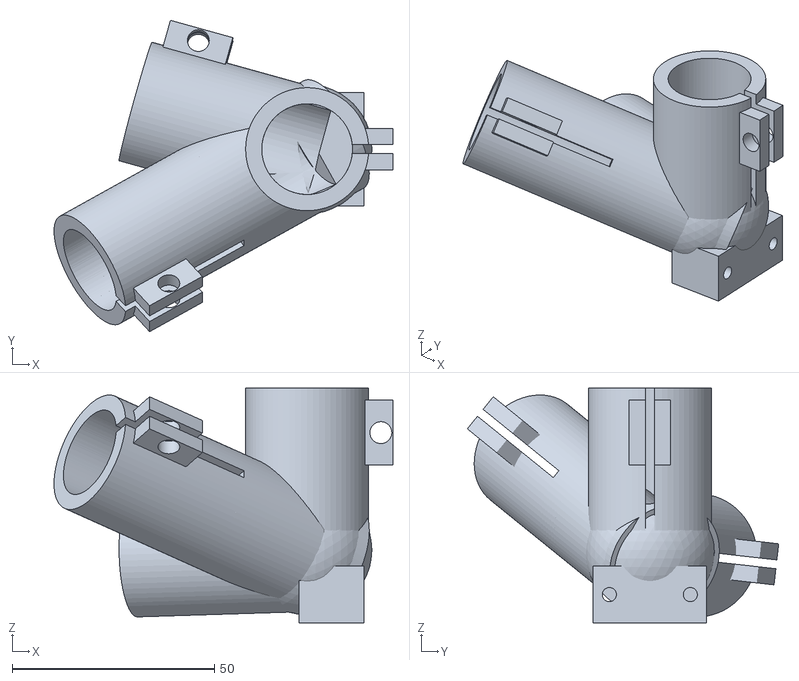
[picture p92: CAD file, 2026-07-12]
truss/print_queue/verkhniy_yarus/01_Rocker_tower_apex_R_x1.stl
83.7 x 76.9 x 58.0
