fvyshkov/newton/truss/stl/collar_D15_H10_bore2_topslot.stl

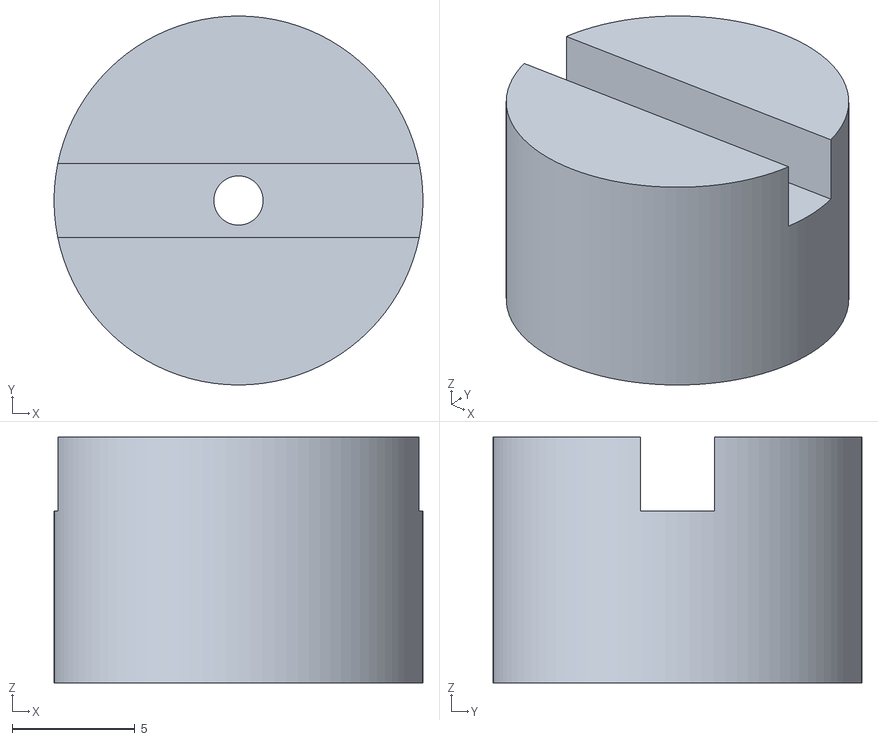
[picture p93: CAD file, 2026-07-12]
truss/stl/collar_D15_H10_bore2_topslot.stl
15.0 x 15.0 x 10.0
