fvyshkov/newton/truss/print_queue/11_Rocker_pivot_flange_x1.stl

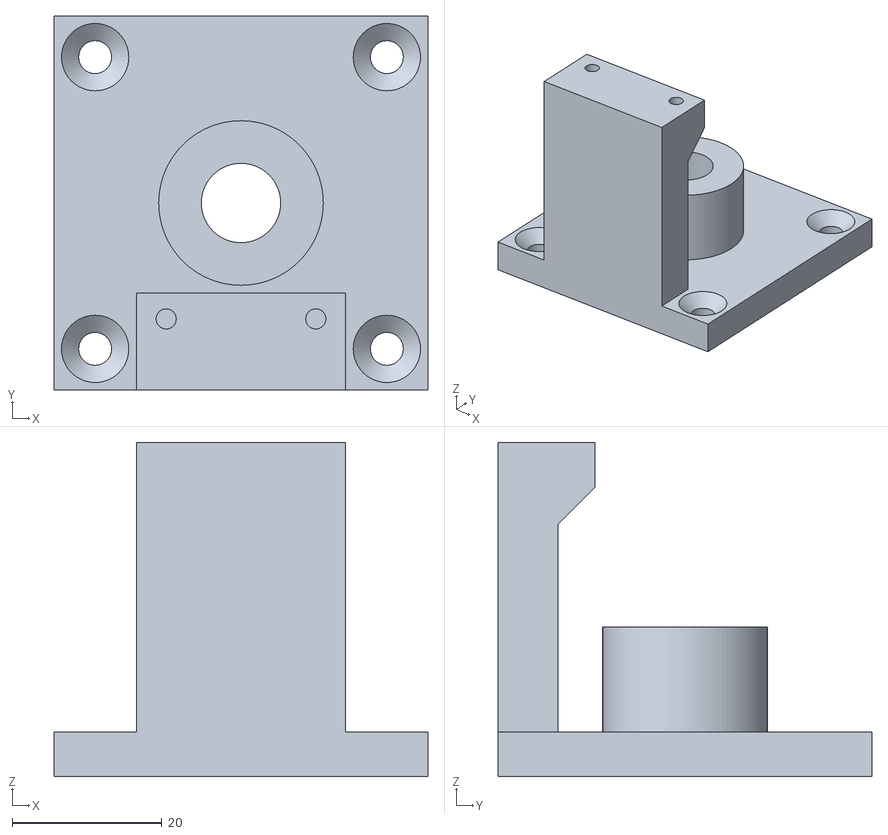
[picture p94: CAD file, 2026-07-03]
truss/print_queue/11_Rocker_pivot_flange_x1.stl
50.0 x 50.0 x 44.7
