fvyshkov/newton/truss/print_queue/azimuth2/plate4_bashmaki_center.3mf

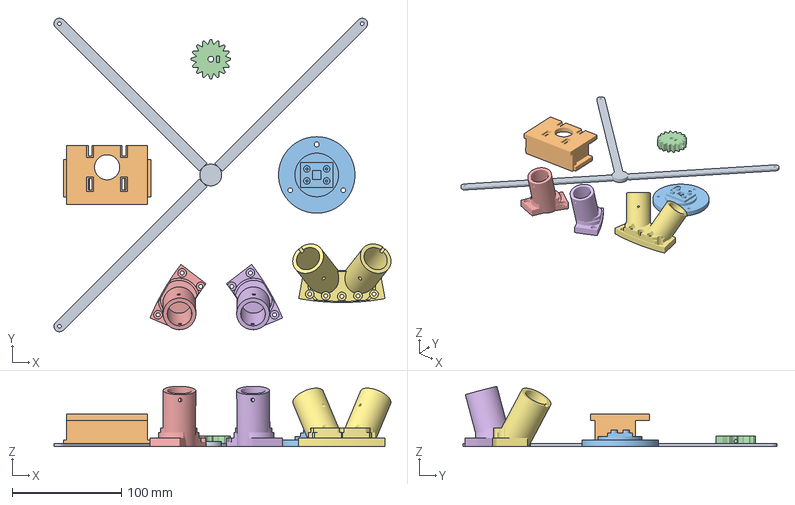
[picture p95: CAD file, 2026-07-13]
truss/print_queue/azimuth2/plate4_bashmaki_center.3mf
308.6 x 287.2 x 55.3 mm
geometry_0
geometry_1
geometry_2
geometry_3
geometry_4
geometry_5
geometry_6
