fvyshkov/newton/truss/print_queue/nizhnyaya_rama/21_Rocker_center_node_x1.stl

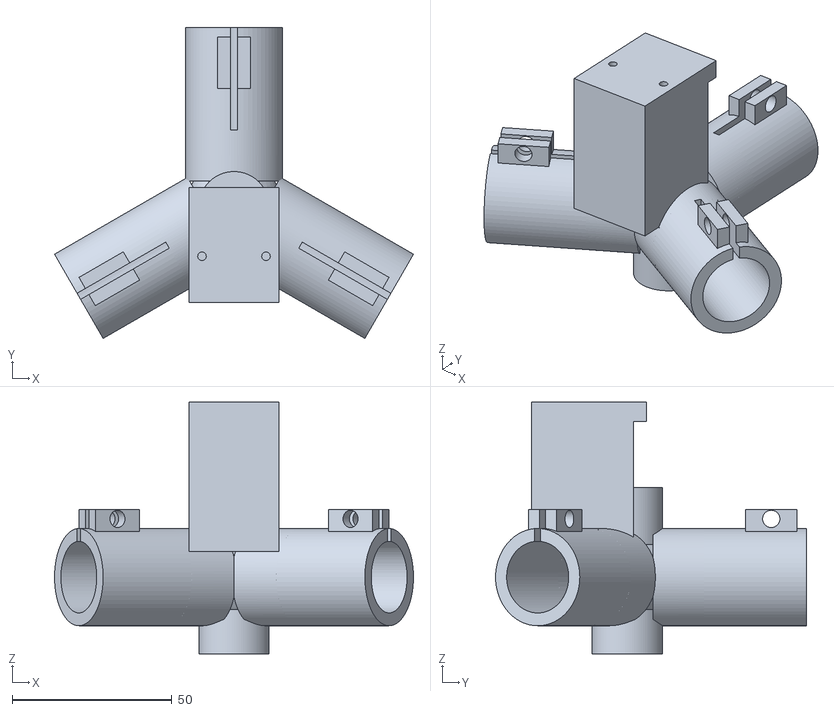
[picture p96: CAD file, 2026-07-05]
truss/print_queue/nizhnyaya_rama/21_Rocker_center_node_x1.stl
112.2 x 97.2 x 78.7
