fvyshkov/newton/truss/print_queue/sliced/plate3_bench.gcode.3mf

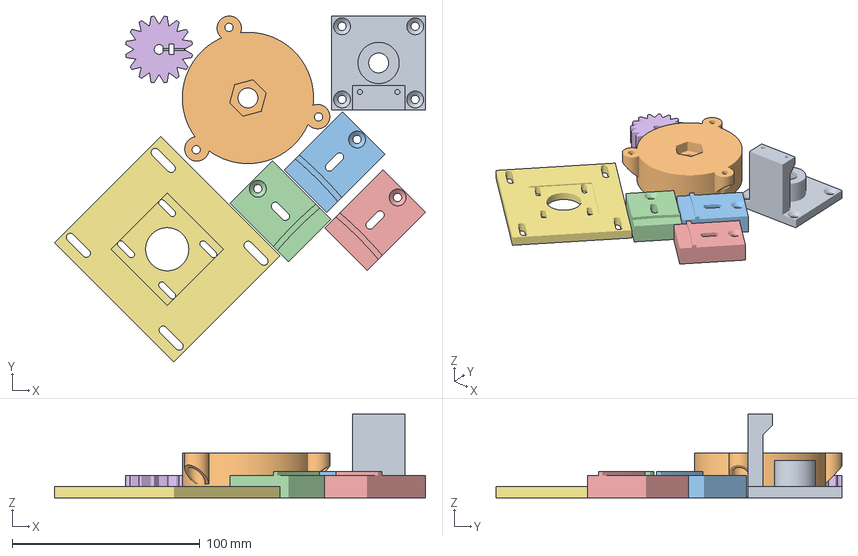
[picture p97: CAD file, 2026-07-04]
truss/print_queue/sliced/plate3_bench.gcode.3mf
197.8 x 184.5 x 44.7 mm
11_Rocker_pivot_flange_x1.stl
07_Rocker_hub_ground_x1.stl
08_Rocker_ring_saddle_x3.stl x 3
10_Rocker_pinion_16T_direct_x1.stl
09_Rocker_az_motor_plate_x1.stl
