fvyshkov/newton/truss/stl/Rocker_cradle_manual_R.stl

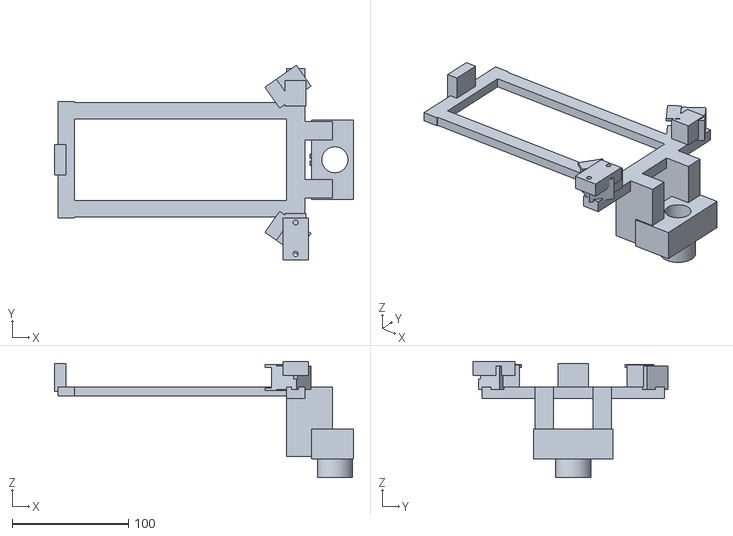
[picture p98: CAD file, 2026-07-12]
truss/stl/Rocker_cradle_manual_R.stl
257.0 x 167.3 x 100.0
