fvyshkov/newton/stl/Spider.stl

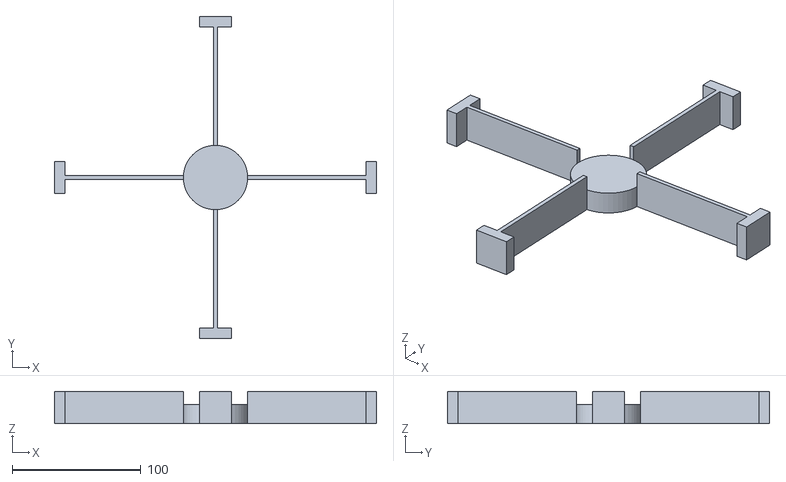
[picture p99: CAD file, 2026-05-13]
stl/Spider.stl
250.0 x 250.0 x 25.0
