fvyshkov/newton/truss/print_queue/10_Rocker_pinion_16T_direct_x1.stl

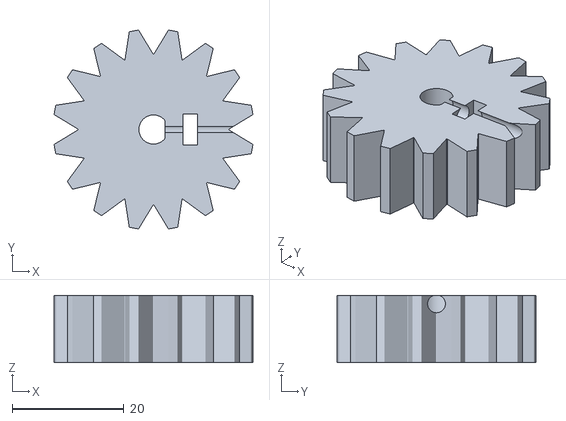
[picture p100: CAD file, 2026-07-03]
truss/print_queue/10_Rocker_pinion_16T_direct_x1.stl
35.6 x 35.6 x 12.0
