fvyshkov/newton/truss/print_queue/tube_frame/20_Rocker_midchord_node_x3.stl

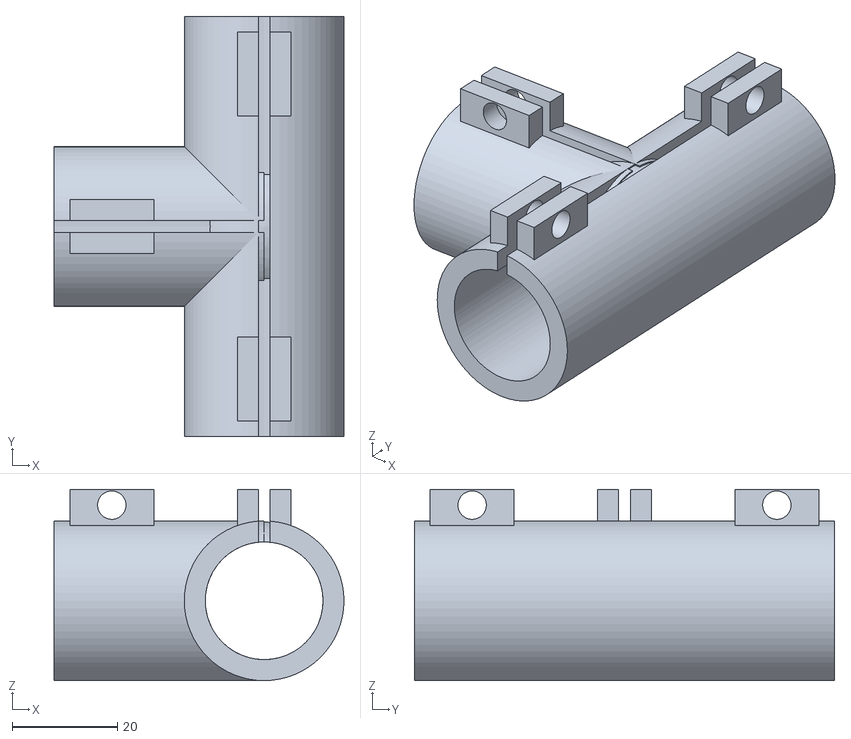
[picture p101: CAD file, 2026-07-05]
truss/print_queue/tube_frame/20_Rocker_midchord_node_x3.stl
55.2 x 80.0 x 36.4
