fvyshkov/newton/truss/print_queue/verkhniy_yarus/STOL_2.3mf

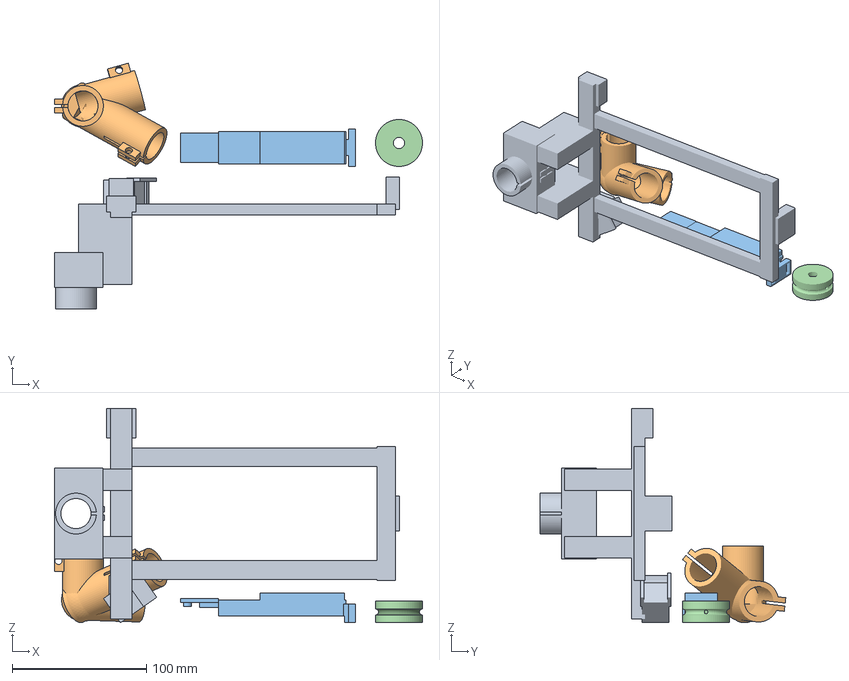
[picture p102: CAD file, 2026-07-12]
truss/print_queue/verkhniy_yarus/STOL_2.3mf
274.0 x 182.9 x 159.7 mm
cradle_L
apex_L
encoder_arm
roller_2
