fvyshkov/newton/truss/print_queue/01_Rocker_mesh_test_x1.stl

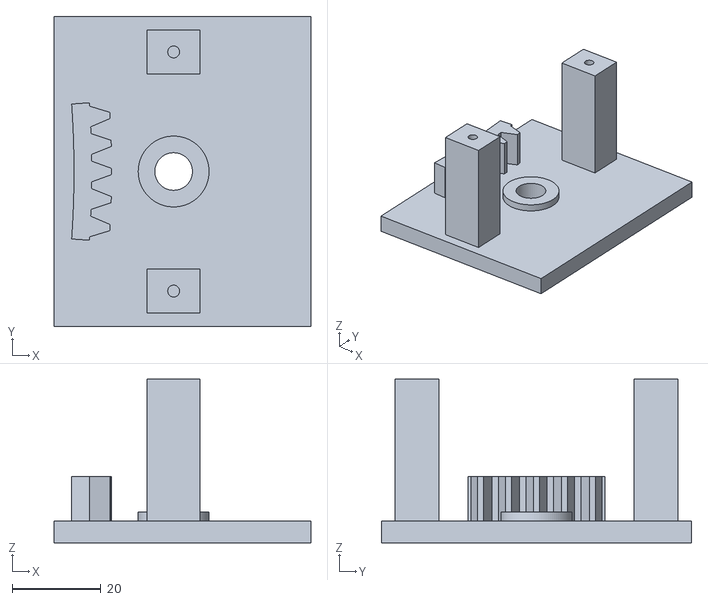
[picture p103: CAD file, 2026-07-03]
truss/print_queue/01_Rocker_mesh_test_x1.stl
58.0 x 70.0 x 37.0
