fvyshkov/newton/truss/print_queue/tube_frame/14_Rocker_hub_truss_x1.3mf

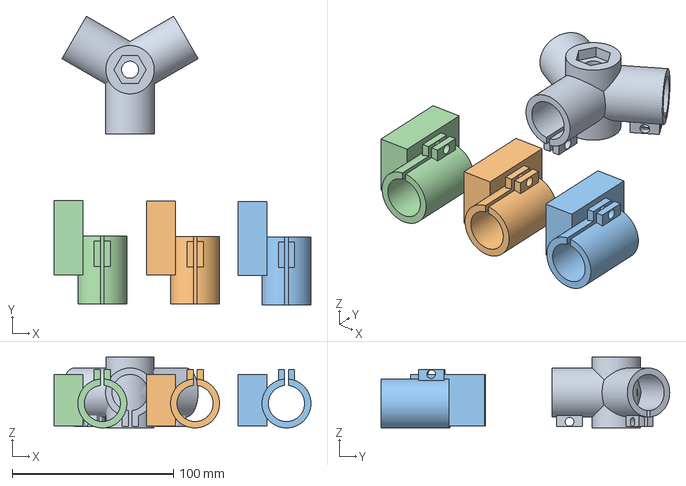
[picture p104: CAD file, 2026-07-05]
truss/print_queue/tube_frame/14_Rocker_hub_truss_x1.3mf
159.4 x 179.0 x 44.0 mm
14_Rocker_hub_truss_x1.stl
16_Rocker_ring_saddle_tube_x3.stl x 3
