fvyshkov/newton/truss/print_queue/verkhniy_yarus/STOL_1.3mf

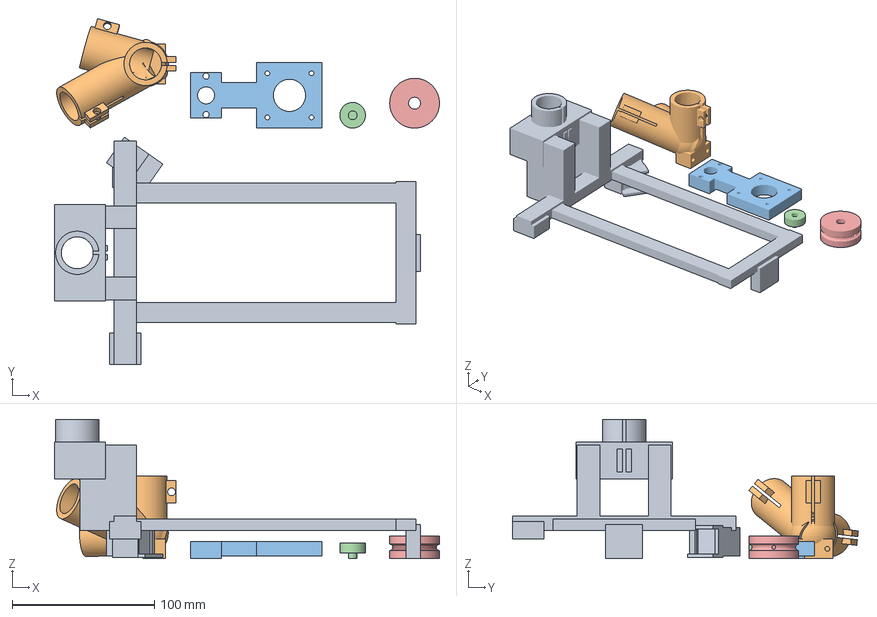
[picture p105: CAD file, 2026-07-12]
truss/print_queue/verkhniy_yarus/STOL_1.3mf
270.5 x 242.9 x 98.0 mm
cradle_R
apex_R
alt_drive
magnet_cap
roller
