fvyshkov/newton/stl/Collet.stl

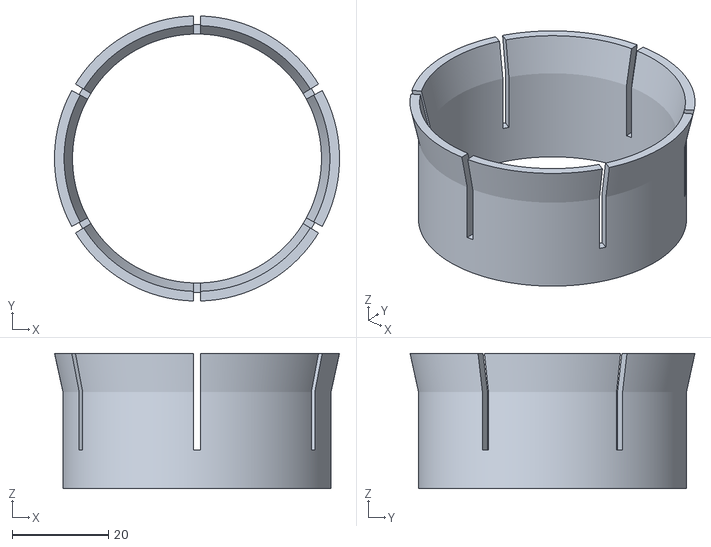
[picture p107: CAD file, 2026-05-13]
stl/Collet.stl
59.1 x 59.1 x 28.0
