fvyshkov/newton/truss/print_queue/01b_Rocker_mesh_bridge_x1.stl

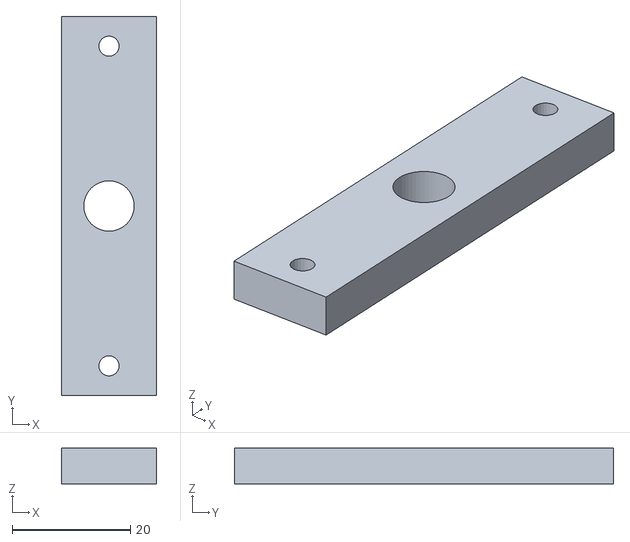
[picture p108: CAD file, 2026-07-03]
truss/print_queue/01b_Rocker_mesh_bridge_x1.stl
16.0 x 64.0 x 6.00
