fvyshkov/newton/truss/print_queue/tube_frame/25_Rocker_cradle_L_x1.stl

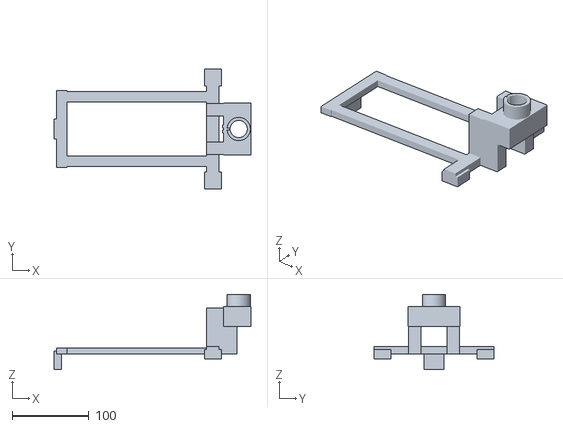
[picture p109: CAD file, 2026-07-04]
truss/print_queue/tube_frame/25_Rocker_cradle_L_x1.stl
257.0 x 156.8 x 98.0
