fvyshkov/newton/stl/Focuser outer bottom.stl

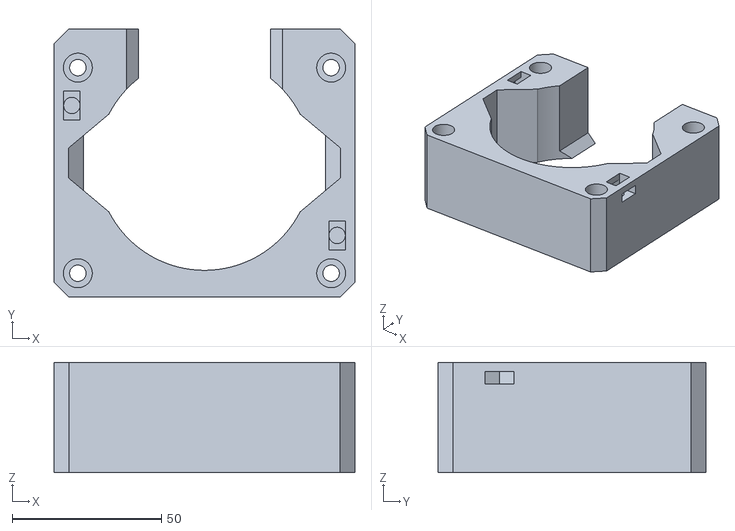
[picture p110: CAD file, 2026-05-13]
stl/Focuser outer bottom.stl
101.0 x 90.0 x 37.0
