fvyshkov/newton/truss/azimuth2/stl/az2_ring_fixed_seg.stl

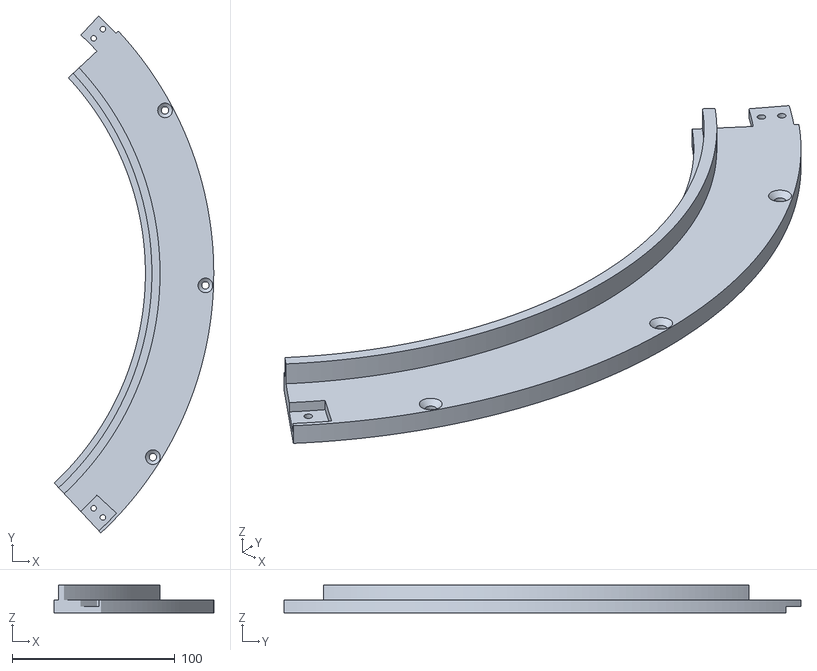
[picture p111: CAD file, 2026-07-12]
truss/azimuth2/stl/az2_ring_fixed_seg.stl
98.0 x 317.4 x 17.0
