fvyshkov/newton/truss/print_queue/azimuth2/stl_отдельно/az2_encoder_column.stl

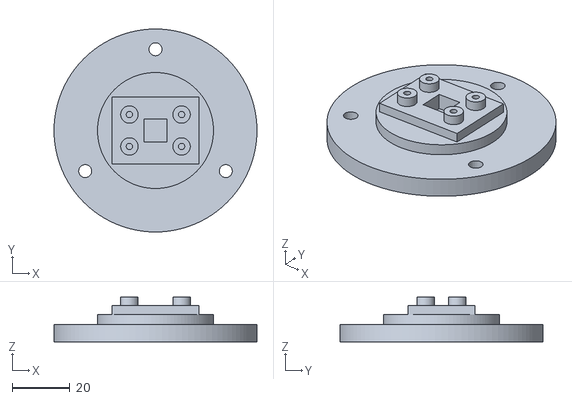
[picture p112: CAD file, 2026-07-12]
truss/print_queue/azimuth2/stl_отдельно/az2_encoder_column.stl
70.0 x 70.0 x 15.5
