fvyshkov/newton/truss/print_queue/verkhniy_yarus/05_Rocker_alt_drive_x1.stl

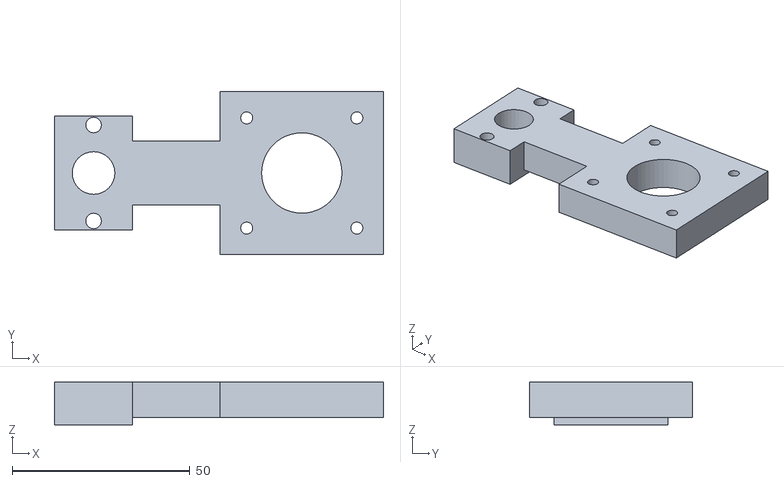
[picture p113: CAD file, 2026-07-04]
truss/print_queue/verkhniy_yarus/05_Rocker_alt_drive_x1.stl
92.6 x 46.0 x 12.0
