fvyshkov/newton/stl/Secondary holder.stl

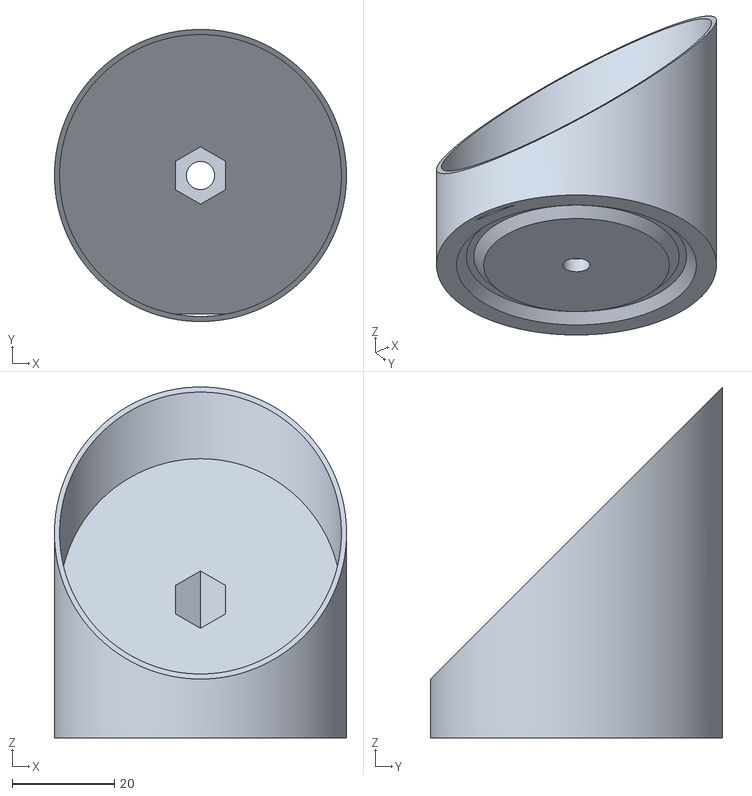
[picture p114: CAD file, 2026-05-13]
stl/Secondary holder.stl
57.0 x 57.0 x 68.5
