fvyshkov/newton/truss/azimuth2/stl/az2_motor_pedestal.stl

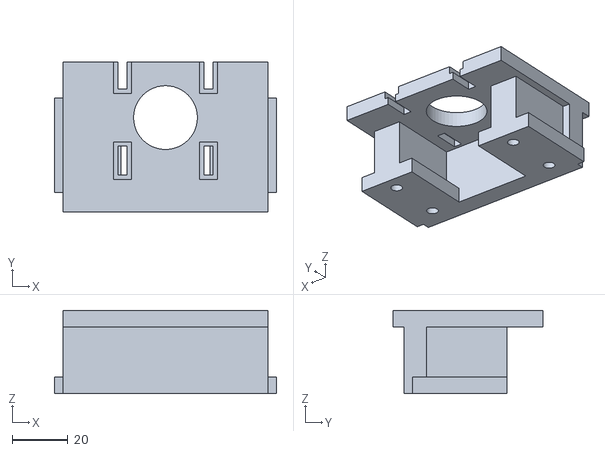
[picture p115: CAD file, 2026-07-12]
truss/azimuth2/stl/az2_motor_pedestal.stl
80.0 x 54.0 x 30.0
