fvyshkov/newton/truss/print_queue/verkhniy_yarus/06_Rocker_alt_roller_x2.stl

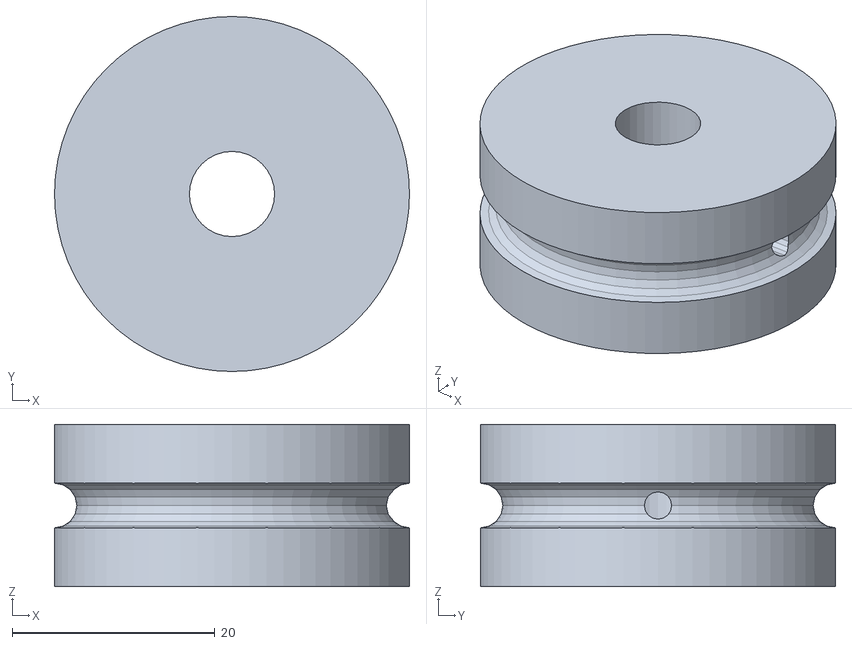
[picture p116: CAD file, 2026-07-04]
truss/print_queue/verkhniy_yarus/06_Rocker_alt_roller_x2.stl
35.0 x 35.0 x 16.0
