fvyshkov/newton/stl/Focuser ring.stl

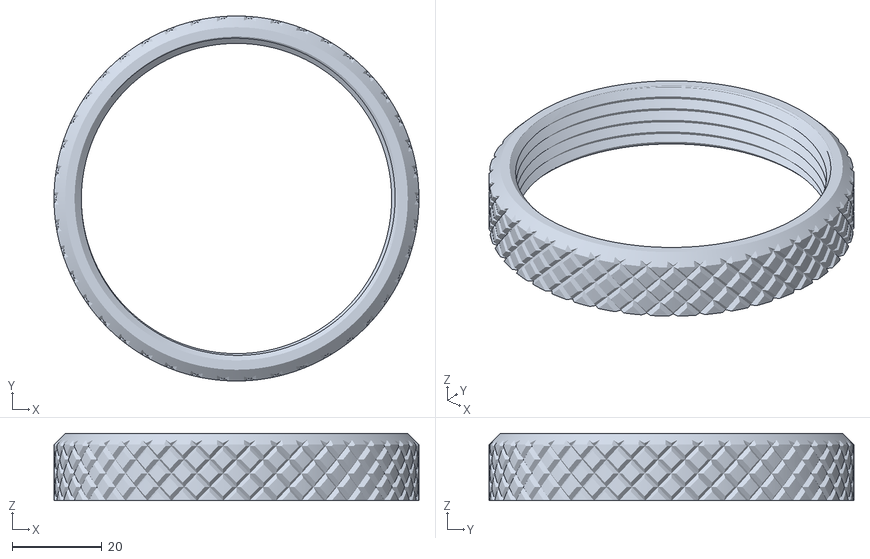
[picture p117: CAD file, 2026-05-13]
stl/Focuser ring.stl
81.2 x 81.2 x 15.0
