fvyshkov/newton/truss/print_queue/verkhniy_yarus/08_magnet_cap_altitude_x1.stl

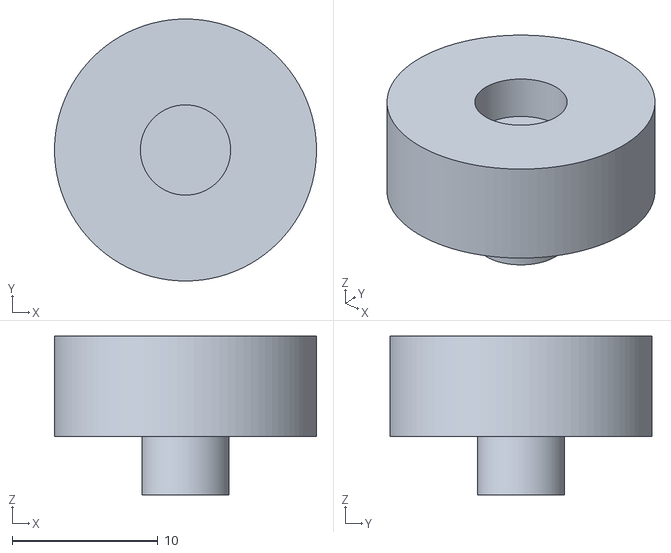
[picture p118: CAD file, 2026-07-03]
truss/print_queue/verkhniy_yarus/08_magnet_cap_altitude_x1.stl
18.0 x 18.0 x 10.9
