fvyshkov/newton/stl/Focuser inner.stl

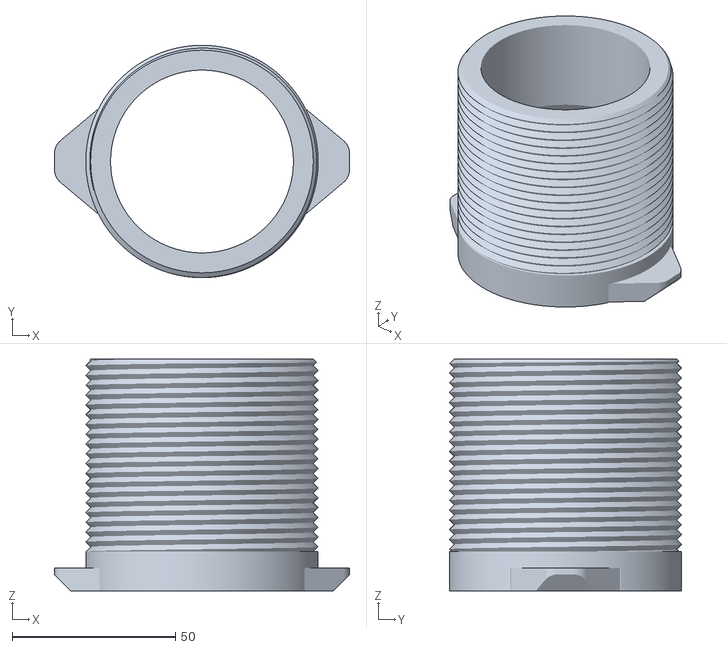
[picture p119: CAD file, 2026-05-13]
stl/Focuser inner.stl
90.4 x 71.2 x 71.0
