fvyshkov/newton/truss/azimuth2/stl/az2_magnet_spider.stl

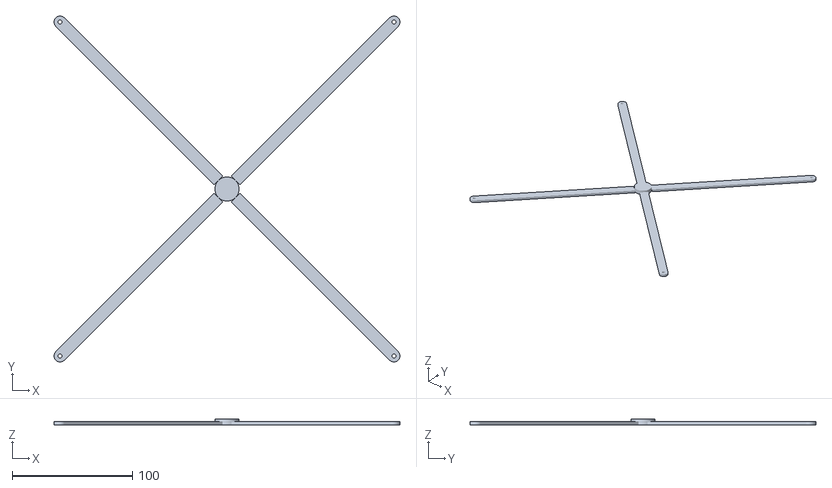
[picture p120: CAD file, 2026-07-12]
truss/azimuth2/stl/az2_magnet_spider.stl
287.2 x 287.2 x 5.00
