fvyshkov/newton/truss/stl/Rocker_hub_truss.stl

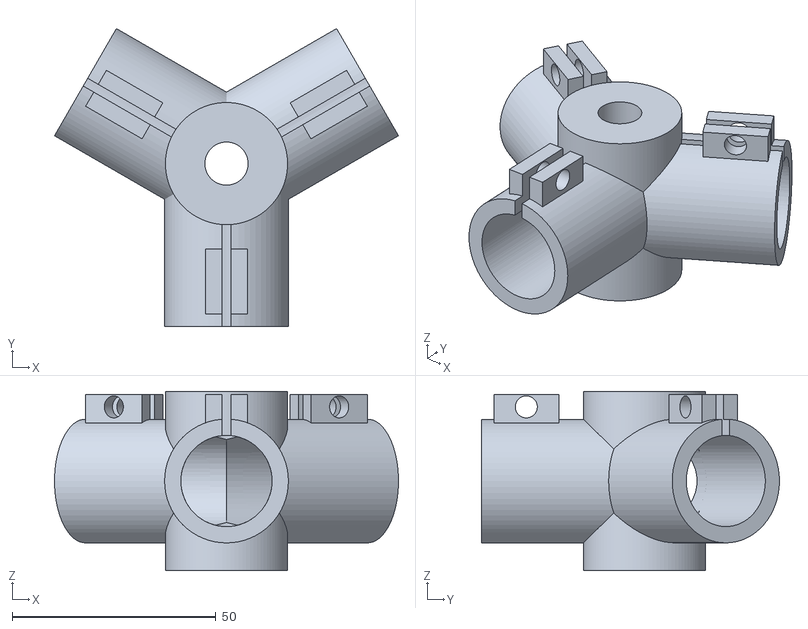
[picture p121: CAD file, 2026-07-04]
truss/stl/Rocker_hub_truss.stl
84.5 x 73.2 x 44.0
