fvyshkov/newton/truss/stl/Rocker_leg_truss.stl

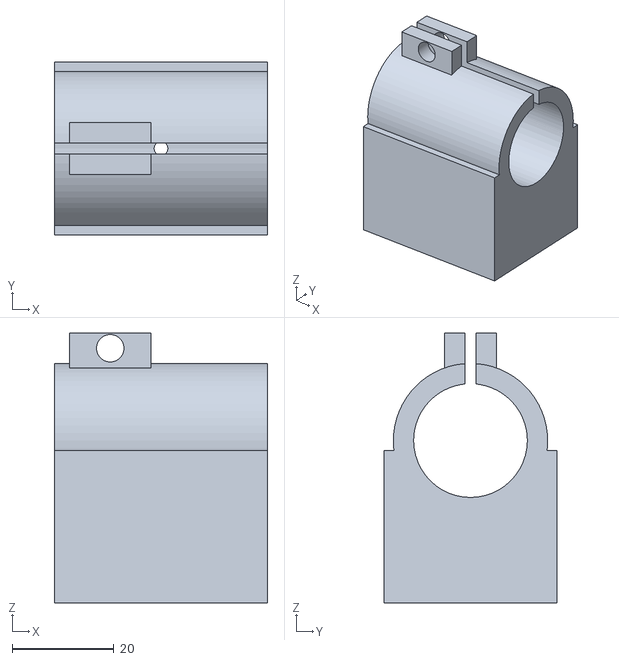
[picture p122: CAD file, 2026-07-04]
truss/stl/Rocker_leg_truss.stl
42.0 x 34.0 x 53.2
