fvyshkov/newton/truss/stl/Rocker_ring_saddle_tube.stl

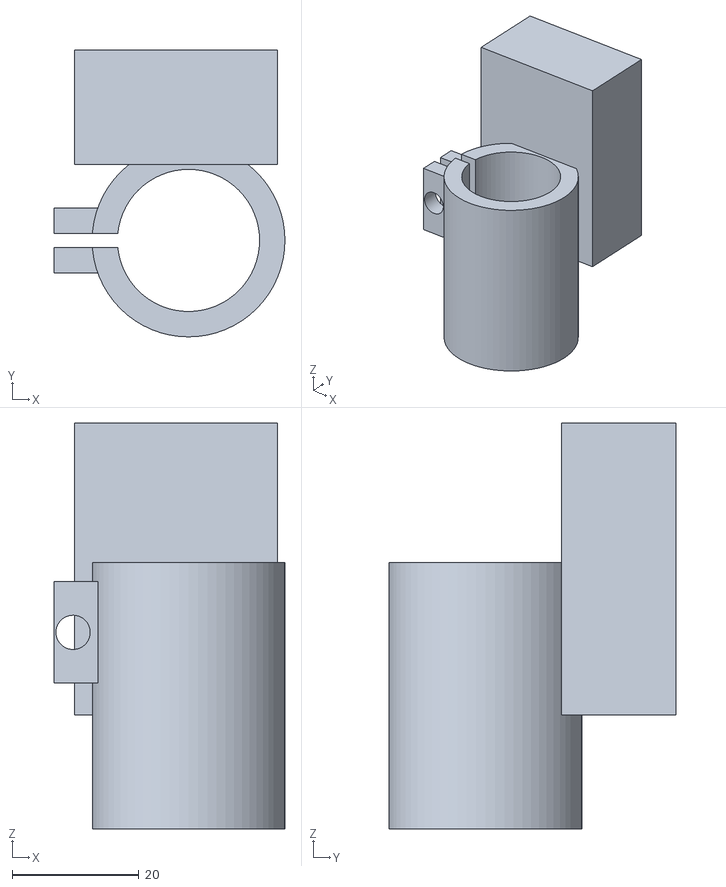
[picture p123: CAD file, 2026-07-04]
truss/stl/Rocker_ring_saddle_tube.stl
36.4 x 45.2 x 64.0
