fvyshkov/newton/truss/stl/_clamp_demo.stl

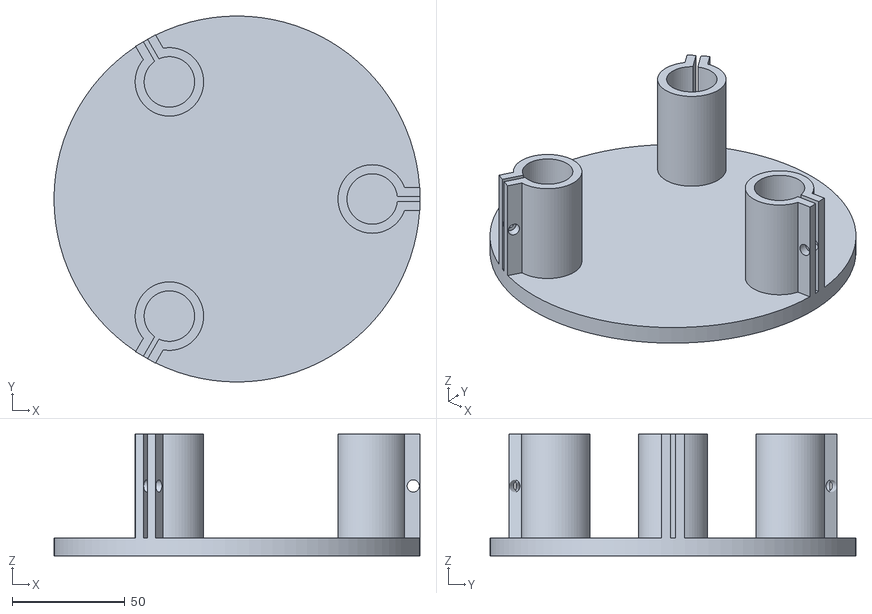
[picture p124: CAD file, 2026-07-04]
truss/stl/_clamp_demo.stl
162.4 x 162.4 x 54.0
