fvyshkov/newton/truss/stl/Rocker_ring_saddle.stl

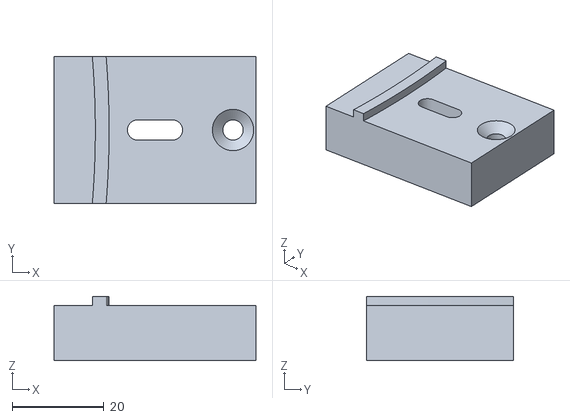
[picture p125: CAD file, 2026-07-03]
truss/stl/Rocker_ring_saddle.stl
44.0 x 32.0 x 14.0
