fvyshkov/newton/truss/stl/Rocker_ring_segment.stl

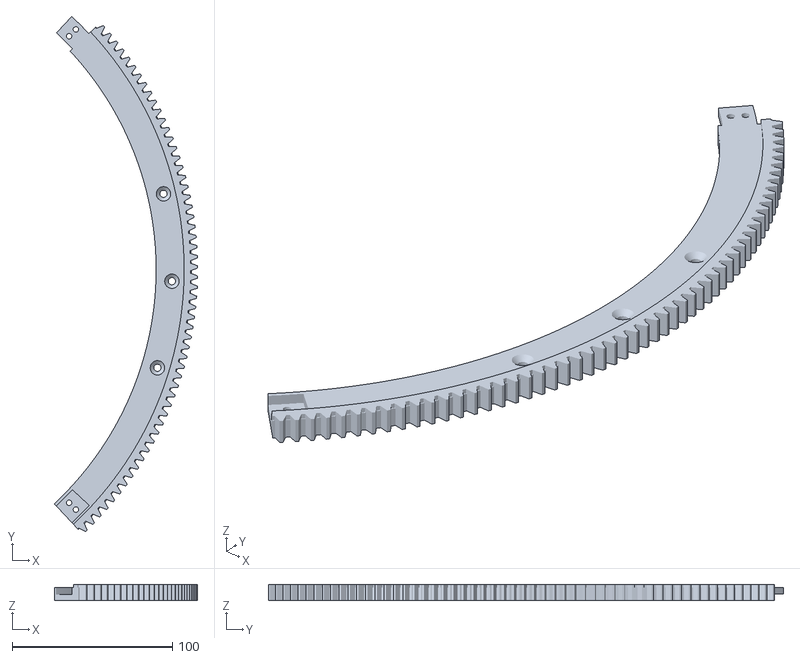
[picture p126: CAD file, 2026-07-03]
truss/stl/Rocker_ring_segment.stl
89.6 x 321.6 x 10.0
