fvyshkov/newton/truss/stl/Ref_leavitt_wheel.stl

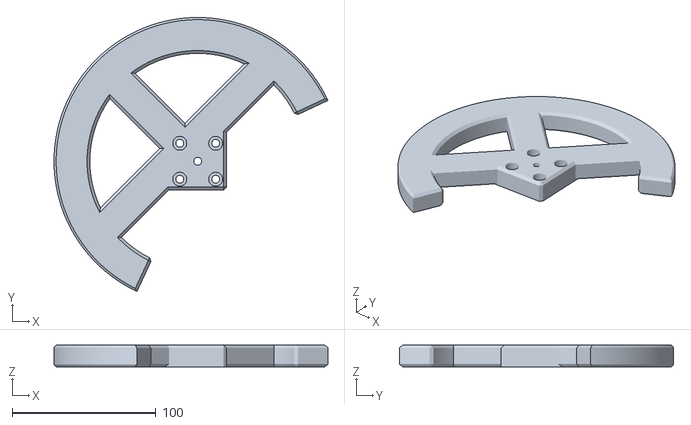
[picture p127: CAD file, 2026-07-03]
truss/stl/Ref_leavitt_wheel.stl
190.6 x 190.6 x 15.0
