fvyshkov/newton/truss/stl/Mirror_cell_back_truss.stl

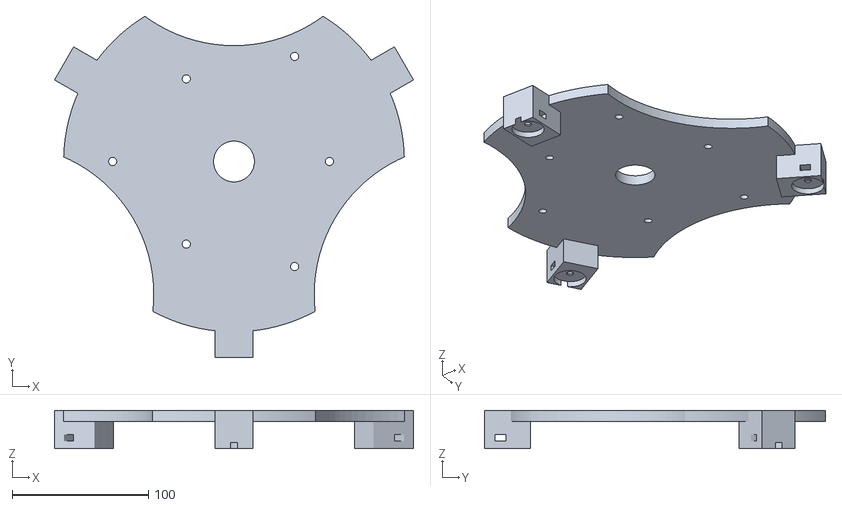
[picture p128: CAD file, 2026-06-05]
truss/stl/Mirror_cell_back_truss.stl
263.4 x 250.6 x 28.0
