fvyshkov/newton/truss/stl/Cell_leg_bracket.stl

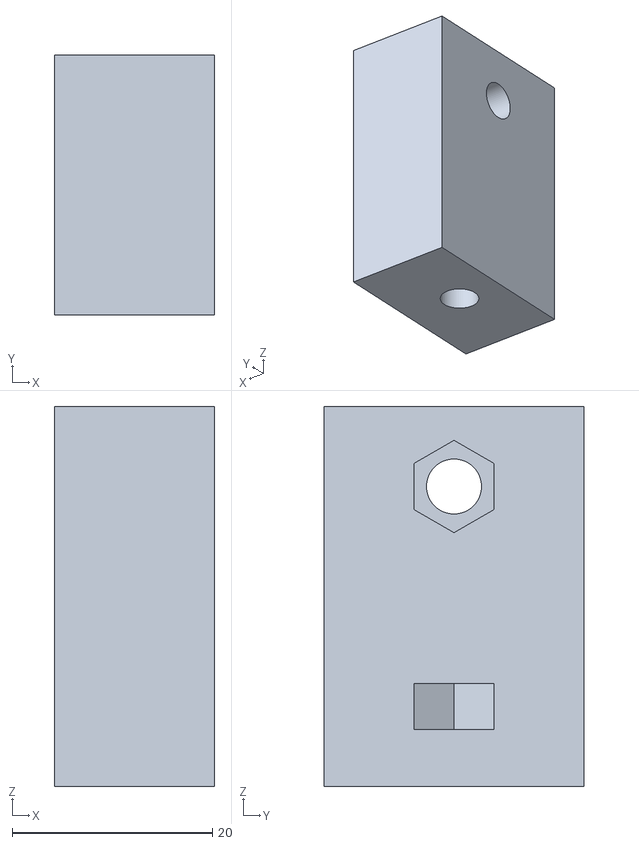
[picture p129: CAD file, 2026-06-05]
truss/stl/Cell_leg_bracket.stl
16.0 x 26.0 x 38.0
