fvyshkov/newton/truss/stl/Truss_socket.stl

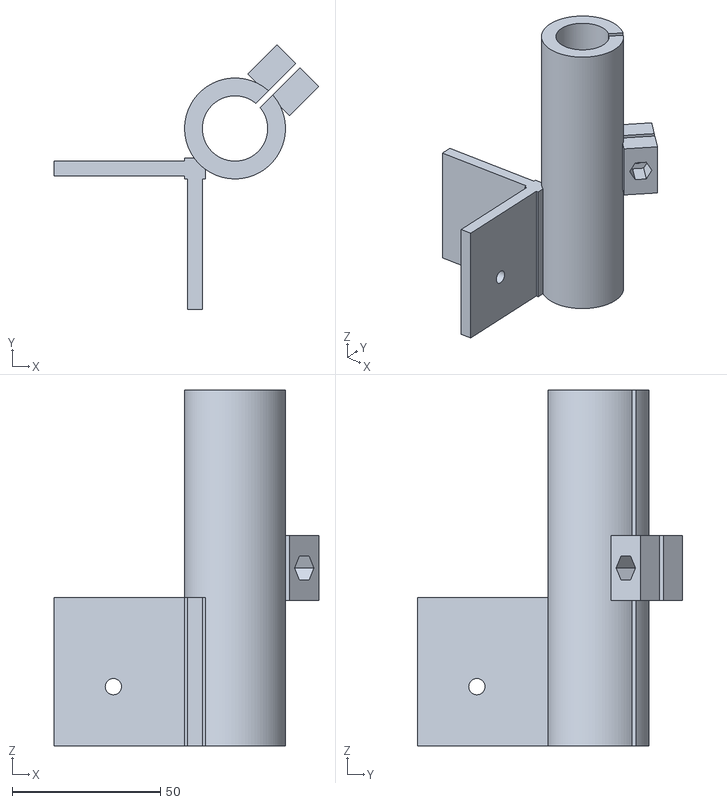
[picture p130: CAD file, 2026-06-02]
truss/stl/Truss_socket.stl
89.3 x 89.3 x 120.0
