fvyshkov/newton/truss/stl/Spider_4vane.stl

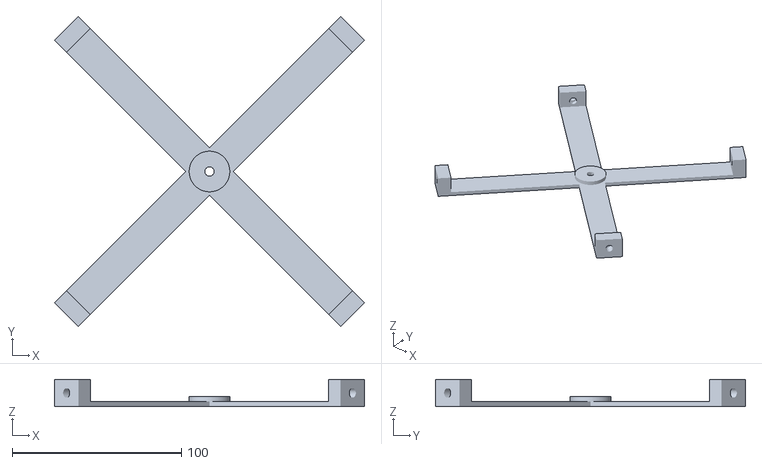
[picture p131: CAD file, 2026-05-28]
truss/stl/Spider_4vane.stl
183.1 x 183.1 x 16.0
