fvyshkov/newton/truss/stl/Mirror_box.stl

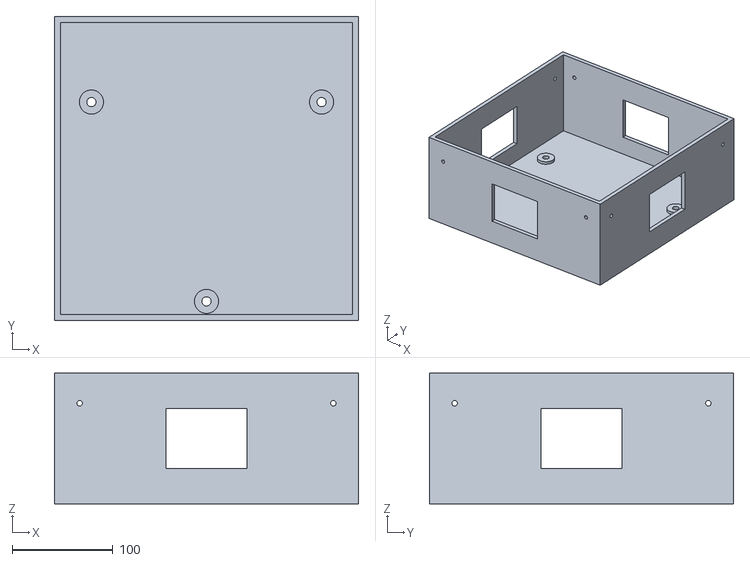
[picture p132: CAD file, 2026-05-24]
truss/stl/Mirror_box.stl
302.0 x 302.0 x 130.0
