fvyshkov/newton/truss/stl/UTA_ring.stl

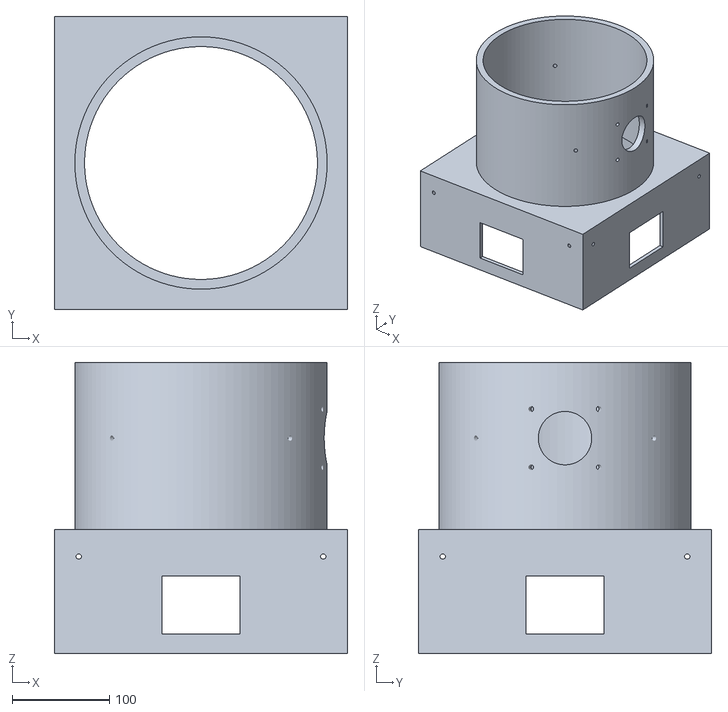
[picture p133: CAD file, 2026-05-24]
truss/stl/UTA_ring.stl
302.0 x 302.0 x 300.0
