fvyshkov/newton/truss/stl/Secondary_holder.stl

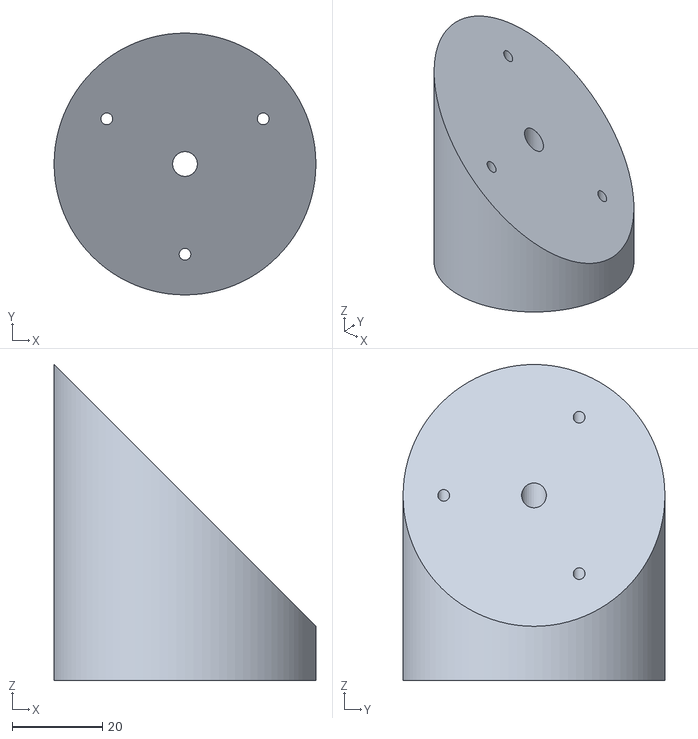
[picture p134: CAD file, 2026-05-24]
truss/stl/Secondary_holder.stl
58.0 x 58.0 x 70.0
