fvyshkov/newton/(list of files, cad)

Other CAD files:
truss/print_queue/azimuth2/venec_4seg/az2_ring_rot_C_leg150.stl
truss/print_queue/azimuth2/stl_отдельно/az2_shoe_C150.stl
truss/print_queue/nizhnyaya_rama/18_Rocker_corner_node_150_x1.stl
truss/print_queue/tube_frame/18_Rocker_corner_node_150_x1.stl
truss/print_queue/azimuth2/stl_отдельно/az2_ring_rot_C_leg150.stl
truss/print_queue/azimuth2/venec_4seg/stol_venec_4seg.3mf
truss/print_queue/verkhniy_yarus/03_Rocker_cradle_R_x1.stl
truss/azimuth2/stl/az2_shoe_C150.stl
truss/azimuth2/stl/az2_ring_rot_C_leg150.stl
truss/print_queue/verkhniy_yarus/02_Rocker_tower_apex_L_x1.stl
truss/stl/Rocker_cradle_manual_L.stl
truss/print_queue/tube_frame/24_Rocker_cradle_R_x1.stl
truss/print_queue/azimuth2/stl_отдельно/az2_pinion_16T_bore5.stl
truss/stl/Rocker_corner_node_150.stl
truss/azimuth2/stl/az2_pinion_16T_bore5.stl
truss/stl/Rocker_cradle_R.stl
stl/Collet nut.stl
stl/Focuser grub screw panel.stl
truss/print_queue/azimuth2/plate1_ring_fixed_x4.stl
truss/print_queue/azimuth2/plate2_venec_rot_x4.stl
truss/print_queue/azimuth2/plate3_center_4parts.stl
truss/print_queue/azimuth2/plate4_bashmaki_center.stl
truss/print_queue/azimuth2/venec_4seg/stol_venec_4seg.stl
truss/print_queue/motor_kron/Rocker_corner_drive_motor.stl
truss/print_queue/verkhniy_yarus/07_Rocker_alt_encoder_arm_x1.stl
truss/stl/Rocker_alt_encoder_arm.stl
truss/stl/Rocker_corner_drive_motor.stl
