fvyshkov/newton/truss/print_queue/nizhnyaya_rama/README.md

# НИЖНЯЯ РАМА — детали (7 узлов)

Только печатные узлы вращающейся рамы. Привод и энкодер — отдельно.

| Файл | Кол | Что |
|---|---|---|
| 17_Rocker_corner_node_30 | 1 | угол |
| 18_Rocker_corner_node_150 | 1 | угол |
| 19_Rocker_corner_drive | 1 | угол 270° (+ посадка привода) |
| 20_Rocker_midchord_node | 3 | стороны (середины хорд) |
| 21_Rocker_center_node | 1 | центр (втулка на ось M10) |

**= 3 угла + 3 стороны + 1 центр = 7 узлов.** PETG, 3 стенки, 30%.

Трубки Ø22 к раме: полухорды 6 шт × 182 мм, радиали 3 шт × 105 мм.
(длины заданы венцом R210: радиаль = R·cos60° = 105, полухорда = R·sin60° = 182.)
Согласовано с венцом: глайды R210 на дорожке, шестерня 240=224+16, углы 30/150/270.
