fvyshkov/newton/truss/assembly_full.png

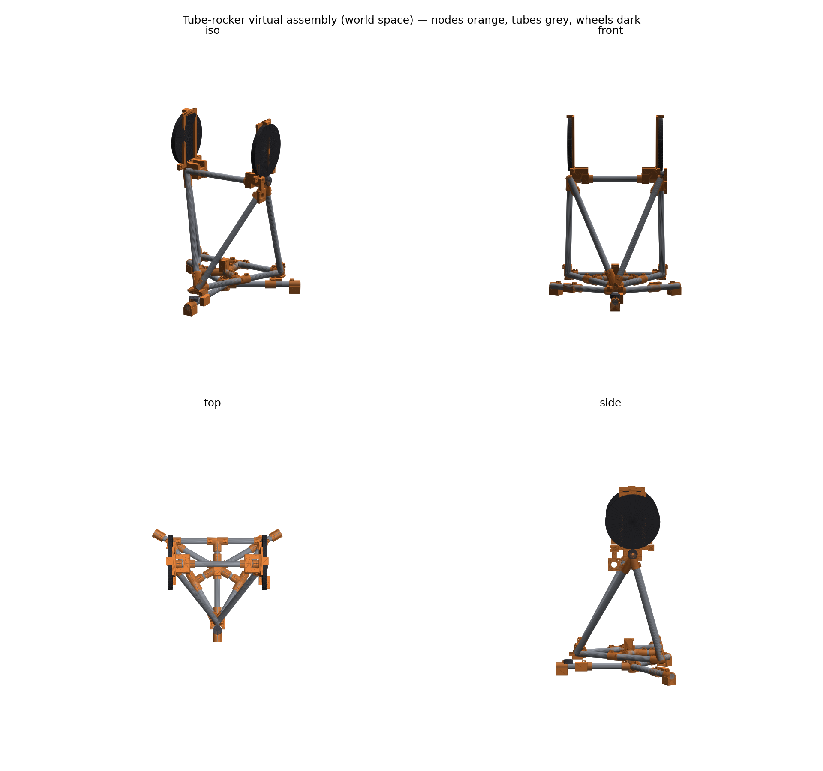
truss/assembly_full.png
