fvyshkov/newton/truss/print_queue/motor_kron/_assembly.png

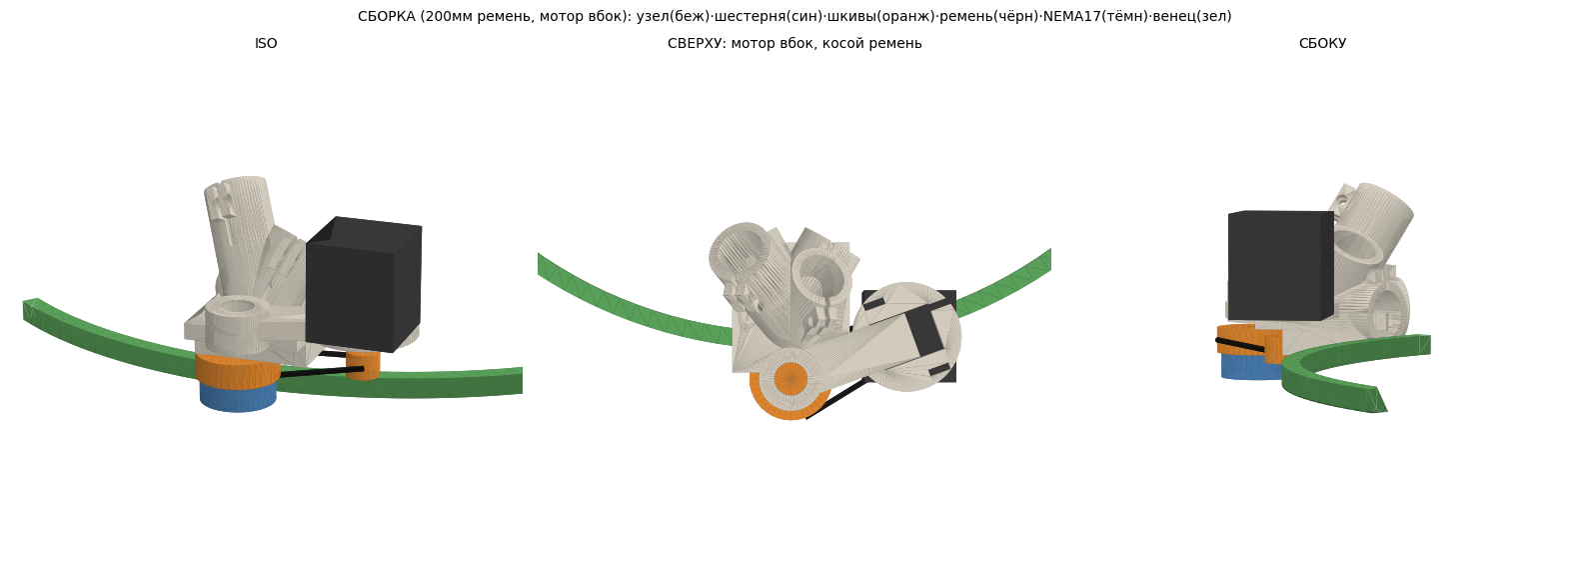
truss/print_queue/motor_kron/_assembly.png
