fvyshkov/newton/truss/print_queue/motor_kron/_preview.png

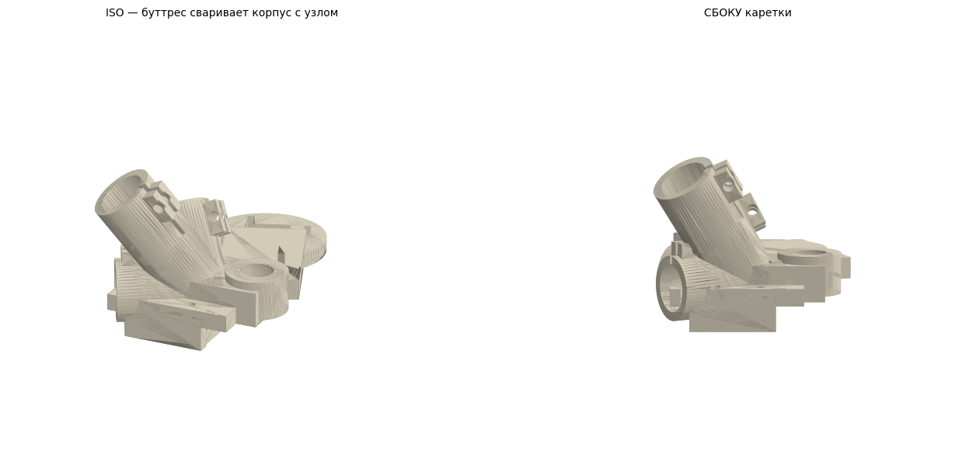
truss/print_queue/motor_kron/_preview.png
