fvyshkov/newton/truss/print_queue/sliced/frame_A.gcode.preview.png

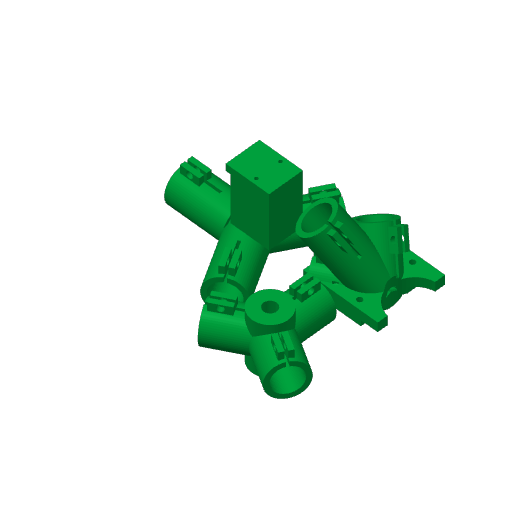
truss/print_queue/sliced/frame_A.gcode.preview.png
