fvyshkov/newton/truss/print_queue/sliced/pinion02_auto.gcode.preview.png

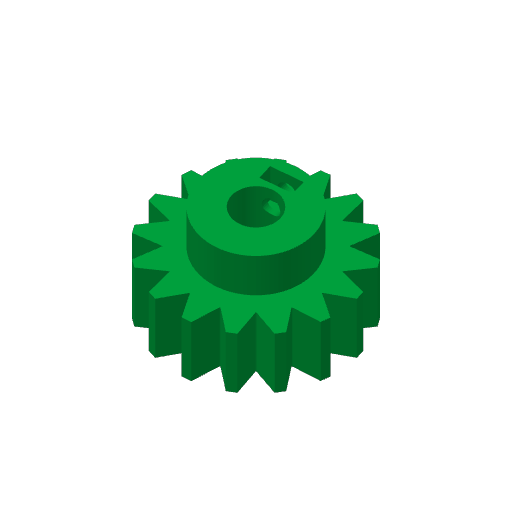
truss/print_queue/sliced/pinion02_auto.gcode.preview.png
