fvyshkov/newton/truss/print_queue/sliced/rama_A.gcode.preview.png

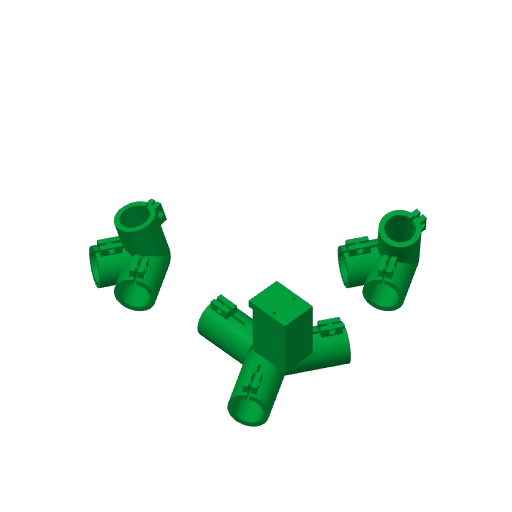
truss/print_queue/sliced/rama_A.gcode.preview.png
