fvyshkov/newton/truss/print_queue/sliced/rama_B.gcode.preview.png

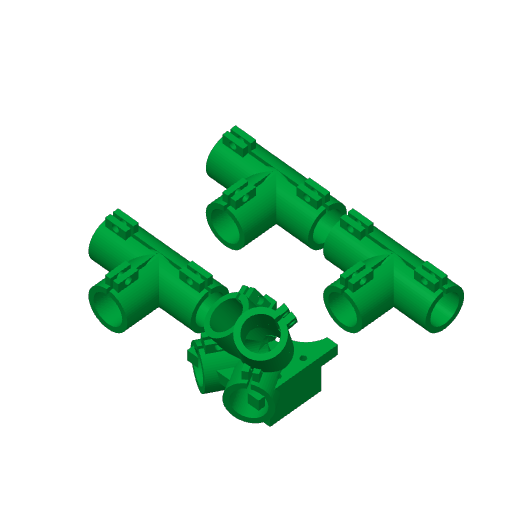
truss/print_queue/sliced/rama_B.gcode.preview.png
