fvyshkov/newton/truss/print_queue/verkhniy_yarus/_BED_LAYOUT.png

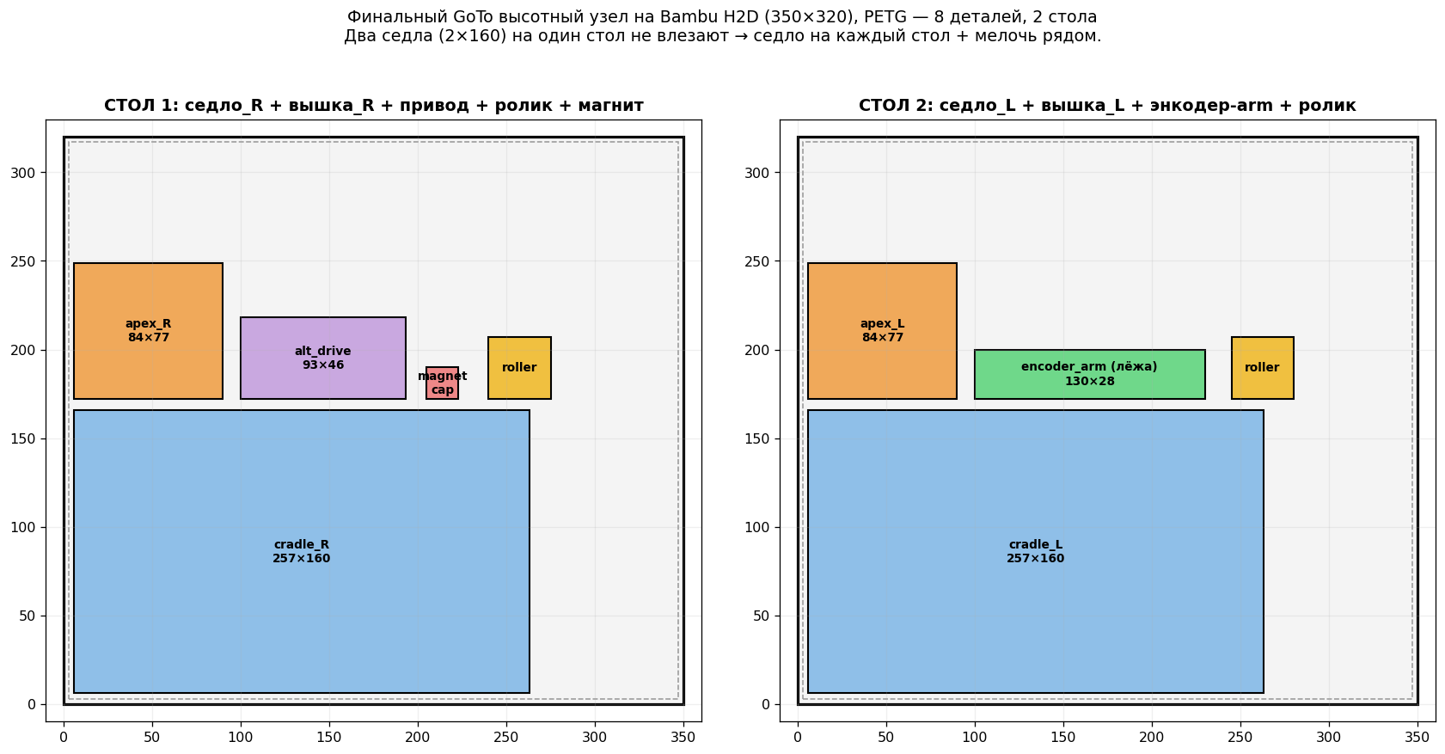
truss/print_queue/verkhniy_yarus/_BED_LAYOUT.png
