fvyshkov/newton/truss/print_queue/verkhniy_yarus/_CRADLE_ORIENT.png

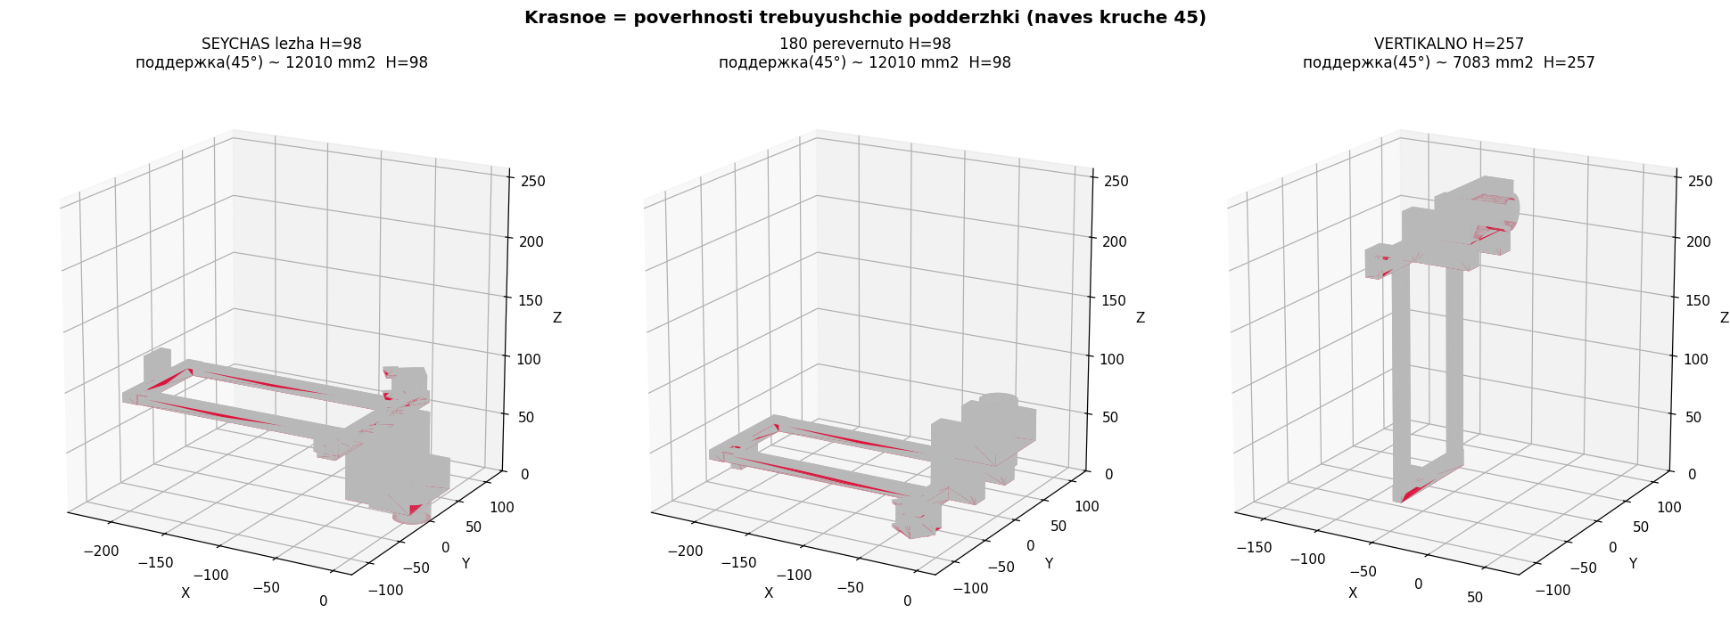
truss/print_queue/verkhniy_yarus/_CRADLE_ORIENT.png
