fvyshkov/newton/truss/print_queue/verkhniy_yarus/_CRADLE_SIDE.png

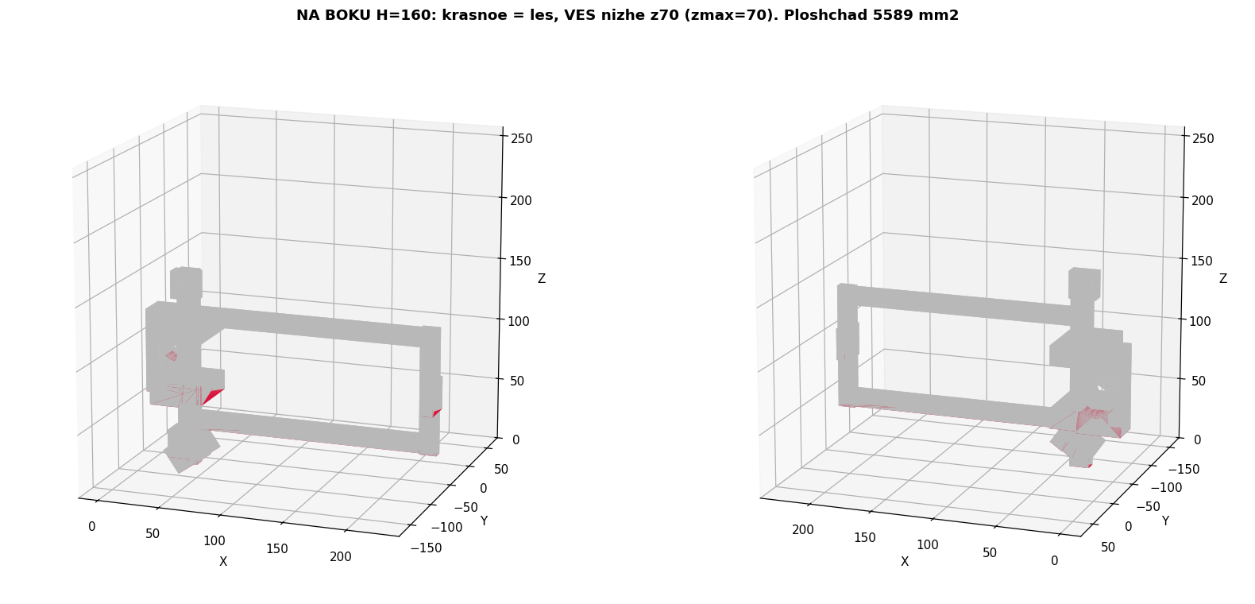
truss/print_queue/verkhniy_yarus/_CRADLE_SIDE.png
