fvyshkov/newton/truss/print_queue/verkhniy_yarus/_CRADLE_VERT.png

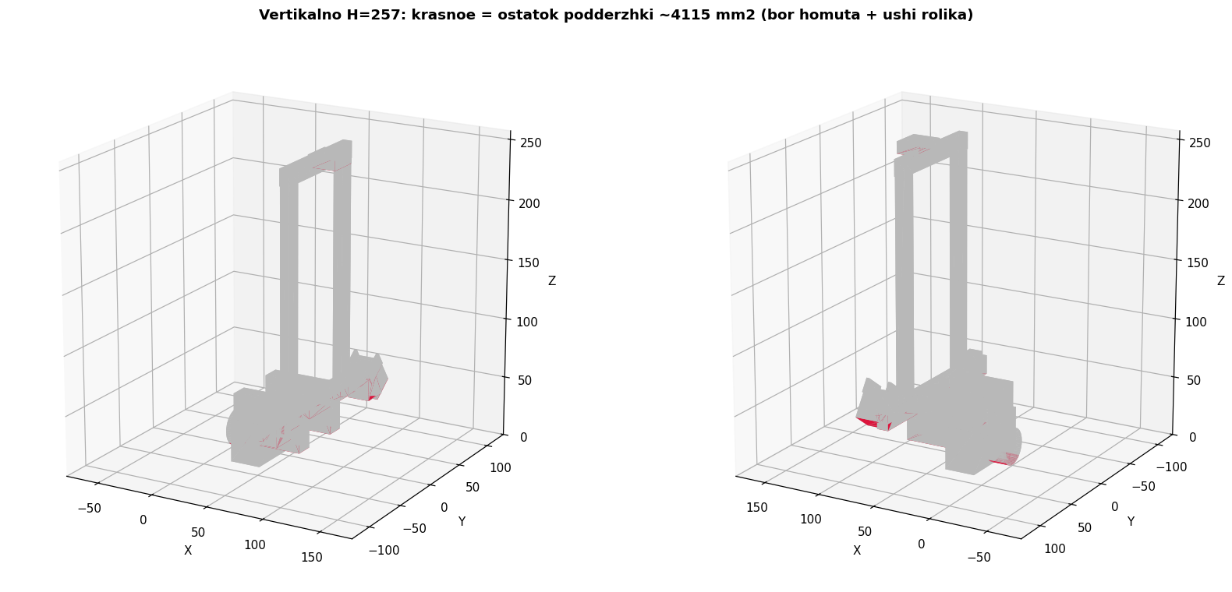
truss/print_queue/verkhniy_yarus/_CRADLE_VERT.png
