fvyshkov/newton/truss/print_queue/verkhniy_yarus/_MECHANISM.png

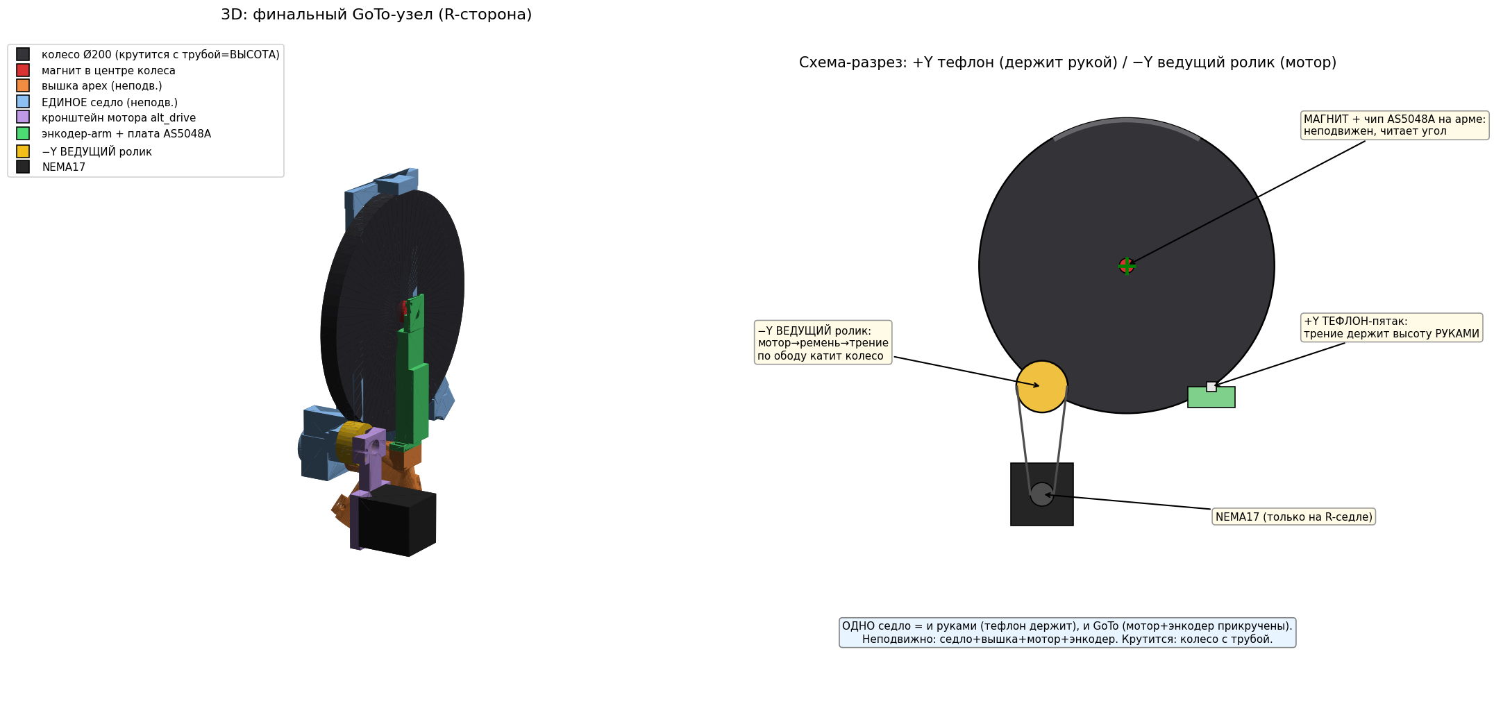
truss/print_queue/verkhniy_yarus/_MECHANISM.png
