fvyshkov/newton/truss/print_queue/verkhniy_yarus/_STOL_ALL_layout.png

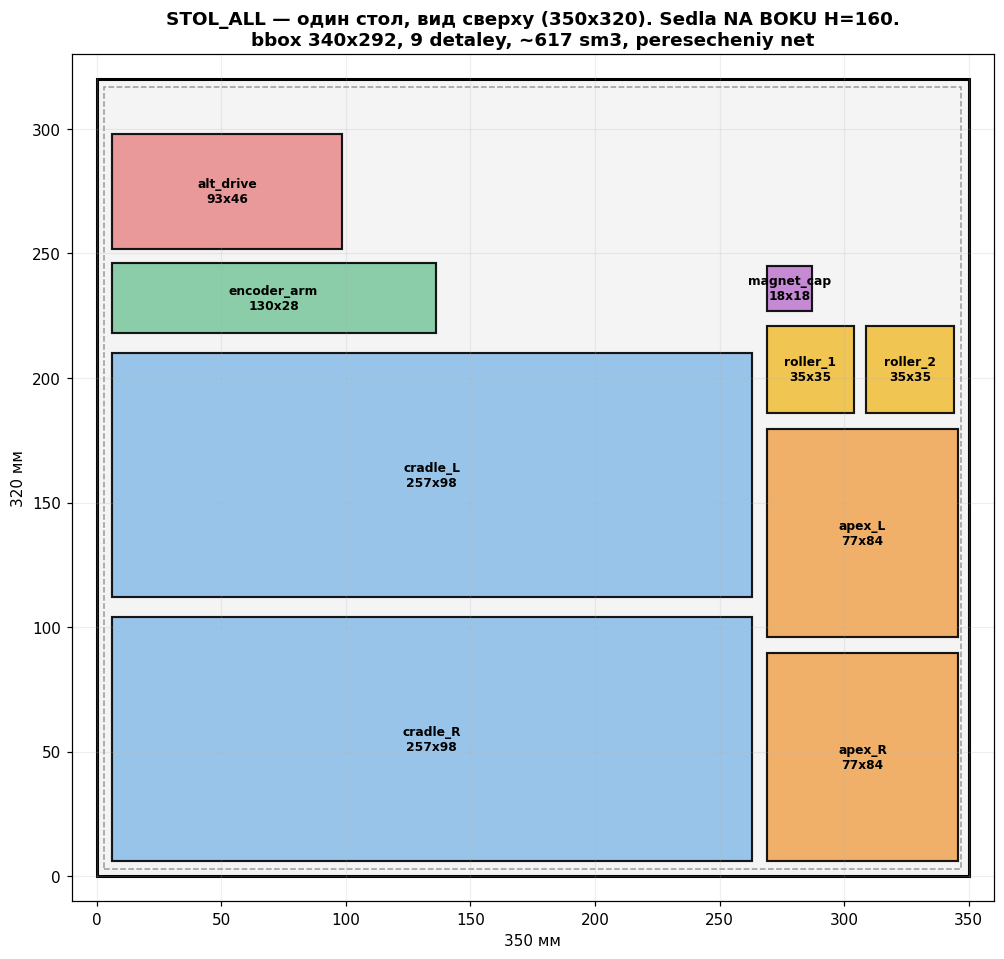
truss/print_queue/verkhniy_yarus/_STOL_ALL_layout.png
