fvyshkov/newton/truss/rocker_assembly_diagram.png

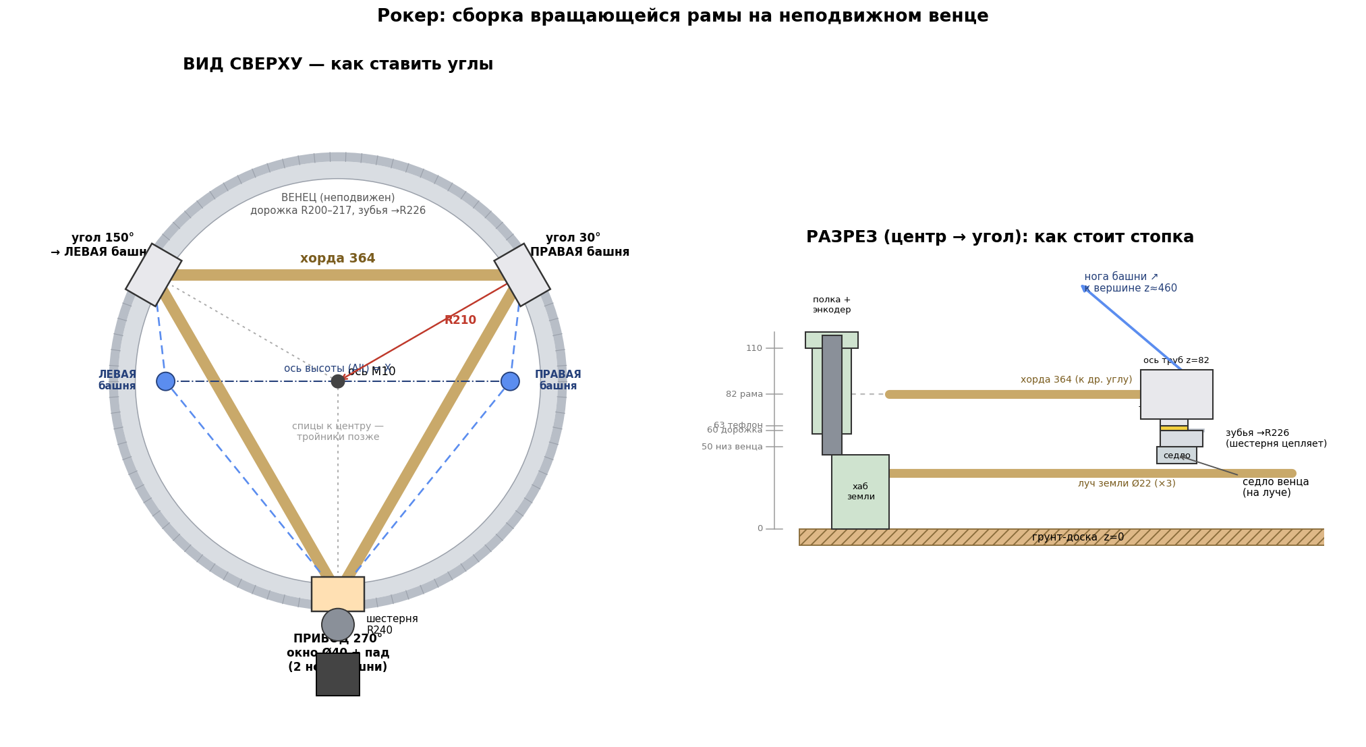
truss/rocker_assembly_diagram.png
