fvyshkov/newton/truss/rocker_new_assembly.png

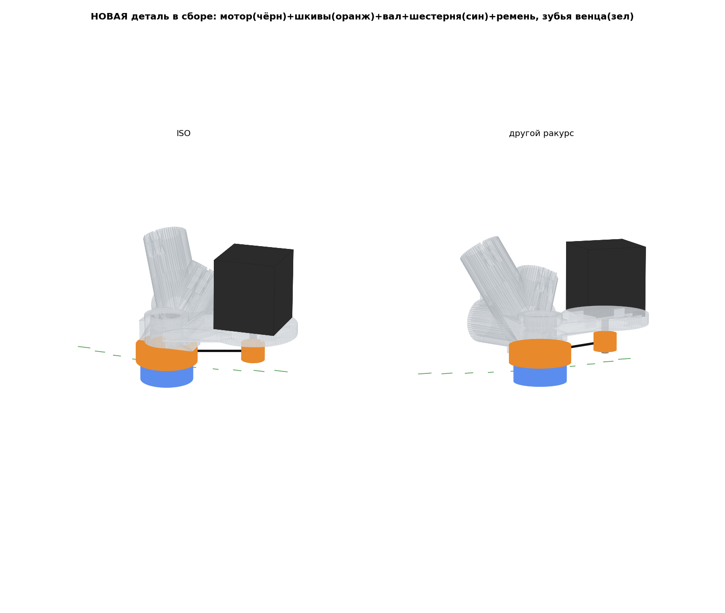
truss/rocker_new_assembly.png
