fvyshkov/newton/truss/tower_assembly.png

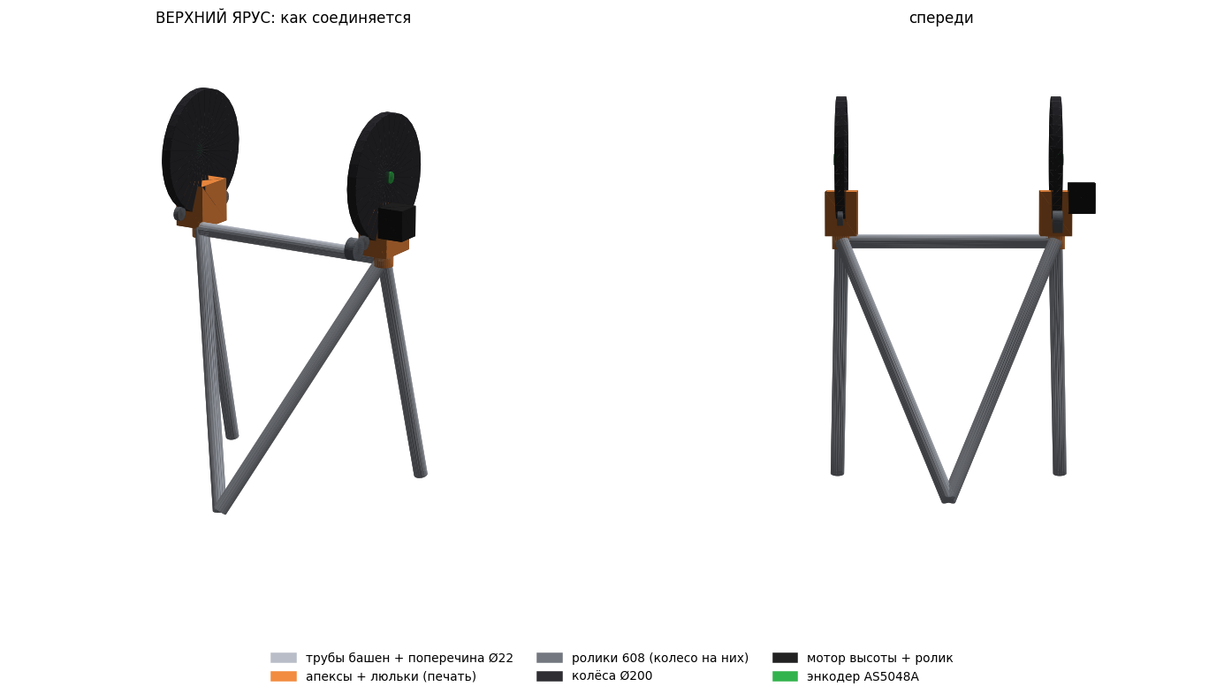
truss/tower_assembly.png
