fvyshkov/newton/truss/generate_rocker_towers.py

#!/usr/bin/env python3
"""
Высотный (ALT) ярус рокера-добсона под колёса Ø200 — вышки, люльки, фрикционный
привод высоты. GoTo, Этап 2. Генерит бинарные STL в truss/stl/ через CSG
(trimesh + manifold3d).

СТИЛЬ УЗЛА (эталон truss/_proto_reference.py): узел = union разрезных хомутов-
цилиндров (tube_clamp.place_clamp) + МИНИМАЛЬНОЕ ядро, которое ровно сваривает их
в одно watertight-тело, + ТОЛЬКО функциональные фичи (оси роликов, привод).
НИКАКИХ косынок/гуссетов, R200-дуг, толстых «шеек», glide-pad'ов, импорта меша.

Мировая система (мм, z=0 = верх нижней доски) берётся ИМПОРТОМ из
gen_rocker_comic (НЕ хардкодим): CORNER_ANGLES, R_CORNER, FRAME_Z, WHEEL_X,
APEX_Z, ALT_AXIS, polar(). Труба = Ø22 алюминий, хомут = чистый разрезной
цилиндр (бор Ø22.4, поперечный болт M5, прорезь). Все сокеты — ЭТОТ ЖЕ хомут.

ПОЗА ПЕЧАТИ (каждая деталь пере-ориентируется в естественную позу, z_min=0):
  • apex — детали СОБИРАЮТСЯ в мировых координатах (чтобы оси труб сходились),
    затем поворачиваются так, что ось cross-хомута ВЕРТИКАЛЬНА (её круглый торец
    ложится на стол): важнейший скользящий бор печатается вертикально, без
    поддержки; две ноги-хомута расходятся вверх-в-стороны.
  • cradle / alt_drive / roller — собираются сразу в локальной ПЕЧАТНОЙ системе
    (локальная +Z = мировая X = ось cross-трубы, ВЕРТИКАЛЬНО): все боры (хомут,
    оси роликов, вал, пилот мотора) идут вдоль +Z → печатаются вертикальными
    отверстиями без поддержек. finish() лишь сажает деталь на стол (z_min=0).

finish(): merge → process → выкидывает паразитные тела (оставляет самое
крупное) → опц. поворот в позу печати → сажает на стол (z_min=0) → экспорт.

Все посадки: M4 clr 4.4, M3 clr 3.4 / саморез 2.7, M5 clr 5.4, M10 clr 10.6,
608 ось Ø8 (+зазор), NEMA17 пилот Ø22.6 + M3 на 31×31.
"""
import math
from pathlib import Path

import numpy as np
import trimesh

import tube_clamp as tc
import gen_rocker_comic as W   # общий мир: константы + polar()

# ============================ ПАРАМЕТРЫ ============================
OUTDIR = Path(__file__).parent / "stl"
ENGINE = "manifold"

# --- Мир (импорт, не хардкод) ---
CORNER_ANGLES = W.CORNER_ANGLES      # (30,150,270)
R_CORNER = W.R_CORNER                # 210
FRAME_Z = W.FRAME_Z                  # 75  (ось нижних труб)
WHEEL_X = W.WHEEL_X                  # 170 (плоскости колёс x=±170)
APEX_Z = W.APEX_Z                    # 530 (вершина вышек / ось cross-трубы)
WHEEL_AXIS_Z = W.ALT_AXIS[2]         # 590 (ось качания колёс)
WHEEL_R = 100.0                      # радиус обода колеса, мм
WHEEL_W = 15.0                       # ширина обода (вдоль X), мм

# --- Хомут (импорт) ---
CLAMP_OD = tc.CLAMP_OD               # ≈30.4 наружный Ø
CLAMP_H = tc.CLAMP_H                 # 46

# --- Посадки ---
M3_CLR, M3_TAP = 3.4, 2.7
M4_CLR = 4.4
M5_CLR = 5.4
BEAR_OD = 22.0                       # 608 наружный
BEAR_ID = 8.0                        # 608 внутренний
BEAR_W = 7.0                         # 608 ширина
BEAR_SEAT = 22.15                    # прессовое гнездо 608
BEAR_SEAT_H = 7.3
NEMA_PILOT = 22.6
NEMA_HOLE = 31.0                     # M3 на 31×31
SHAFT_D = 8.0

# --- Вышки / apex: минимально, как в эталоне (хомуты + ядро-шар) ---
HUB_R = 16.0                         # радиус ядра-шара (ровно сваривает хомуты)
APEX_CLAMP_H = 44.0                  # длина воротника ноги вышки (грип ≥40мм на Ø22)
CROSS_CLAMP_H = 40.0                 # длина воротника cross-хомута
# STAGGER: две ноги apex расходятся всего на ~42° → их боры пересекаются у ядра и
# «палка не влезет» (входной торец одной ноги перекрыт телом другой). Раздвигаем
# ЗАДНЮЮ ногу вдоль её оси на LEG_STAGGER: её воротник (с ушками+болтом) уходит
# наружу, входные торцы двух ног разнесены по оси → каждая труба входит на полный
# грип. Плюс сквозная расточка бора Ø22.4 через ядро (труба садится в ПУСТОЙ бор).
LEG_STAGGER = 22.0                   # вынос заднего воротника вдоль его оси, мм
# --- Тест-посадки трубы (в самом генераторе) ---
TUBE_D = 22.0                        # номинал алюминиевой трубы
GRIP = 40.0                          # требуемая глубина посадки
DRILL_D = 22.4                       # Ø сквозной расточки бора (= бор хомута)
FIT_TOL = 8.0                        # порог теста: <8% объёма трубы = PASS

# --- Ролики люльки (V-опора колеса Ø200) ---
# Колесо лежит в V из двух роликов, контакт по ободу R100 на ±35° от нижней точки.
# Для внешней касательной ролика Ø35 (r17.5) к ободу R100 центр ролика должен стоять
# на r = 100 + 17.5 = 117.5 от оси качания (раньше r=111.2 → ролик врезался в обод на
# 6.3мм). Разложение по ±35°:
ROLL_R = 117.5                       # радиус центра ролика от оси колеса (касание Ø35↔R100)
ROLL_ANG = 35.0                      # угол ролика от нижней точки обода
ROLL_Y = ROLL_R * math.sin(math.radians(ROLL_ANG))   # 67.4  ±y центров роликов
ROLL_DZ = ROLL_R * math.cos(math.radians(ROLL_ANG))  # 96.25 опускание центра под ось колеса
DISC_HALF = WHEEL_W / 2.0 + 1.5      # полузазор от диска колеса, ≈9.0

# --- Фрикц. привод высоты ---
FRIC_R = 17.5                        # фрикц. ролик Ø35
BELT_CD = 58.6                       # межосевое GT2 20T→60T

ICO = 3                              # подразбиение сферы-ядра
SEG = 64


# ============================ ХЕЛПЕРЫ ============================
def tr(x, y, z):
    M = np.eye(4); M[:3, 3] = (x, y, z); return M


def cyl(r, h, T=None, seg=SEG):
    c = trimesh.creation.cylinder(radius=r, height=h, sections=seg)
    if T is not None:
        c.apply_transform(T)
    return c


def box(x, y, z, T=None):
    b = trimesh.creation.box(extents=(x, y, z))
    if T is not None:
        b.apply_transform(T)
    return b


def boxab(x0, x1, y0, y1, z0, z1):
    """Осепараллельный бокс по мин/макс углам (лок. система)."""
    return box(x1 - x0, y1 - y0, z1 - z0,
               T=tr((x0 + x1) / 2.0, (y0 + y1) / 2.0, (z0 + z1) / 2.0))


def rotx(d): return trimesh.transformations.rotation_matrix(math.radians(d), [1, 0, 0])
def roty(d): return trimesh.transformations.rotation_matrix(math.radians(d), [0, 1, 0])
def rotz(d): return trimesh.transformations.rotation_matrix(math.radians(d), [0, 0, 1])


def uni(parts):
    return trimesh.boolean.union(parts, engine=ENGINE)


def dif(a, parts):
    return trimesh.boolean.difference([a] + list(parts), engine=ENGINE)


def mirror_x(mesh):
    m = mesh.copy()
    m.apply_transform(np.diag([-1.0, 1.0, 1.0, 1.0]))
    m.fix_normals()
    return m


def mirror_z(mesh):
    m = mesh.copy()
    m.apply_transform(np.diag([1.0, 1.0, -1.0, 1.0]))
    m.fix_normals()
    return m


def axis_cyl(direction, z0, z1, dia, origin=(0.0, 0.0, 0.0), seg=48):
    """Цилиндр Ø`dia` вдоль `direction`, от параметра z0 до z1 (мм по оси),
    отсчитывая от `origin` (точка на оси при z=0). Для расточки бора и теста."""
    d = np.asarray(direction, float); d /= np.linalg.norm(d)
    o = np.asarray(origin, float)
    L = float(z1 - z0)
    c = trimesh.creation.cylinder(radius=dia / 2.0, height=L, sections=seg)
    T = trimesh.geometry.align_vectors([0, 0, 1], d)
    T[:3, 3] = o + d * (z0 + L / 2.0)
    c.apply_transform(T)
    return c


def drill_bores(body, sockets):
    """Сквозная расточка бора Ø DRILL_D по каждому сокету: от z=−3 (сквозь ядро)
    до входного торца воротника (entry). Гарантирует ПУСТОЙ бор на полный грип —
    труба входит до упора, тело соседа на пути расточено (не мешает)."""
    cuts = [axis_cyl(d, -3.0, entry, DRILL_D, origin=o) for _, o, d, entry in sockets]
    return dif(body, cuts)


def tube_fit_test(body, sockets, name):
    """ТЕСТ ПОСАДКИ: для каждого сокета строим Ø22 цилиндр длиной GRIP от входного
    торца бора ВНУТРЬ; пересекаем с телом узла. Труба должна сидеть в ПУСТОМ боре →
    объём пересечения < FIT_TOL% от объёма трубы = PASS."""
    tvol = math.pi * (TUBE_D / 2.0) ** 2 * GRIP
    all_pass = True
    for label, o, d, entry in sockets:
        t = axis_cyl(d, entry - GRIP, entry, TUBE_D, origin=o)
        inter = trimesh.boolean.intersection([body, t], engine=ENGINE)
        vol = abs(inter.volume) if (inter is not None and len(inter.vertices)) else 0.0
        frac = vol / tvol * 100.0
        ok = frac < FIT_TOL
        all_pass = all_pass and ok
        print(f"    tube-fit {name}:{label:<6} {frac:5.1f}%  {'PASS' if ok else 'FAIL'}")
    return all_pass


def tube_fit(body, origin, tube_dir, clamp_h, name, grip=40.0, tube_d=22.0):
    """ТЕСТ ВСТАВКИ ТРУБЫ. Строит цилиндр Ø22 длиной `grip`(40) ВДОЛЬ оси трубы,
    начиная у ВХОДА бора (наружный торец хомута) и уходя ВНУТРЬ на grip. Труба
    должна сидеть в ПОЛОСТИ бора → пересечение с телом узла < 8% объёма трубы.
    Печатает PASS/FAIL. Проверяется на теле ДО finish() (в его собственной
    системе — тест инвариантен к позе)."""
    d = np.asarray(tube_dir, float); d /= np.linalg.norm(d)
    entry = np.asarray(origin, float) + d * clamp_h      # наружный торец = вход трубы
    center = entry - d * (grip / 2.0)                    # центр пробника
    T = trimesh.geometry.align_vectors([0.0, 0.0, 1.0], d)  # ось цилиндра +Z → d
    T[:3, 3] = center
    probe = cyl(tube_d / 2.0, grip, T=T, seg=48)
    inter = trimesh.boolean.intersection([body, probe], engine=ENGINE)
    vi = abs(inter.volume) if (inter is not None and len(inter.vertices) > 0) else 0.0
    vt = math.pi * (tube_d / 2.0) ** 2 * grip
    ratio = vi / vt
    ok = ratio < 0.08
    print(f"    tube-fit {name}: {'PASS' if ok else 'FAIL'}  "
          f"пересечение={ratio*100:5.1f}% от объёма трубы (порог 8%)")
    return ok


def finish(mesh, name, pose=None):
    """Финализация: сшить, выкинуть паразитные тела (оставить самое крупное),
    опц. повернуть в позу печати (`pose` = 4×4), посадить на стол (z_min=0),
    экспортировать. Эталон: _proto_reference.hub_ground()."""
    OUTDIR.mkdir(parents=True, exist_ok=True)
    # Грубая сварка вершин ДО валидации (тела вращения дают sliver-пары ~5e-7 —
    # process(validate=True) их дырявит); схлопываем в честное ребро (эталон —
    # generate_rocker_frame_truss.finish).
    mesh.merge_vertices(digits_vertex=5)
    mesh.process(validate=True)
    # выкинуть паразитные тела — оставить самое крупное (по объёму)
    bodies = mesh.split(only_watertight=False)
    if len(bodies) > 1:
        mesh = max(bodies, key=lambda m: abs(m.volume))
    if pose is not None:
        mesh.apply_transform(pose)
    mesh.apply_translation([0, 0, -mesh.bounds[0, 2]])   # z_min = 0
    mesh.merge_vertices(digits_vertex=5)
    mesh.process(validate=True)
    if not mesh.is_watertight:
        trimesh.repair.fill_holes(mesh)
        mesh.fix_normals()
    out = OUTDIR / f"{name}.stl"
    mesh.export(out)
    bb = mesh.bounds
    print(f"  {name}.stl  watertight={mesh.is_watertight}  vol={mesh.volume/1000:.2f}cm³  "
          f"bbox={bb[1,0]-bb[0,0]:.0f}×{bb[1,1]-bb[0,1]:.0f}×{bb[1,2]-bb[0,2]:.0f}mm")
    return mesh


def seat_enclosure_test(body, seats, wall=3.0):
    """Проверка ОГРАЖДЕНИЯ круглых гнёзд: для каждого гнезда (x,y,z0,z1,r) строим
    кольцо-щуп [r .. r+wall] на его глубине и пересекаем с телом. Если стенка
    ≥wall кругом — щуп целиком в теле → отношение ≈100% (PASS). Клип кромкой →
    отношение <100% (FAIL). Печатает PASS/FAIL и % заполнения стенки."""
    print("  ТЕСТ ОГРАЖДЕНИЯ ГНЁЗД (кольцо-щуп r..r+3мм; PASS ≥98%):")
    allpass = True
    for nm, x, y, z0, z1, r in seats:
        h = z1 - z0
        outer = cyl(r + wall, h, T=tr(x, y, (z0 + z1) / 2), seg=64)
        inner = cyl(r, h + 2, T=tr(x, y, (z0 + z1) / 2), seg=64)
        ring = dif(outer, [inner])
        v_ring = math.pi * ((r + wall) ** 2 - r ** 2) * h
        try:
            it = trimesh.boolean.intersection([body, ring], engine=ENGINE)
            v_it = abs(it.volume) if it is not None and len(it.faces) else 0.0
        except Exception:
            v_it = float("nan")
        frac = v_it / v_ring
        ok = frac >= 0.98
        allpass = allpass and ok
        print(f"    {nm:16s} стенка {frac*100:5.1f}%  {'PASS' if ok else 'FAIL'}")
    return allpass


# ============================ 1. APEX ВЕРШИНЫ ============================
def _apex_dirs(side):
    """Направления трёх труб ОТ вершины (единичные). side=+1 правый, -1 левый."""
    apex = np.array([side * WHEEL_X, 0.0, APEX_Z])
    a_leg = 30.0 if side > 0 else 150.0          # передний угол этой стороны
    c_leg = np.array(W.polar(R_CORNER, a_leg, FRAME_Z))
    c_rear = np.array(W.polar(R_CORNER, 270.0, FRAME_Z))
    other = np.array([-side * WHEEL_X, 0.0, APEX_Z])
    dirs = {
        "leg": (c_leg - apex),
        "rear": (c_rear - apex),
        "cross": (other - apex),
    }
    lens = {k: float(np.linalg.norm(v)) for k, v in dirs.items()}
    dirs = {k: v / lens[k] for k, v in dirs.items()}
    return apex, dirs, lens


def _apex_slit(key, d):
    """Прорезь воротника — в СВОБОДНОЕ пространство:
      • cross (труба горизонтальна) → прорезь строго ВВЕРХ (+Z);
      • нога (труба крутая, вниз)   → прорезь по горизонт. радиусу НАРУЖУ.
    """
    if key == "cross":
        return np.array([0.0, 0.0, 1.0])
    h = np.array([d[0], d[1], 0.0])
    return h / np.linalg.norm(h)


# --- Площадка энкодера высоты на R-вышке (интерфейс к build123d-arm'у) ---
# Плоская бонка СНАРУЖИ диска (мир x 174..188, z 458..474 — ниже обода z490, чистая
# по y=0: ролики люльки на y=±67). Верх плоский на мир z=474; 2×M4 самонарез вниз.
# Энкодер-arm (build123d, отдельный STEP) садится сюда, слоты дают регулировку зазора.
ENC_PAD_TOP_Z = 14.0        # верх площадки в build-кадре (мир 460+14=474)
ENC_PAD = dict(cx=11.0, y_half=14.0, x_half=7.0, z0=-2.0)   # мир x[174,188]
ENC_BOLT_DY = 10.0          # разнос 2×M4 по Y
ENC_TAP = 3.5               # Ø самонарез M4 в PETG


def rocker_tower_apex(side=+1, name="Rocker_tower_apex_R", enc_pad=False):
    """Вершина: 3 хомута-цилиндра из общего центра + ядро-шар. Прорези: cross
    ВВЕРХ, две ноги — радиально наружу. STAGGER: две ноги всего ~42° апарт → их
    боры пересекались и «палка не влезала». ЗАДНЮЮ ногу выносим вдоль её оси на
    LEG_STAGGER (её воротник+ушки уходят наружу; входные торцы двух ног разнесены
    по оси), а гэп от ядра до вынесенного воротника заполняем струтом-цилиндром.
    Затем СКВОЗНАЯ расточка всех трёх боров Ø22.4 через ядро → каждая труба входит
    в ПУСТОЙ бор на полный грип (tube-fit PASS). Собирается с вершиной в НАЧАЛЕ
    координат; печатная поза — ось cross-хомута вертикально. L = зеркало R по X.
    enc_pad=True (только R): добавляет плоскую площадку 2×M4 СНАРУЖИ диска под
    энкодер-arm высотной оси (см. generate_alt_encoder_arm.py, build123d)."""
    _, dirs, _ = _apex_dirs(side)
    # сокеты: (label, origin, dir, entry) — entry = вынос входного торца по оси
    offs = {"cross": 0.0, "leg": 0.0, "rear": LEG_STAGGER}
    hgt = {"cross": CROSS_CLAMP_H, "leg": APEX_CLAMP_H, "rear": APEX_CLAMP_H}
    parts = [trimesh.creation.icosphere(subdivisions=ICO, radius=HUB_R)]
    sockets = []
    for key, d in dirs.items():
        slit = _apex_slit(key, d)
        off, h = offs[key], hgt[key]
        origin = d * off
        parts.append(tc.place_clamp(h, tuple(origin), tube_dir=d, slit_dir=slit))
        if off > 0.5:   # струт ядро→вынесенный воротник (сваривает, потом расточится)
            parts.append(axis_cyl(d, -8.0, off + 8.0, CLAMP_OD, seg=SEG))
        sockets.append((key, np.zeros(3), d, off + h))
    if enc_pad:
        p = ENC_PAD
        parts.append(boxab(p["cx"] - p["x_half"], p["cx"] + p["x_half"],
                           -p["y_half"], p["y_half"], p["z0"], ENC_PAD_TOP_Z))
    part = uni(parts)
    part = drill_bores(part, sockets)          # сквозной пустой бор на каждый сокет
    ok = tube_fit_test(part, sockets, name)
    assert ok, f"{name}: tube-fit FAIL — палка не влезет"
    if enc_pad:                                # 2×M4 самонарез сверху вниз в площадку
        taps = [cyl(ENC_TAP / 2, ENC_PAD_TOP_Z - ENC_PAD["z0"],
                    T=tr(ENC_PAD["cx"], sy * ENC_BOLT_DY,
                         (ENC_PAD_TOP_Z + ENC_PAD["z0"]) / 2), seg=24)
                for sy in (+1, -1)]
        part = dif(part, taps)
    # ПОЗА ПЕЧАТИ: ось cross-хомута → вертикаль (её бор печатается без поддержки)
    pose = trimesh.geometry.align_vectors(dirs["cross"], [0.0, 0.0, 1.0])
    return finish(part, name, pose=pose)


# ============================ 2. ЛЮЛЬКА (CRADLE) ============================
# Локальная ПЕЧАТНАЯ система: +Z_l = мировая +X (ось cross-трубы, ВЕРТИКАЛЬНО),
#   +X_l = мировая −Z (мировой «низ» → к роликам/ободу),  +Y_l = мировая +Y.
# Ключевые локальные точки (0 = центр бора хомута на cross-трубе):
#   ось колеса (-60,0,0); диск R100 толщиной z∈[-7.5,7.5];
#   ролики (rcx=31.1, ±63.7, 0), оси по +Z_l;  обод BDC (+40,0,0), TDC (-160,0,0).
def _cradle_locals():
    """Локальные координаты люльки/привода из МИРА (печатная система:
    +Z_l=мир X, +X_l=мир −Z, +Y_l=мир Y; ориг = центр бора cross-трубы у мир
    (WHEEL_X,0,APEX_Z)). Пересчёт: world_z = APEX_Z − x_l; world_x = WHEEL_X + z_l."""
    rx = WHEEL_AXIS_Z - APEX_Z                       # 130  ось колеса над cross-трубой
    roll_xl = ROLL_DZ - rx                           # −33.75  x_l центров роликов (ВЫШЕ трубы)
    bdc_xl = APEX_Z - (WHEEL_AXIS_Z - WHEEL_R)       # −30  низ обода (BDC)
    tdc_xl = APEX_Z - (WHEEL_AXIS_Z + WHEEL_R)       # −230 верх обода (TDC)
    fric_zw = WHEEL_AXIS_Z - WHEEL_R - FRIC_R        # 472.5  мир z центра фрикц. ролика (под BDC)
    return rx, roll_xl, bdc_xl, tdc_xl, fric_zw


def rocker_cradle(side=+1, name="Rocker_cradle_R"):
    """Люлька-опора колеса Ø200. Cross-труба лежит НИЖЕ обода (APEX_Z=460, обод-низ
    490), поэтому люлька ПОДНИМАЕТ ролики от трубы ВВЕРХ к ободу:
      • ОДИН хомут на cross-трубе, смещён ВНУТРЬ (к центру) на ~60мм, чтобы разойтись
        с apex-узлом на конце трубы (прорезь ВВЕРХ, скользит+зажимает);
      • «седло» над хомутом + два веба ПО БОКАМ (y>15) — обходят cross-воротник apex;
      • бэкбон вдоль Y во ВНУТРЕННЕЙ плоскости (z_l≈−12, мир x≈158, мимо диска);
      • ДВЕ вилки роликов 608 (оси Ø8 вдоль +Z_l) на ±ROLL_Y (=±67.4), r=117.5 от оси
        колеса → внешняя касательная к ободу;
      • палец-антиподъём: 2 рельса (мимо диска) + перемычка + накладка над TDC (1мм).
    Всё несущее тело — при z_l≤−8 (внутрь от диска z_l∈[−7.5,7.5]); наружу от диска
    торчат только оси роликов. Бор cross-трубы ПЕРЕ-СВЕРЛИВАется. L = зеркало (mirror_z)."""
    rx, roll_xl, bdc_xl, tdc_xl, fric_zw = _cradle_locals()
    ch = 40.0
    UP = np.array([-1.0, 0.0, 0.0])       # прорезь ВВЕРХ (лок. −X_l = мир. +Z)
    ZL = np.array([0.0, 0.0, 1.0])        # ось бора = ось cross-трубы (+Z_l = мир X)
    Z_IN = -12.0                          # несущая плоскость ВНУТРИ от диска (мир x≈158)

    # хомут смещён ВНУТРЬ вдоль трубы: наружный (входной) торец на z_l=−46 (мир x=124),
    # 6мм зазор до apex cross-воротника (мир x 130..170). Болт-на-входе (у z_l=−46).
    clamp_out = -46.0
    C_ORIG = (0.0, 0.0, clamp_out - ch)   # бор z_l −86..−46 (мир x 84..124)
    parts = [tc.place_clamp(ch, C_ORIG, tube_dir=ZL, slit_dir=UP)]

    # --- СЕДЛО над хомутом (сваривает верх воротника с двумя вебами), ВНУТРИ (мир x<130) ---
    parts.append(boxab(-20, 16, -34, 34, -70, -44))        # x_l −20..16, y±34, z_l −70..−44

    # --- ДВА ВЕБА по бокам (y 17..33): обходят cross-воротник apex (y±15.2) сбоку; НЕ
    #     опускаются ниже z_l=−2 (мир z462), чтобы не задеть НОГИ-воротники apex, что
    #     веером расходятся по ±y ниже вершины (z<460) ---
    for sy in (+1, -1):
        parts.append(boxab(roll_xl - 8, -2, sy * 25 - 8, sy * 25 + 8, -68, -8))

    # --- БЭКБОН вдоль Y во внутренней плоскости (мимо диска), несёт вилки роликов ---
    parts.append(boxab(roll_xl - 8, roll_xl + 8, -(ROLL_Y + 11), ROLL_Y + 11, -18, -8))

    # --- ВИЛКИ роликов 608 на ±ROLL_Y (вне диска по y): 2 уха straddle диск + ось Ø8 +Z_l ---
    #   −Y ролик — ВЕДУЩИЙ (фрикц.): его ось выходит наружу под шкив, к нему болтится
    #   привод. Наружное ухо −Y расширено под 2×M4 бонки привода (по бокам оси).
    roller_bores = []
    for sy in (+1, -1):
        yc = sy * ROLL_Y
        parts.append(boxab(roll_xl - 11, roll_xl + 11, yc - 11, yc + 11, -14, -2))   # ухо (внутр.)
        ear_w = 17 if sy < 0 else 11                                                  # −Y ухо шире (бонки M4)
        parts.append(boxab(roll_xl - 11, roll_xl + 11, yc - ear_w, yc + ear_w, 2, 14))  # ухо (наруж.)
        roller_bores.append(cyl(SHAFT_D / 2 + 0.1, 44, T=tr(roll_xl, yc, 5), seg=32))    # ось Ø8 (выход наружу)

    # --- ПАЛЕЦ-АНТИПОДЪЁМ над TDC: 2 рельса (y±42, мимо диска) + перемычка + накладка ---
    for sy in (+1, -1):
        parts.append(boxab(tdc_xl - 8, roll_xl + 4, sy * 42 - 7, sy * 42 + 7, Z_IN - 4, Z_IN + 4))
    parts.append(boxab(tdc_xl - 8, tdc_xl + 6, -50, 50, Z_IN - 4, Z_IN + 4))         # перемычка у TDC
    parts.append(boxab(tdc_xl - 11, tdc_xl - 1, -13, 13,
                       -(DISC_HALF + 3), DISC_HALF + 3))                              # накладка над ободом (1мм)

    body = uni(parts)

    # --- боры/крепёж ---
    cuts = list(roller_bores)
    cuts.append(cyl(tc.BORE / 2, 100, T=tr(0, 0, -42), seg=48))    # ПЕРЕ-СВЕРЛИТЬ бор cross Ø22.4 (z_l −92..8)
    for sy in (+1, -1):   # 2×M4 в наружном −Y ухе, по бокам ведущей оси — под лапу привода
        cuts.append(cyl(M4_CLR / 2, 16, T=tr(roll_xl, -ROLL_Y + sy * 13.5, 8), seg=20))
    body = dif(body, cuts)

    # --- ТЕСТ ВСТАВКИ cross-трубы (на теле до mirror/finish, инвариантно к позе) ---
    tube_fit(body, C_ORIG, ZL, ch, name)

    if side < 0:          # L = зеркало по оси трубы (прорезь остаётся ВВЕРХ)
        body = mirror_z(body)
    return finish(body, name)


# ==================== 2b. РУЧНАЯ ЛЮЛЬКА НА ТЕФЛОНЕ (без роликов/мотора) ====================
def rocker_cradle_manual(side=+1, name="Rocker_cradle_R"):
    """ЕДИНОЕ седло колеса Ø200 (работает и руками, и под GoTo). Опора-V:
      • +Y — ТЕФЛОН-пятак (касателен ободу R100 на +35°): трение держит любую
        высоту РУКАМИ (классический доб), карман PTFE 16×18 врезка 2 мм, губки;
      • −Y — ВЕДУЩИЙ фрикц-ролик Ø35 на валу Ø8 (вилка, наруж. ухо = посадка
        привода 2×M4): в ручном свободно крутится (опора), в GoTo его вращает
        NEMA17 (Rocker_alt_drive) → трением катит колесо = высота.
    Апгрейд ручной→GoTo без смены седла: прикрутить alt_drive + ролик + магнит
    в центр колеса + энкодер-arm на вышку. Хомут/седло/вебы/бэкбон/антиподъём —
    от базовой люльки. L = зеркало (mirror_z)."""
    rx, roll_xl, bdc_xl, tdc_xl, fric_zw = _cradle_locals()
    ch = 40.0
    UP = np.array([-1.0, 0.0, 0.0]); ZL = np.array([0.0, 0.0, 1.0]); Z_IN = -12.0
    clamp_out = -46.0
    C_ORIG = (0.0, 0.0, clamp_out - ch)
    parts = [tc.place_clamp(ch, C_ORIG, tube_dir=ZL, slit_dir=UP)]
    parts.append(boxab(-20, 16, -34, 34, -70, -44))                       # седло
    for sy in (+1, -1):
        parts.append(boxab(roll_xl - 8, -2, sy * 25 - 8, sy * 25 + 8, -68, -8))   # вебы
    parts.append(boxab(roll_xl - 8, roll_xl + 8, -(ROLL_Y + 11), ROLL_Y + 11, -18, -8))  # бэкбон (z_l<диска)

    # --- ОПОРА: +Y ТЕФЛОН-ПЯТАК (держит высоту руками), −Y ВЕДУЩИЙ ФРИКЦ-РОЛИК (привод GoTo) ---
    axis_xl = bdc_xl - WHEEL_R                       # −130  ось колеса (x_l)
    rad = math.radians(ROLL_ANG)                     # 35°
    pockets = []
    roller_bores = []
    # +Y: тефлон-пятак, касательный к ободу R100 на +35° (трение держит трубу рукой)
    cyy = WHEEL_R * math.sin(rad)                    # +57.4
    rvec = np.array([math.cos(rad), math.sin(rad), 0.0])
    contact = np.array([axis_xl + WHEEL_R * math.cos(rad), cyy, 0.0])
    Rp = rotz(ROLL_ANG)
    pad = box(26, 22, 20, T=Rp); pad.apply_translation(contact + rvec * 13.0)
    parts.append(pad)
    parts.append(boxab(roll_xl - 9, roll_xl + 9, 57 - 11, 57 + 11, -8, 11))       # струт пятак↔бэкбон
    for sz in (+1, -1):                              # губки осевого удержания обода
        lip = box(12, 22, 2.5, T=Rp)
        lip.apply_translation(contact - rvec * 1.0 + np.array([0.0, 0.0, sz * 10.0]))
        parts.append(lip)
    pk = box(3.0, 16, 18, T=Rp); pk.apply_translation(contact + rvec * 0.5)       # карман PTFE (врезка 2мм)
    pockets.append(pk)
    # −Y: ВЕДУЩИЙ фрикц-ролик Ø35 (вилка 608/вал Ø8 вдоль +Z_l; в ручном свободен, в GoTo — от мотора)
    yc = -ROLL_Y
    parts.append(boxab(roll_xl - 11, roll_xl + 11, yc - 11, yc + 11, -14, -2))    # внутр. ухо
    parts.append(boxab(roll_xl - 11, roll_xl + 11, yc - 17, yc + 17, 2, 14))      # наруж. ухо (=посадка привода 2×M4)
    roller_bores.append(cyl(SHAFT_D / 2 + 0.1, 44, T=tr(roll_xl, yc, 5), seg=32))

    # --- АНТИПОДЪЁМ над TDC (как у роликовой) ---
    for sy in (+1, -1):
        parts.append(boxab(tdc_xl - 8, roll_xl + 4, sy * 42 - 7, sy * 42 + 7, Z_IN - 4, Z_IN + 4))
    parts.append(boxab(tdc_xl - 8, tdc_xl + 6, -50, 50, Z_IN - 4, Z_IN + 4))
    parts.append(boxab(tdc_xl - 11, tdc_xl - 1, -13, 13, -(DISC_HALF + 3), DISC_HALF + 3))

    body = uni(parts)
    cuts = [cyl(tc.BORE / 2, 100, T=tr(0, 0, -42), seg=48)] + pockets + roller_bores  # бор cross + PTFE + ось ролика
    for sy in (+1, -1):   # 2×M4 посадки привода (GoTo) в наружном −Y ухе
        cuts.append(cyl(M4_CLR / 2, 18, T=tr(roll_xl, -ROLL_Y + sy * 13.5, 8), seg=20))
    body = dif(body, cuts)
    tube_fit(body, C_ORIG, ZL, ch, name)
    if side < 0:
        body = mirror_z(body)
    return finish(body, name)


# ============================ 3. ФРИКЦ. ПРИВОД ВЫСОТЫ ============================
# Та же локальная система (+Z_l = мировая X). Обод BDC = локально (+40,0,0);
# центр фрикц. ролика опущен на FRIC_R «вниз» (мир. −Z = лок. +X) → (+40+R,0,0).
def rocker_alt_drive(name="Rocker_alt_drive"):
    """Привод высоты — ПЛОСКИЙ КРОНШТЕЙН NEMA17, целиком СНАРУЖИ колеса (мир x>184).
    cross-труба/apex теперь ПОД ободом (APEX_Z=460), поэтому фрикц. ролик у BDC/apex
    неизбежно лез бы в apex-узел. Решение: ВЕДУЩИМ сделан сам −Y опорный ролик люльки
    (фрикц. по ободу), а этот узел — только кронштейн мотора:
      • лапа-нахлёст на наружное −Y ухо люльки (2×M4);
      • плечо + площадка NEMA17 на межосевом GT2 (CD 58.6), ремень крутит ведущий
        ролик → колесо катится.
    Весь узел снаружи диска (x>184) → пересечений нет (кроме нахлёста лапы на люльку).
    Все боры вертикальны (лок. +Z_l), лок. система = как у люльки
    (ставится тем же roty(90)+tr(WHEEL_X,0,APEX_Z))."""
    rx, roll_xl, bdc_xl, tdc_xl, fric_zw = _cradle_locals()
    ry = -ROLL_Y                          # −67.4  ось ВЕДУЩЕГО (−Y) опорного ролика
    mx = roll_xl + BELT_CD                 # 24.85  x_l оси NEMA (CD 58.6 GT2 вдоль +x_l = мир вниз)
    zt = 24.0                              # верх плиты кронштейна (z_l), СНАРУЖИ колеса

    parts = []
    # лапа-нахлёст на наружное −Y ухо люльки (болты 2×M4), СНАРУЖИ колеса (мир x>184)
    parts.append(boxab(roll_xl - 11, roll_xl + 11, ry - 16, ry + 16, 12, zt))
    # плечо к площадке мотора (вдоль x_l)
    parts.append(boxab(roll_xl - 8, mx + 8, ry - 9, ry + 9, 14, zt))
    # площадка NEMA17 46×46 (центр = ось NEMA)
    parts.append(boxab(mx - 23, mx + 23, ry - 23, ry + 23, 14, zt))

    body = uni(parts)

    cuts = []
    cuts.append(cyl(6.0, 30, T=tr(roll_xl, ry, 16), seg=32))               # зазор Ø12 под ось+шкив ведущего ролика
    for sy in (+1, -1):                                                    # 2×M4 к −Y уху люльки
        cuts.append(cyl(M4_CLR / 2, 20, T=tr(roll_xl, ry + sy * 13.5, 16), seg=20))
    cuts.append(cyl(NEMA_PILOT / 2, 20, T=tr(mx, ry, 16), seg=48))         # пилот NEMA17
    for sx in (+1, -1):
        for sy in (+1, -1):
            cuts.append(cyl(M3_CLR / 2, 20, T=tr(mx + sx * NEMA_HOLE / 2,
                                                 ry + sy * NEMA_HOLE / 2, 16), seg=20))
    body = dif(body, cuts)

    seats = [("NEMA пилот", mx, ry, 14, zt, NEMA_PILOT / 2)]
    seat_enclosure_test(body, seats)
    return finish(body, name)


def rocker_alt_roller(name="Rocker_alt_roller"):
    """Фрикц. ролик Ø35 с проточкой под O-ring, бор Ø8 под вал, M3-фиксатор.
    Печатается как есть — ось бора вертикальна."""
    r = FRIC_R
    body = cyl(r, 16, T=tr(0, 0, 8))
    groove = trimesh.creation.torus(major_radius=r, minor_radius=2.2,
                                    major_sections=48, minor_sections=16)
    groove.apply_translation([0, 0, 8])
    body = dif(body, [groove,
                      cyl((SHAFT_D + 0.4) / 2, 20, T=tr(0, 0, 8), seg=32),
                      cyl(M3_TAP / 2, r, T=tr(r / 2, 0, 8) @ roty(90), seg=16)])
    return finish(body, name)


# ============================ MAIN ============================
def main():
    print("Генерация ALT-яруса рокера (вышки/люльки/привод высоты)…")
    _, _, lensR = _apex_dirs(+1)
    print(f"  длины труб (из координат): нога(перед)→apex {lensR['leg']:.1f}мм, "
          f"нога(зад,270°)→apex {lensR['rear']:.1f}мм, cross {2*WHEEL_X:.1f}мм")
    print(f"  хомут: бор Ø{tc.BORE_D}, воротник Ø{CLAMP_OD}мм — переиспользован во всех сокетах")
    rocker_tower_apex(+1, "Rocker_tower_apex_R", enc_pad=True)   # +площадка энкодера
    rocker_tower_apex(-1, "Rocker_tower_apex_L")
    rocker_cradle_manual(+1, "Rocker_cradle_R")   # ЕДИНОЕ седло: +Y тефлон / −Y ведущий ролик
    rocker_cradle_manual(-1, "Rocker_cradle_L")
    rocker_alt_drive("Rocker_alt_drive")
    rocker_alt_roller("Rocker_alt_roller")
    print(f"\nГотово → {OUTDIR}")


if __name__ == "__main__":
    main()
