fvyshkov/newton/(commit log)

2026-05-13 Initial commit: 8" f/5.9 Newtonian Dobsonian build
    Assembly guide, shopping list, order drafts, reference images, and STL files for printed parts (focuser, spider, secondary holder, eyepiece adapter).
    [1.25 eyepiece adapter.stl, Collet nut.stl, Collet.stl, Focuser grub screw panel.stl, Focuser grub.stl, Focuser inner.stl, Focuser outer bottom.stl, Focuser outer top.stl]
2026-05-14 Add A4 plywood cut sheet for telescope build
    One-page reference with all 11 plywood parts (mirror cell, cradle,
    side bearings, rocker box, ground board) with dimensions and hole
    positions — print and mark plywood directly from this.
2026-05-14 Fix Y-plate: add missing 6 push/pull holes; align with front plate
    - Front plate: rotate push/pull positions to align with Y ears
    (top/lower-right/lower-left); translate labels to Russian
    (нажимных/прижимных)
    - Y-plate: redraw as union of 3 overlapping ear circles
    (R=75 at distance 50 from origin, tips reach Ø250 envelope) so
    all 6 push/pull holes (3×R=95 + 3×R=80) fit inside the body
    - Add the 6 through-holes on Y-plate matching front plate
    - Move ear-tip screw holes from R=110 to R=115 (closer to tips)
2026-05-15 Rebuild chertyozh from Stellafane authoritative sources
    Previous chertyozh had multiple errors that were not verified against
    real Stellafane plans. This rewrite uses Python generator with all
    dimensions computed from documented Stellafane formulas:
    - Bearings: 1 disk Ø380 halved → 2 semicircles (was: 2× Ø200 disks
    which violate Stellafane's 1.2-1.8 × tube_OD rule for bearings)
    - Rocker bottom: circle Ø380 (was: square 350×350)
    - Ground board: circle Ø400 (was: square 400×400)
    - Side wall cutout: now correctly cuts DOWN into the wall
    (was: arc bulged outward due to inverted SVG sweep flag)
    - Y-plate: now has the 6 push/pull through-holes that match the
    front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
2026-05-15 Drop compromises — full Stellafane sizing for plywood cuts
    User has plywood sheet > 2m, so no need to shrink rocker and ground
    board to fit small sheets. Bumped everything to Stellafane
    recommended values:
    - Bearing disk: Ø380 → Ø440 (= 1.7 × tube_OD, Kriege & Berry)
    - Rocker side wall: 310×380 → 310×600 (= balance_point + 70mm)
    - Rocker front: 350×350 → 350×500
    - Rocker bottom: Ø380 → Ø470 (round-up of footprint diagonal)
    - Ground board: Ø400 → Ø500 (rocker bottom + 30mm)
    - PTFE pads now at R=205 (was 150), feet at R=220 (was 170)
    Drawing scale dropped from 1:8 to 1:10 to keep everything on one A4.
    Total plywood needed ≈ 1.5 m², fits on one 1500×1500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
2026-05-15 Add focuser saddle (curved tube interface) + kids assembly guide
    - gen_focuser_saddle.py — parametric generator for the saddle that bridges
    the flat focuser base (101×90mm) and the curved sonotube OD (258mm).
    Cylindrical concave bottom, ~8mm gap compensation at corners.
    - stl/Focuser saddle.stl — generated output (12th printed part).
    - focuser_assembly_kids.md/.pdf — child-friendly step-by-step for assembling
    the 9 focuser parts on the table, plus a note about the saddle for the
    later tube-mounting step.
    - stl/README.md — updated part count (11→12) and added saddle print profile.
    - .gitignore — exclude macOS .DS_Store junk.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
    [Focuser saddle.stl]
2026-05-15 Fix saddle mesh: rewrite generator using CSG (trimesh + manifold3d)
    The hand-rolled grid generator produced jagged hole edges and non-manifold
    seams between the rectangular grid and the cylindrical hole walls — slicers
    flagged open edges, and the curved cuts looked stair-stepped in Preview.
    New approach: build the saddle as boolean difference of primitives:
    rect_block − tube_cylinder − light_hole_cylinder − 4×bolt_cylinders
    All cylinders use 96 segments for smooth circles.
    Result: watertight mesh, 0 non-manifold edges, 1260 triangles (16× smaller
    than the broken grid mesh), Euler χ=-8 confirms correct topology
    (rect + 5 through-holes).
    Dimensions unchanged: 101×90mm footprin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
    [Focuser saddle.stl]
2026-05-15 Smooth saddle hole edges + rewrite focuser doc for competent reader
    Saddle generator:
    - Bump tube cylinder tessellation to 1024 segments (was 256) — chord step
    on the curved bottom is now 0.8mm, below 0.4mm nozzle / 0.2mm layer.
    Hole-edge "stairs" visible in Preview should disappear.
    - Bump small-hole cylinders to 128 segments (was 96).
    - Mesh: 2444 triangles, watertight, 0 non-manifold edges.
    Focuser assembly doc:
    - Rename focuser_assembly_kids.md → focuser_assembly.md (the reader is 13
    and understands 3D printing better than the dad).
    - Drop patronizing tone ("не паникуй", "молодец", "это сложно для взрослых").
    - Drop "папа will drill" —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
    [Focuser saddle.stl]
2026-05-15 Add IKEA-style visual comic for focuser assembly
    focuser_assembly_comic.pdf — 9 pages, text-free (just step numbers + 3D
    renders + arrows) so it works as a pure visual reference:
    page 1: 10 parts inventory, numbered
    pages 2-8: assembly steps with exploded views and motion arrows
    page 9: final assembly on tube with saddle
    gen_focuser_comic.py — pipeline: trimesh loads each STL, decimates heavy
    meshes to 4k faces, matplotlib renders with Poly3DCollection + Lambert
    shading, rasterized=True keeps PDF size at ~2.4MB (vs 70MB raw vectors).
2026-05-15 Fix final-step render: use native STL positions + highlight saddle orange
    Step 8 was a jumble — parts placed with arbitrary hand-tuned Z translations
    collided and stacked weirdly, and the saddle was hovering 13mm above the
    tube and 13mm below the focuser with no contact to either.
    Inspected each STL's native bounds: most parts (outer bottom/top, inner,
    ring, collet, grub, grub panel) are already in their assembly position.
    Only collet nut and 1.25 adapter are stored flat for printing — they get
    single +Z translations to land on top of the inner thread.
    Saddle now:
    - Sits at Z=-52 (top), 10mm explode-down from focuser bottom for visibility
    - Tube tangent-contacts saddle bottom at Y=0 (Z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
2026-05-15 Make saddle clearly visible in step 8: bigger explode + side-on camera
    Tight contact (no gap) hid the saddle behind the tube's curve from
    any oblique angle — the tube's R=129mm dominated the frame and
    occluded the 10mm-thick saddle.
    Fix:
    - Explode saddle down by 15mm (was 5) — clear visual separation
    - Camera elev=5 azim=-70 — near-side view, three-layer sandwich obvious
    - Re-add motion arrow focuser→saddle
2026-05-16 Add printable mirror cell as alternative to plywood Stellafane cell
    Two STLs (front Ø215mm round + back Y-plate Ø250mm) with same hole pattern
    as the plywood version, generated via trimesh CSG. Back plate has three
    integrated vertical tabs at the ear tips that replace the metal angle
    brackets — bolts go radially from outside the tube through the wall into
    each tab. All holes are M5 clearance; no printed threads.
    [Mirror_cell_back.stl, Mirror_cell_front.stl]
2026-05-16 Fix mirror cell hole layout: push-pull pairs at each ear (not offset)
    The previous geometry put pull holes at 60°/180°/300° per the literal
    assembly_guide spec ("between push bolts"), but on the Y-shaped back
    plate those angles fall in the carved-away scallop regions — the 3 pull
    holes silently vanished into empty space.
    The standard 3-point collimation cell uses push-pull PAIRS on the same
    radial line at each of the 3 ears. Both plates now have 6 holes at the
    same XY positions, lined up: push r=95 and pull r=80, at ear angles
    0°/120°/240°. assembly_guide.md updated to match.
    [Mirror_cell_back.stl, Mirror_cell_front.stl]
2026-05-16 Mirror cell: revert to staggered push/pull layout and shrink scallops
    Stellafane plan1/plan2 confirm: push (outer, r=95) at 0°/120°/240° and
    pull (inner, r=80) at 60°/180°/300° — the two sets alternate every 60°
    on different radii. Previous "paired on the same ear" commit was wrong.
    Pull holes sit in the carved-away region between the Y-plate's ears, so
    the back-plate scallops were reduced from R=120 to R=105 (inner reach
    85 → 90). Each pull hole now has ~10mm of material around it (verified
    geometrically). assembly_guide.md updated to spell out the actual
    angles and link to the Stellafane chertyozh image.
    [Mirror_cell_back.stl, Mirror_cell_front.stl]
2026-05-16 Rework mirror cell: Stellafane radii, retainers on front, no back tabs
    Three corrections at once:
    1. Remove tabs from back Y-plate. Plate goes into the tube directly;
    M5x12 bolts pass radially from outside the tube wall straight into
    the ear edge through a pre-drilled Ø5.5mm clearance hole at each
    ear (added at angles 45°/165°/285°, on the plate mid-thickness).
    2. Add 3 mirror-retention уголки to the front plate at angles
    0°/120°/240°. Each is a vertical wall 3x20x8mm with the inner
    face at r=104.5mm — 3.5mm radial gap to the mirror edge, matching
    Stellafane's "1/8 inch gap" spec. Outer face clipped to plate
    edge so corners don't overhang.
    3. Swap push/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
    [Mirror_cell_back.stl, Mirror_cell_front.stl]
2026-05-16 Mirror cell: switch to uniform 60° spacing of the 6 collimation bolts
    Previously push was at 30°/150°/270° and pull at 60°/180°/300° (Stellafane
    30°/30°/60° pattern), which left an uneven gap between adjacent holes.
    Now push sits at 0°/120°/240° and pull at 60°/180°/300°, so all six bolts
    march around the plate every 60° (alternating ring on each step). Same
    on both plates — bolts still pass straight through.
    Back Y-plate ears moved to 30°/150°/270° (the bisector of each push+pull
    pair) and scallops to 90°/210°/330° (between pairs). Scallop R shrunk
    105→110→back to 110 for ~11mm clearance around the pull holes. Front-plate
    retainers moved to 30°/150°/270° (b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
    [Mirror_cell_back.stl, Mirror_cell_front.stl]
2026-05-17 Front plate: taller retainers (8mm→58mm), thicker (3mm→3.5mm), add Ø10×4mm bolt-head counterbores
    Retainer walls now reach well above the mirror's reflective surface so
    they double as a visual guide when lowering the mirror down the tube
    during installation. Slightly thicker (3.5mm) for stiffness at the new
    height.
    Each of the 6 collimation holes on the FRONT plate now has a Ø10mm
    counterbore 4mm deep (half plate thickness) cut into the TOP surface.
    M5 hex bolt heads (~8.5mm AF, ~4mm tall) sit fully recessed — the
    plate top stays flat where the felt pads and mirror sit, instead of
    having the bolt heads competing with felt for height.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
    [Mirror_cell_front.stl]
2026-05-24 Add truss tube assembly: UTA ring, spider, secondary holder, mirror box, leg brackets, sockets
    [Cell_leg_bracket.stl, Mirror_box.stl, Secondary_holder.stl, Spider_4vane.stl, Truss_socket.stl, UTA_ring.stl]
2026-05-24 Truss: print quantities in README + wordless assembly comic PDF
    - README tables now list how many of each STL to print (15 total)
    - New truss_assembly_comic.pdf: 8-step exploded-view guide, IKEA-style,
    no text — inventory page + step-by-step with the new part highlighted
    orange and red arrows showing motion
2026-05-28 Truss: fix Spider + Socket — weld to single watertight body
    Spider_4vane was 5 separate bodies (hub + 4 vanes touching only at a
    tangent line). Vanes now pass through hub center; all holes drilled
    after union.
    Truss_socket was 3 bodies (clamp cylinder + 2 floating wings, 14mm
    diagonal gap). Added a 7×7×50mm corner bridge that overlaps both
    wings and the clamp cylinder.
    [Spider_4vane.stl, Truss_socket.stl]
2026-06-02 Truss socket: make nut hex pocket through-hole (no back wall)
    The blind 5mm hex pocket had a back wall = hexagon-minus-circle annulus,
    which any triangulator slices into 6 spokes from hex vertices to the
    Ø5.5 bolt hole. Looked like a star in STL viewers (Preview, Bambu).
    Making the hex through the full 9mm lug thickness eliminates the back
    wall entirely. M5 nut now bears on the inner face of the lug (at the
    clamp slit) — structurally equivalent, just shifted bearing surface.
    1570 → 1384 faces, watertight, genus 4 (correct).
    [Truss_socket.stl]
2026-06-05 Truss: combine cell back plate + legs into one part, bolt straight to box
    - Add Mirror_cell_back_truss.stl: back plate with 3 integrated legs that
    seat on the existing box-floor bosses and bolt down with 3 M5 from below.
    Replaces the reused back plate + separate leg brackets + horizontal bolts.
    - Rigid mount; collimation and axial focus stay on the cell's push-pull,
    so the M8 height studs/wing nuts are dropped (saves hardware + cost).
    - Rewrite old Cell_leg_bracket as a rigid bracket (now superseded by the
    combined part); fixes the M5 bolt / M8 stud bore intersection bug.
    - Update README parts list (13 printed) and shopping_list_delta.
    - Add diagram/render scripts + images documentin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
    [Cell_leg_bracket.stl, Mirror_cell_back_truss.stl]
2026-06-20 Add GoTo + Push-To upgrade plan and AliExpress order list
    Two-stage plan (push-to encoders now, OnStep motorized GoTo later) with
    vetted AliExpress items, quantities, prices, and build/firmware gotchas.
2026-07-03 TrussRocker: план рокера из трубок, венец 42:1 (4×90°), сборочный комикс, очередь печати
    - truss/rocker_plan.md — полный план: архитектура, математика привода (42:1/17:1),
    реальные размеры с моделей Leavitt v2 (колесо Ø200×15, межколёсное 320/360),
    риски и решения, порядок стройки
    - truss/generate_rocker_azdrive.py — венец 224T mod2 Ø448 в 4 сегментах под H2D,
    шестерня 16T, тест зацепления
    - truss/gen_rocker_comic.py + rocker_assembly_comic.pdf — сборка в 13 картинка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
    [01_Rocker_mesh_test_x1.stl, 02_Rocker_pinion_16T_x1.stl, 03_Rocker_ring_segment_x4.stl, 04_magnet_cap_azimuth_x1.stl, 05_magnet_cap_altitude_x1.stl, 06_board_holder_x2.stl, Ref_leavitt_wheel.stl, Rocker_mesh_test.stl]
2026-07-03 Mesh test: Г-консоль вилки → П-мостик (печать без поддержек, ось в двух опорах)
    Bambu Studio ругался на floating cantilever — перекладина держалась на одной
    колонне. Теперь две колонны по бокам шестерни, перекладина мостиком 44мм.
    [01_Rocker_mesh_test_x1.stl, Rocker_mesh_test.stl]
2026-07-03 Тест зацепления v3 по итогам печати: отверстия +0.4/8.5 (FDM-усадка), перекладина отдельной плоской деталью на M3 (мост с дыркой давал лохмотья)
    [01_Rocker_mesh_test_x1.stl, 01b_Rocker_mesh_bridge_x1.stl, 02_Rocker_pinion_16T_x1.stl, Rocker_mesh_bridge.stl, Rocker_mesh_test.stl, Rocker_pinion_16T.stl]
2026-07-03 V2-узлы азимута: настольный комплект (ступица, сёдла, прямой привод, втулка+энкодер) + боевой качающийся кронштейн с ремнём 3:1
    Сгенерено двумя агентами, третий проверил геометрию сборкой STL: все 7 деталей
    watertight, посадки 608/NEMA17/M10 в допуске 0.05мм, межосевое ремня 58.6,
    шарнир на касательной через пятно зацепления, нулевые пересечения в сборе.
    [03_Rocker_ring_segment_x4.3mf, 07_Rocker_hub_ground_x1.stl, 08_Rocker_ring_saddle_x3.stl, 09_Rocker_az_motor_plate_x1.stl, 10_Rocker_pinion_16T_direct_x1.stl, 11_Rocker_pivot_flange_x1.stl, 12_Rocker_swing_arm_x1.stl, 13_Rocker_swing_base_x1.stl]
2026-07-04 autoslice.py: автономная нарезка H2D без GUI (проект-шаблон + пересадка конфига + overrides)
    Обход сломанного CLI-маппинга двухсопельника: конфиг из GUI-сохранённого
    проекта пересаживается в CLI-собранный, ключи подкручиваются кодом.
    Проверено: plate3_bench.gcode.3mf (ступица+сёдла+шестерня+втулка, 3ч54м, 105г).
    [plate3_bench.gcode.3mf]
2026-07-04 Плита 3: добавлена забытая моторная плита (09), перенарезано
    [plate3_bench.gcode.3mf]
2026-07-04 Обновлённые проекты студии (шаблон сегментов + проект сёдел), result.json в gitignore
    [03_Rocker_ring_segment_x4.3mf, 08_Rocker_ring_saddle_x3.3mf]
2026-07-04 autoslice: принудительная посадка STL на стол (z=0) + превью плиты; нарезана шестерня 02 для авто-теста
    [pinion02_auto.gcode.3mf]
2026-07-04 Картинка: стенд vs боевой рокер (сборки из реальных STL)
2026-07-04 Зажим труб от сына: обмерен и сохранён как компонент (гнездо Ø22, болт M4, разрезной хомут)
    Из 'Primary Base.stl' (нижнее кольцо зеркала) вырезан рабочий зажим штанги.
    Подтверждает диаметр труб Ø22. Профиль встроим во все узлы рокера вместо
    изобретения своего.
    [son_Primary_Base.stl, son_tube_clamp.stl]
2026-07-04 Трубный пакет: 13 узлов рокера (земля+ферма+башни) на зажиме сына + карта распила
    tube_clamp.py — переиспользуемый модуль хомута сына (гнездо Ø22, через place_clamp).
    Генераторы ground/frame/towers + alt-drive. Проверка сборкой: все watertight,
    влезают на H2D, оси труб сходятся точно. Фиксы: убраны 2 лишних сокета башен,
    сварена расцепившаяся лапа привода высоты. Карта распила: 14 отрезков, 4.26м.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
    [03_Rocker_ring_segment_x4.3mf, 08_Rocker_ring_saddle_x3.3mf, 14_Rocker_hub_truss_x1.stl, 15_Rocker_leg_truss_x3.stl, 16_Rocker_ring_saddle_tube_x3.stl, 17_Rocker_corner_node_30_x1.stl, 18_Rocker_corner_node_150_x1.stl, 19_Rocker_corner_drive_x1.stl]
2026-07-04 Переделка узлов: хомуты на шейках, разрез в свободную сторону (вверх/наружу), убраны дуги R200
    По фидбеку: хомуты не сжимались (разрезы упирались в соседей/ступицу),
    седло R200 давило на разрез. Теперь каждый хомут вынесен на шейку от ступицы,
    разрез в открытое пространство (проверено: 24/24 свободны), седло венца вынесено
    вбок отдельным пьедесталом. corner_drive: убрана плавающая стружка. Все wate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
    [14_Rocker_hub_truss_x1.stl, 16_Rocker_ring_saddle_tube_x3.stl, 17_Rocker_corner_node_30_x1.stl, 18_Rocker_corner_node_150_x1.stl, 19_Rocker_corner_drive_x1.stl, 20_Rocker_center_node_x1.stl, 21_Rocker_tower_apex_R_x1.stl, 22_Rocker_tower_apex_L_x1.stl]
2026-07-04 Узлы переписаны начисто: хомут = параметрический цилиндр, узел = цилиндры + ядро + функции
    По утверждённому эталону (_proto_reference.py). tube_clamp больше не тащит меш
    сына — чистый разрезной цилиндр (бор Ø22.4, стенка 4, OD 30.4, разрез вверх,
    проушины M5). Все 12 узлов: убраны пады/косынки/дуги/шейки, только цилиндры +
    минимальное ядро + функции (M10, полка энкодера, пад привода, ролики). Втрое-
    вчетверо легче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
    [14_Rocker_hub_truss_x1.stl, 15_Rocker_leg_truss_x3.stl, 16_Rocker_ring_saddle_tube_x3.stl, 17_Rocker_corner_node_30_x1.stl, 18_Rocker_corner_node_150_x1.stl, 19_Rocker_corner_drive_x1.stl, 20_Rocker_center_node_x1.stl, 21_Rocker_tower_apex_R_x1.stl]
2026-07-04 Разделение печати: стенд (01-13) в print_queue/, трубный рокер (14-26) в print_queue/tube_frame/
    + хомут: болт затяжки сдвинут к входному торцу (где труба внутри, не в середину).
    + убраны прототипы _PROTO_*.stl. Топология v3 (углы=2 хорды, центр→середины
    хорд) переписывается отдельно.
    [14_Rocker_hub_truss_x1.stl, 15_Rocker_leg_truss_x3.stl, 16_Rocker_ring_saddle_tube_x3.stl, 17_Rocker_corner_node_30_x1.stl, 18_Rocker_corner_node_150_x1.stl, 19_Rocker_corner_drive_x1.stl, 20_Rocker_center_node_x1.stl, 21_Rocker_tower_apex_R_x1.stl]
2026-07-04 Топология v3 раскатана на всю раму: углы=2 хорды, центр→середины хорд, +узел-середина
    13 узлов переписаны: все трубы разнесены ≥60° (кроме башенных ног 37-42° —
    неизбежно, задний угол кормит обе башни), разрезной хомут с ушками, болт у
    входного торца, разрез вверх. Все watertight, влезают H2D, компактные (35-91см³).
    Новый узел Rocker_midchord_node ×3 (2 полухорды 180° + радиаль 90°). Карта
    распила v3: полухорды 182×6,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
    [14_Rocker_hub_truss_x1.stl, 15_Rocker_leg_truss_x3.stl, 16_Rocker_ring_saddle_tube_x3.stl, 17_Rocker_corner_node_30_x1.stl, 18_Rocker_corner_node_150_x1.stl, 19_Rocker_corner_drive_x1.stl, 20_Rocker_center_node_x1.stl, 20_Rocker_midchord_node_x3.stl]
2026-07-04 Фикс собираемости узлов: сквозной бор (труба входит на полную глубину), башни разнесены, люлька вварена массивом, гнёзда привода закрыты
    Тест вставки трубы Ø22 во все гнёзда PASS 0.0%. Cradle стык 748→3264мм² (×4.4).
    alt_drive платформа перецентрирована. Все watertight single-body.
    [14_Rocker_hub_truss_x1.stl, 15_Rocker_leg_truss_x3.stl, 17_Rocker_corner_node_30_x1.stl, 18_Rocker_corner_node_150_x1.stl, 19_Rocker_corner_drive_x1.stl, 20_Rocker_midchord_node_x3.stl, 21_Rocker_center_node_x1.stl, 22_Rocker_tower_apex_R_x1.stl]
2026-07-04 Компоновка ALT-яруса пересчитана по виртуальной сборке: 0 коллизий
    Виртуальная сборка (assemble_check.py) выявила кучу-малу верхнего яруса — исправлено
    пересчётом компоновки: APEX_Z 530→460 (поперечина+апекс под ободом Ø200), ролики
    r=111→117.5 (тангентны Ø200), R_TUBE_IN 35→11 (ступица держит трубу 5→28мм), BUSH_Z0
    50→58 (центр не трётся о ступицу). Люлька+привод переписаны под низкий ярус (привод
    крутит боковой рол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
    [17_Rocker_corner_node_30_x1.stl, 18_Rocker_corner_node_150_x1.stl, 19_Rocker_corner_drive_x1.stl, 21_Rocker_center_node_x1.stl, 22_Rocker_tower_apex_R_x1.stl, 23_Rocker_tower_apex_L_x1.stl, 24_Rocker_cradle_R_x1.stl, 25_Rocker_cradle_L_x1.stl]
2026-07-05 corner_drive: убрано вырожденное 0-см³ тело (manifold-ремонт + чистка nondegenerate в finish)
    [14_Rocker_hub_truss_x1.3mf, 19_Rocker_corner_drive_x1.stl, Rocker_corner_drive.stl]
2026-07-05 Поясняющая картинка азимута: статор (венец+земля, синее) vs ротор (рама+башни, оранж)
    Показывает как венец внизу неподвижен, рама вращается на оси M10, глайды едут
    по дорожке венца, шестерня привода цепляет венец. Проясняет компоновку азимута.
2026-07-05 Азимут: основание = ФАНЕРА (не трубная звезда). Венец болтами к фанере, рама вращается на оси
    Убрано дублирование основания. Трубная земля-звезда (hub/leg/saddle, детали 14-16)
    не нужна — венец крепится прямо к фанерному диску. Меньше печати.
2026-07-05 Финализация трубного рокера: пад привода на опоре (не висит), убрана трубная земля-звезда (венец на фанеру)
    Основание = фанера + венец (статика, единственная фанерная часть). Вращающаяся
    часть трубно-печатная (точные посадки роликов/моторов, дерево люфтит). corner_drive
    пад с косынками. tube_frame: 12 деталей (рама+башни+приводы, без земли-звезды).
    [08_Rocker_ring_saddle_x3.3mf, 14_Rocker_hub_truss_x1.stl, 15_Rocker_leg_truss_x3.stl, 16_Rocker_ring_saddle_tube_x3.stl, 19_Rocker_corner_drive_x1.stl, Rocker_corner_drive.stl, frame_A.gcode.3mf]
2026-07-05 Картинка решения в целом: фанера-основание+венец / трубная вращ.рама+башни / колёса / приводы
2026-07-05 Рама в отдельной папке print_queue/rama (7 узлов) + проверка согласования с венцом
    Углы верные под реальный венец: глайды R210 на дорожке венца (тело R200-217),
    шестерня зацепление 240=224+16, углы 30/150/270 совместимы. README с трубками
    (полухорды 182×6, радиали 105×3) и сборкой.
    [17_Rocker_corner_node_30_x1.stl, 18_Rocker_corner_node_150_x1.stl, 19_Rocker_corner_drive_x1.stl, 20_Rocker_midchord_node_x3.stl, 21_Rocker_center_node_x1.stl]
2026-07-05 Картинка верхнего яруса: ноги башен→апексы→поперечина→люльки→ролики→колёса→привод+энкодер
2026-07-05 Папка нижней рамы (азимут): 7 узлов + привод + энкодер азимута + README для сборки/кручения. Картинки люльки и верхнего яруса
    [17_Rocker_corner_node_30_x1.stl, 18_Rocker_corner_node_150_x1.stl, 19_Rocker_corner_drive_x1.stl, 20_Rocker_midchord_node_x3.stl, 21_Rocker_center_node_x1.stl, DRIVE_pinion_16T_x1.stl, DRIVE_swing_arm_x1.stl, DRIVE_swing_base_x1.stl]
2026-07-05 Пад привода вынесен в отдельный кронштейн: corner_drive стал чистым углом
    По фидбеку 'убери лишнее': пад привода снят с узла corner_drive (давал обломки
    и микро-дыры) → узел = чистый угол как 17/18 (watertight, 44см³). Пад теперь
    отдельная деталь Rocker_az_drive_bracket (28, 4×M4 + проём Ø40, болтами к узлу).
    Все 7 узлов рамы одинаково чистые. corner_drive fill_holes → watertight.
    [17_Rocker_corner_node_30_x1.stl, 18_Rocker_corner_node_150_x1.stl, 19_Rocker_corner_drive_x1.stl, 20_Rocker_midchord_node_x3.stl, 21_Rocker_center_node_x1.stl, 28_Rocker_az_drive_bracket_x1.stl, DRIVE_pinion_16T_x1.stl, DRIVE_swing_arm_x1.stl]
2026-07-05 Пад привода ВЕРНУЛ на узел монолитом (надёжнее отдельной детали), обломки вычищены fill_holes
    По фидбеку 'почему не вместе': пад азимутального привода снова часть corner_drive
    (4×M4 под swing_base + проём Ø40 под шестерню, на опоре-массиве). Крепить отдельно
    нечего — привод болтами прямо к раме. corner_drive watertight, 0 дыр, 1 тело.
    Деталь 28 (отдельный кронштейн) удалена. finish усилен циклом fill_holes.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
    [19_Rocker_corner_drive_x1.stl, 28_Rocker_az_drive_bracket_x1.stl, Rocker_az_drive_bracket.stl, Rocker_corner_drive.stl]
2026-07-05 Плоские площадки-глайды под 3 углами рамы + рама поднята (FRAME_Z 75→82)
    По фидбеку 'куда тефлон': низ угла был круглый (хомуты). Добавлена ПЛОСКАЯ
    площадка 26×30 под каждым углом (грань вниз к дорожке венца, z=63) + отв.M3
    с зенковкой под винт тефлона. Рама поднята на 7мм — стоит на 3 площадках, а не
    на хомутах. Виртуальная сборка 0 коллизий, все узлы watertight. Ноги башен
    короче: перед 399→392, зад 470→465. tube_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
    [17_Rocker_corner_node_30_x1.stl, 18_Rocker_corner_node_150_x1.stl, 19_Rocker_corner_drive_x1.stl, 20_Rocker_midchord_node_x3.stl, 21_Rocker_center_node_x1.stl, 22_Rocker_tower_apex_R_x1.stl, 23_Rocker_tower_apex_L_x1.stl, Rocker_center_node.stl]
2026-07-05 Глайд-площадка: скользящая грань ЧИСТАЯ (винт не через неё)
    Исправлена ошибка: было сквозное M3 с зенковкой СНИЗУ (головка на скользящей
    стороне — трётся металл, не тефлон). Теперь низ площадки плоский чистый 780мм²
    под тефлон на КЛЕЙ (VHB/контактный); отверстие M3 перенесено ВВЕРХ, глухое —
    винт входит в тефлон снизу не пробивая скользящую грань. Все углы watertight 1 тело.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
    [17_Rocker_corner_node_30_x1.stl, 18_Rocker_corner_node_150_x1.stl, 19_Rocker_corner_drive_x1.stl, Rocker_corner_drive.stl, Rocker_corner_node_150.stl, Rocker_corner_node_30.stl]
2026-07-05 Глайд-площадка под размер тефлона: 15×22 (было 26×30), узкой стороной в паз венца
    По фидбеку: площадка была 26×30 — шире дорожки венца (18мм), не влезала + тефлон
    гулял. Теперь 15×22 = размер тефлон-пятака, повёрнута по радиусу (узкая 15мм
    поперёк дорожки → влезает в паз 18мм). Тефлон клеишь ровно по площадке. Все углы
    watertight. tube_frame + nizhnyaya_rama обновлены.
    [17_Rocker_corner_node_30_x1.stl, 18_Rocker_corner_node_150_x1.stl, 19_Rocker_corner_drive_x1.stl, Rocker_corner_drive.stl, Rocker_corner_node_150.stl, Rocker_corner_node_30.stl]
2026-07-05 Глайд вписан в дугу венца: центр R208.5, все 4 угла в теле R200-217
    По фидбеку 'учёл дугу?': прямоугольник на R210 углами вылезал за тело венца
    (наружн.угол R217.8 > 217, в зубья). Сдвинул центр на R208.5 + размер 16×20 →
    4 угла R200.7..216.7, все в дорожке R200-217 (проверено с учётом кривизны).
    Дугой площадку не делаю (прогиб 0.3мм). Все углы watertight, папки обновлены.
    [17_Rocker_corner_node_30_x1.stl, 18_Rocker_corner_node_150_x1.stl, 19_Rocker_corner_drive_x1.stl, Rocker_corner_drive.stl, Rocker_corner_node_150.stl, Rocker_corner_node_30.stl]
2026-07-08 Приводной угол+мотор (belt-offset 42:1): исправлена деталь, посадки проверены на меше
    - гнёзда 608 раскрыты до торцов корпуса (входят с двух сторон до среднего бортика Ø16; убран поясок-стоп, из-за которого подшипник не заходил)
    - убран лишний пад 4×M4 от swing_base (новый флаг drive_pad=False в corner_node)
    - пазы M3 и окно мотора раскрыты сквозь балку — доступ к крепёжным болтам
    - балка опущена вровень с фланцем (не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
    [17_Rocker_corner_node_30_x1.3mf, 20_Rocker_midchord_node_x3.3mf, Rocker_corner_drive_motor.3mf, Rocker_corner_drive_motor.stl, Rocker_pinion_16T.stl]
2026-07-12 Верхний ярус: седло печатается «на боку» (лес −52%, весь у дна) + столы; азимут2, стенд
    Печать седла: развёрнуто «на боку» (rotate X90+Y180, H=160) вместо «лёжа».
    Лес 11.6k→5.6k мм² и ВЕСЬ ниже z70 в блоке хомута — башен к арке нет
    (проверено лучом вниз). _make_plates.py: STOL_ALL.3mf (всё 9 деталей одним
    столом, bbox 340×292, пересечений нет) + STOL_1/2 (по седлу на стол, изоляция
    брака). Раскладка/анализ поз — _CRADLE_*.png, _STOL_ALL_layout.png.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
    [01_Rocker_tower_apex_R_x1.stl, 02_Rocker_tower_apex_L_x1.stl, 03_Rocker_cradle_R_x1.stl, 04_Rocker_cradle_L_x1.stl, 05_Rocker_alt_drive_x1.stl, 06_Rocker_alt_roller_x2.stl, 07_Rocker_alt_encoder_arm_x1.step, 07_Rocker_alt_encoder_arm_x1.stl]
2026-07-13 Азимут2: башмаки ног вместо сломанных гнёзд + спайдер 3 луча + стол 4; фикс 3mf
    Гнёзда ног на венце без поддержек не печатаются — сегменты не перепечатываем:
    generate_az2_shoes.py даёт башмаки A30/C150/D270 (наклоны 1:1 из венца, фланец
    упирается в обод зубьев, шурупы 3.5×12 вне тефлон-карманов, печать без поддержек).
    Спайдер с 3 лучами (120/210/300): бобышка сегмента A накрыта ногой 30°.
    Стол plate4_bashmaki_center (137 г) = башм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
    [az2_magnet_spider3.stl, az2_ring_rot_A_leg30.stl, az2_ring_rot_B_plain.stl, az2_ring_rot_C_leg150.stl, az2_ring_rot_D_leg270.stl, az2_ring_rot_seg.stl, az2_shoe_A30.stl, az2_shoe_C150.stl]
